lukas/hexapod-cad/stl_reference/README.md

# Reference / simulation meshes (not for printing)

Bought-part visuals, fused tibia_link stand-in, and assembly_preview.
Generated by `hexapod_prototype.py` into this directory with a
`_DO_NOT_PRINT` filename suffix.

Printables live in `../stl_prototype/`.
