lukas/hexapod-cad/vehicles/README.md

# Wheeled vehicles

Wheeled projects live here rather than under `hexapod_walker/`. Each project
owns its CAD source, generated design records, assembly instructions, and
BuildViz targets.

- [`tt_kid_truck/`](tt_kid_truck/) — printable four-wheel TT-motor pickup
  truck built around the DIANN motor/wheel and L298N kit.
