lukas/hexapod-cad/arm/stl_reference/README.md

# Reference meshes (not for printing)

Arm assembly preview generated by `arm.py` into this directory with a
`_DO_NOT_PRINT` filename suffix.

Printables live in `../stl_arm/`.
