lukas/hexapod-cad/apriltags/tag36h11_0-15_letter.pdf

tag36h11 • IDs 0-15 • print Actual size / 100% • cut on gray dashes • black square ~ 1.492 in (37.9 mm)

0 | 1 | 2 | 3
4 | 5 | 6 | 7
8 | 9 | 10 | 11
12 | 13 | 14 | 15
