lukas/hexapod-cad/apriltag_lids/out/preview_tag36h11_01-16.png

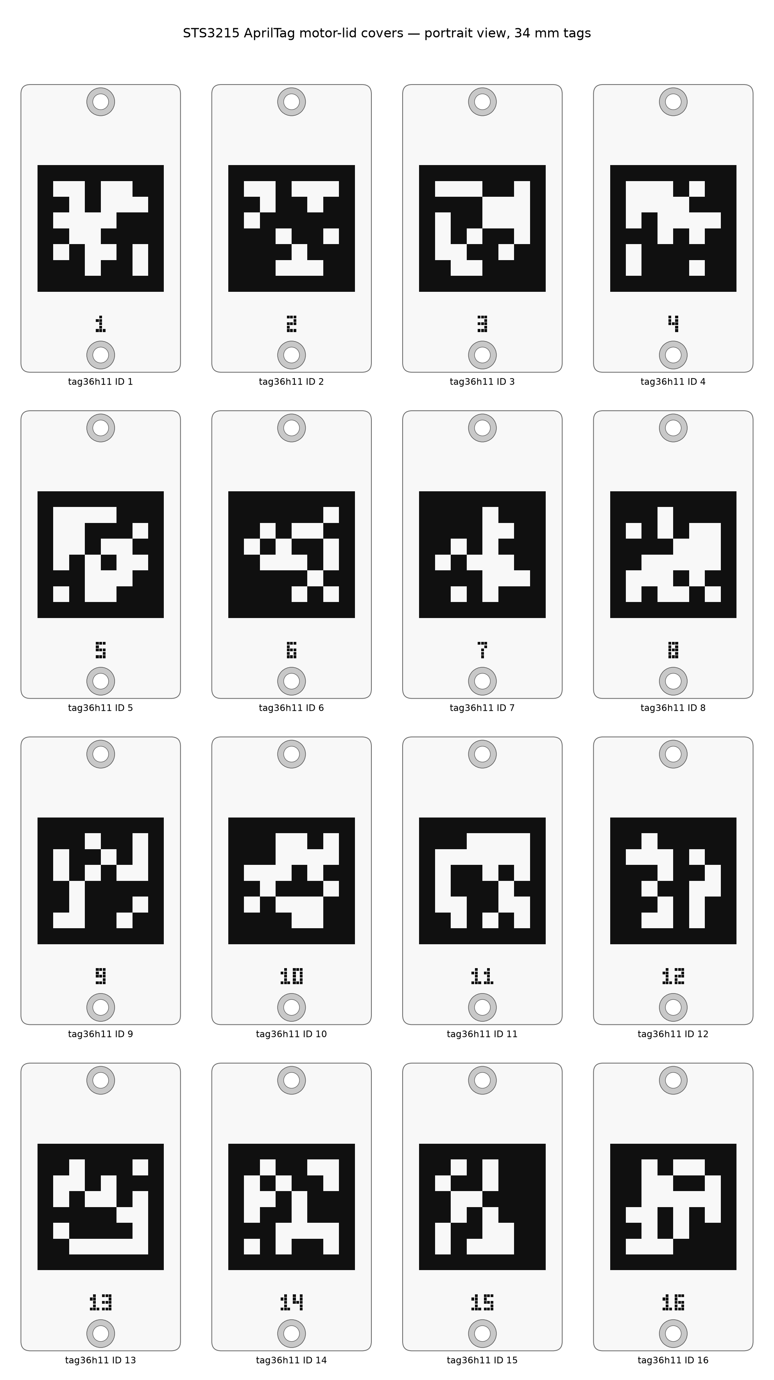
apriltag_lids/out/preview_tag36h11_01-16.png
