lukas/hexapod-cad/concepts/cnc_chorn_overhead/preview.png

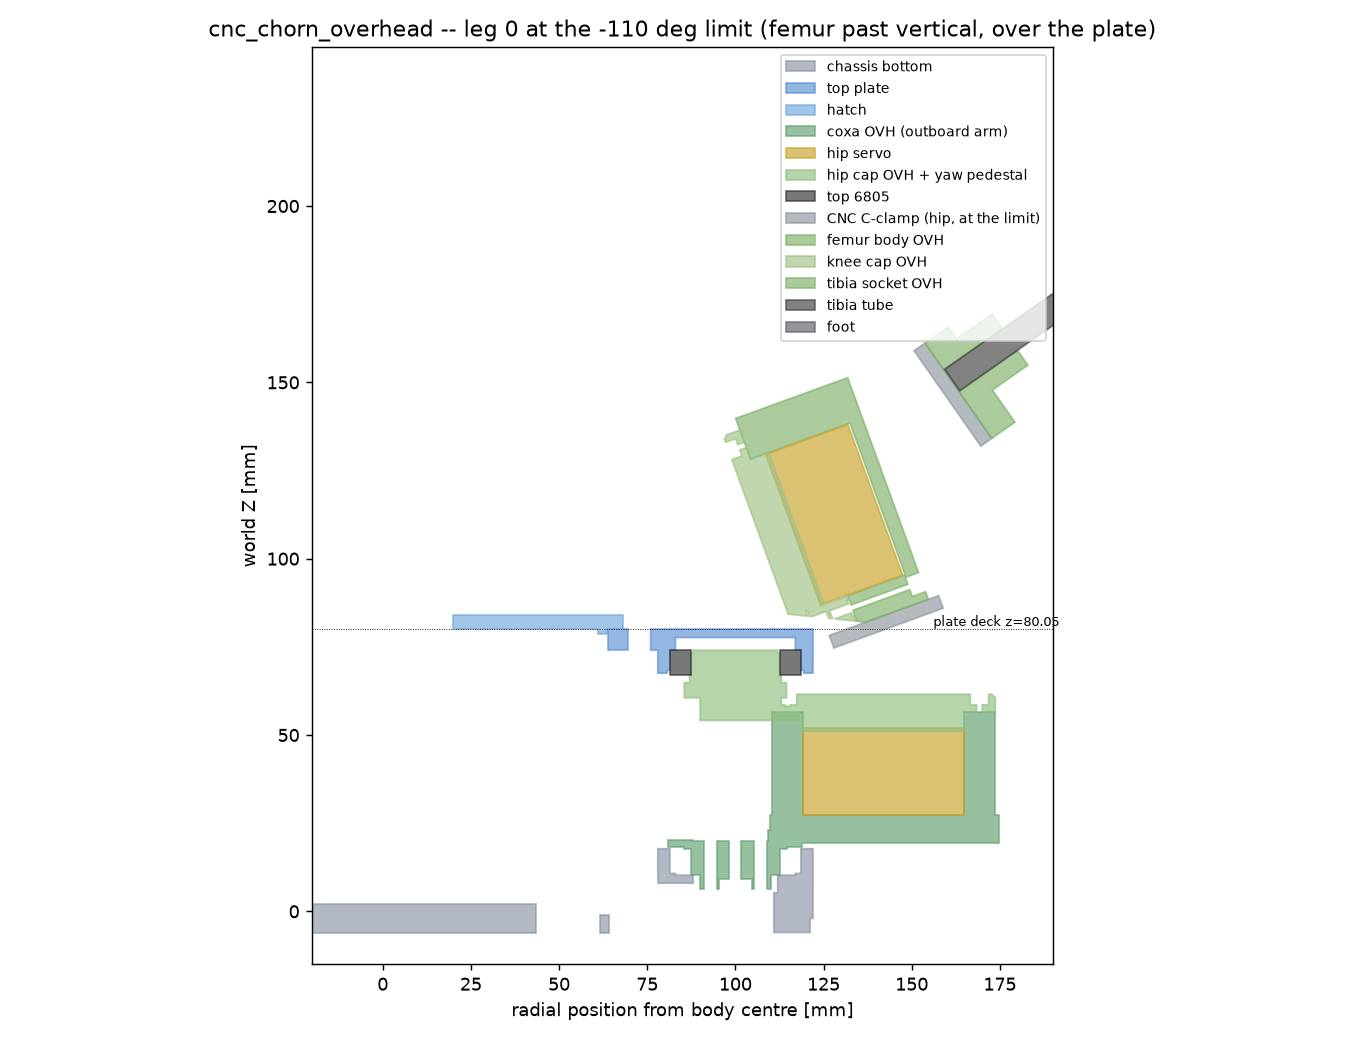
concepts/cnc_chorn_overhead/preview.png
