lukas/hexapod-cad/concepts/dovetail_coxa/preview.png

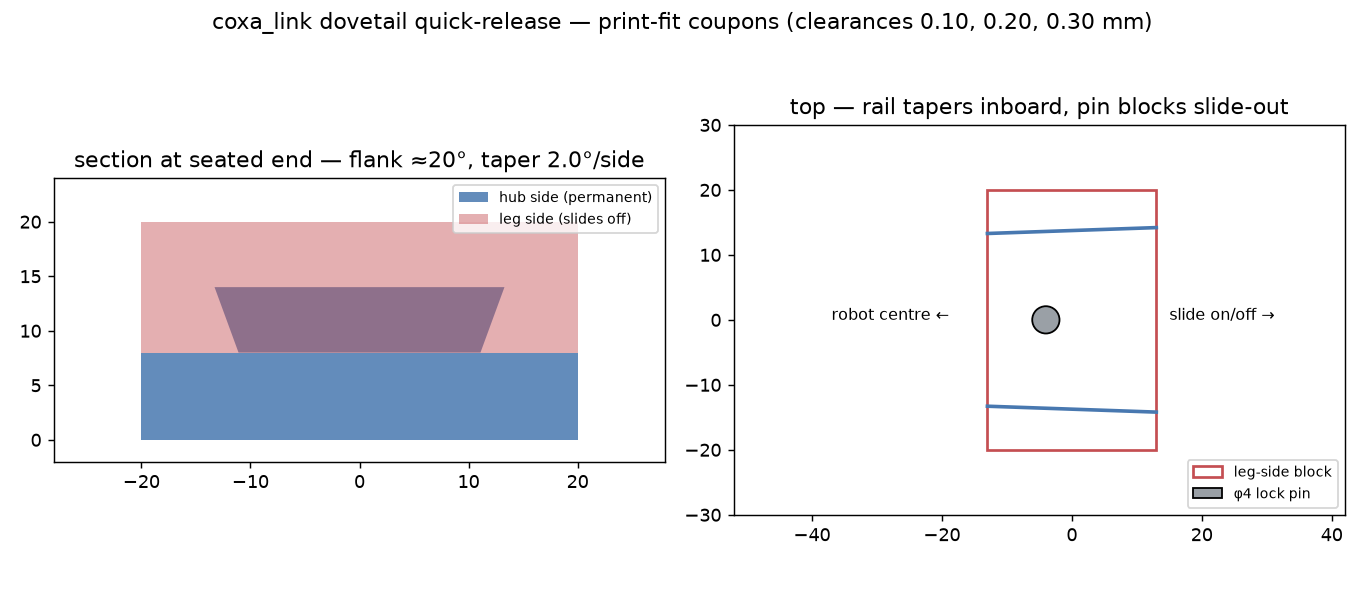
concepts/dovetail_coxa/preview.png
