lukas/hexapod-cad/concepts/dovetail_coxa/preview_split.png

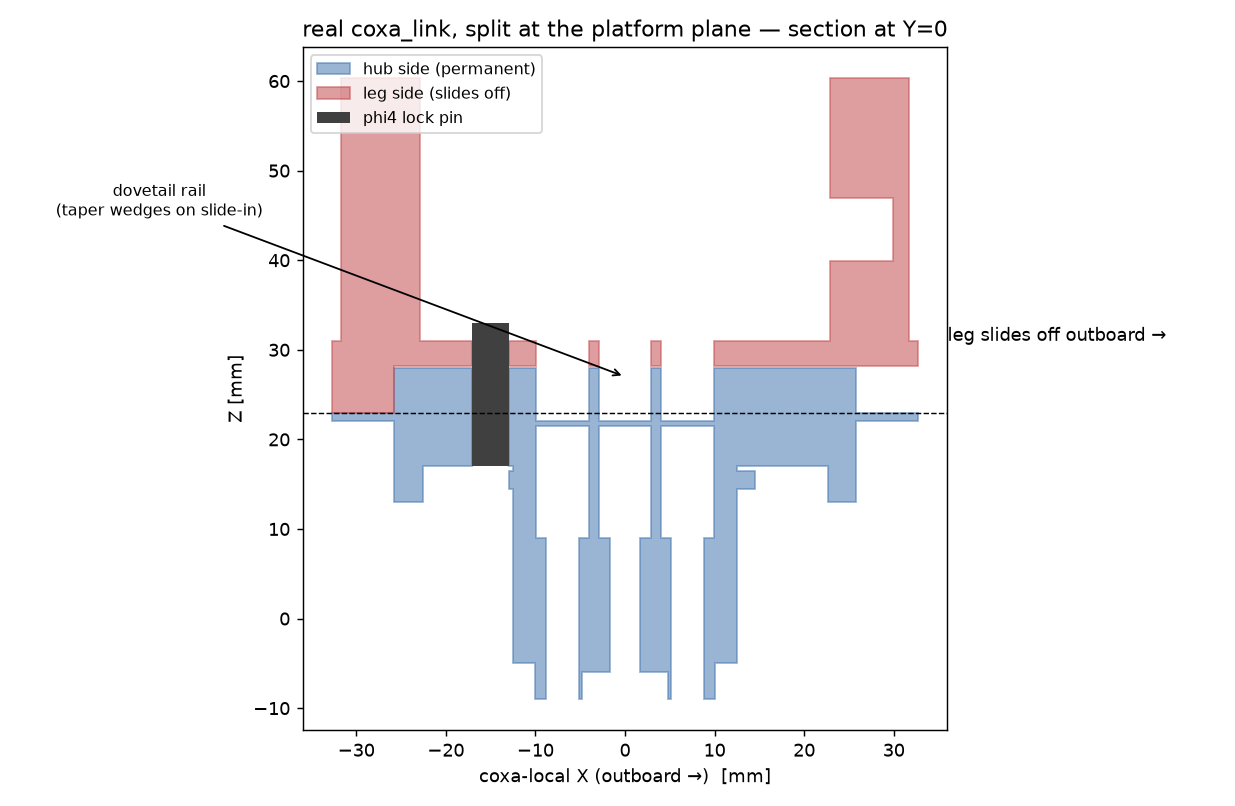
concepts/dovetail_coxa/preview_split.png
