lukas/hexapod-cad/concepts/premade_chorn_56/preview.png

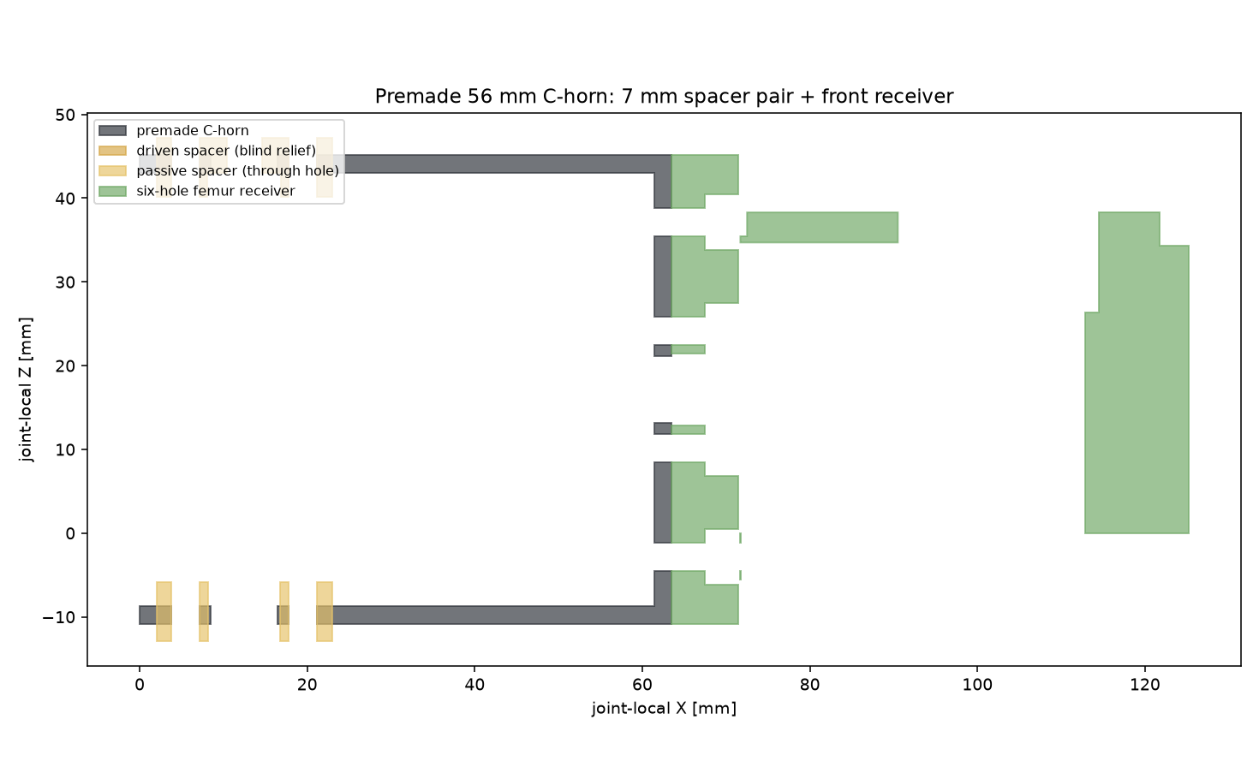
concepts/premade_chorn_56/preview.png
