lukas/hexapod-cad/concepts/qr_femur/preview.png

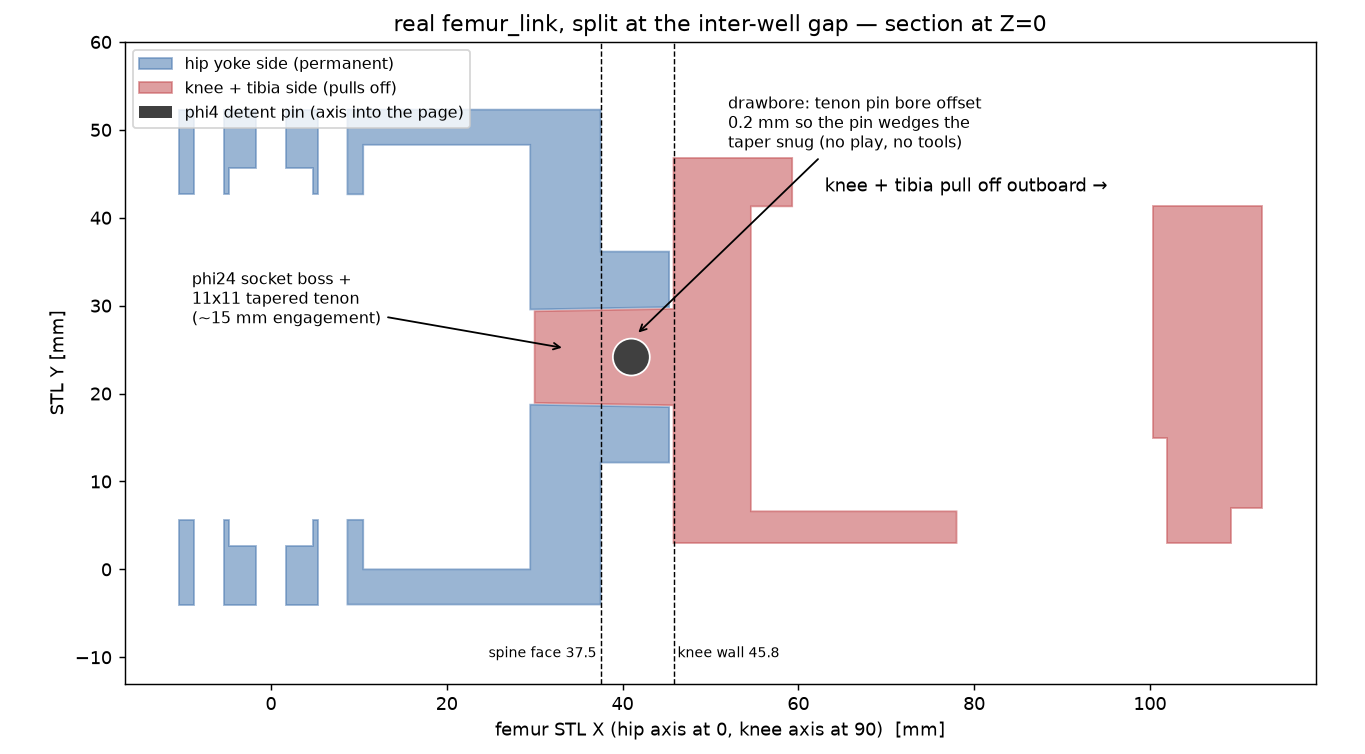
concepts/qr_femur/preview.png
