lukas/hexapod-cad/concepts/rigid_hip/bottom_joint_change.png

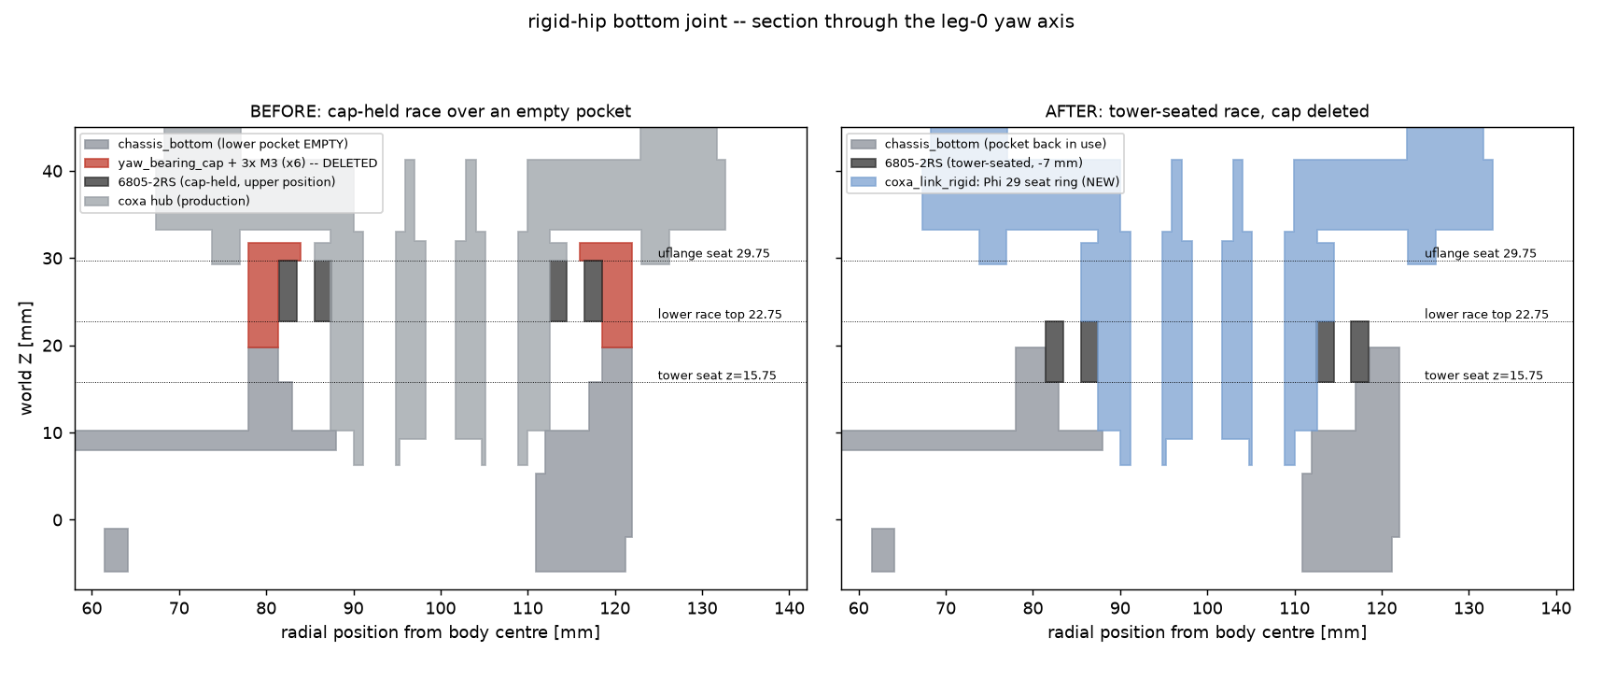
concepts/rigid_hip/bottom_joint_change.png
