lukas/hexapod-cad/concepts/rigid_hip/chassis_corner_round.png

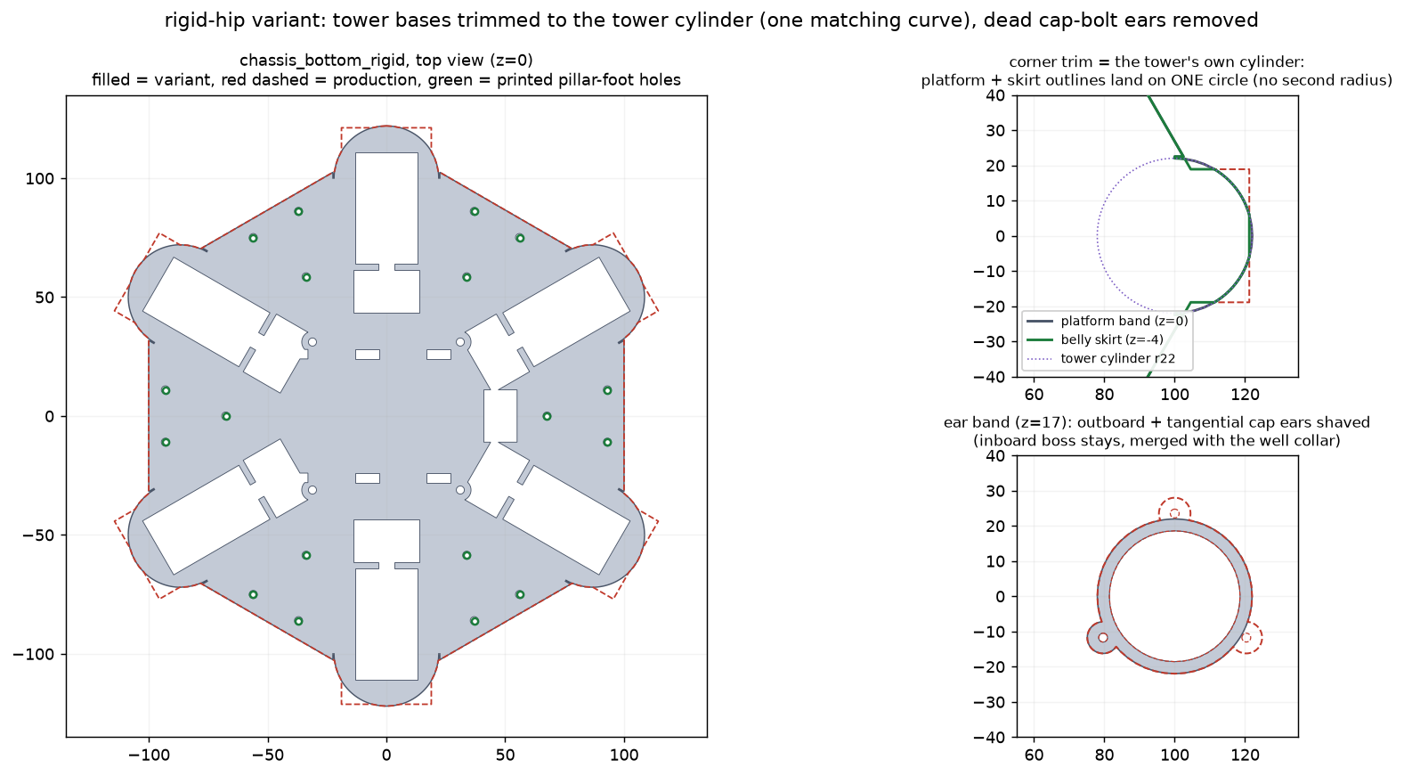
concepts/rigid_hip/chassis_corner_round.png
