lukas/hexapod-cad/concepts/rigid_hip/chassis_top_clean.png

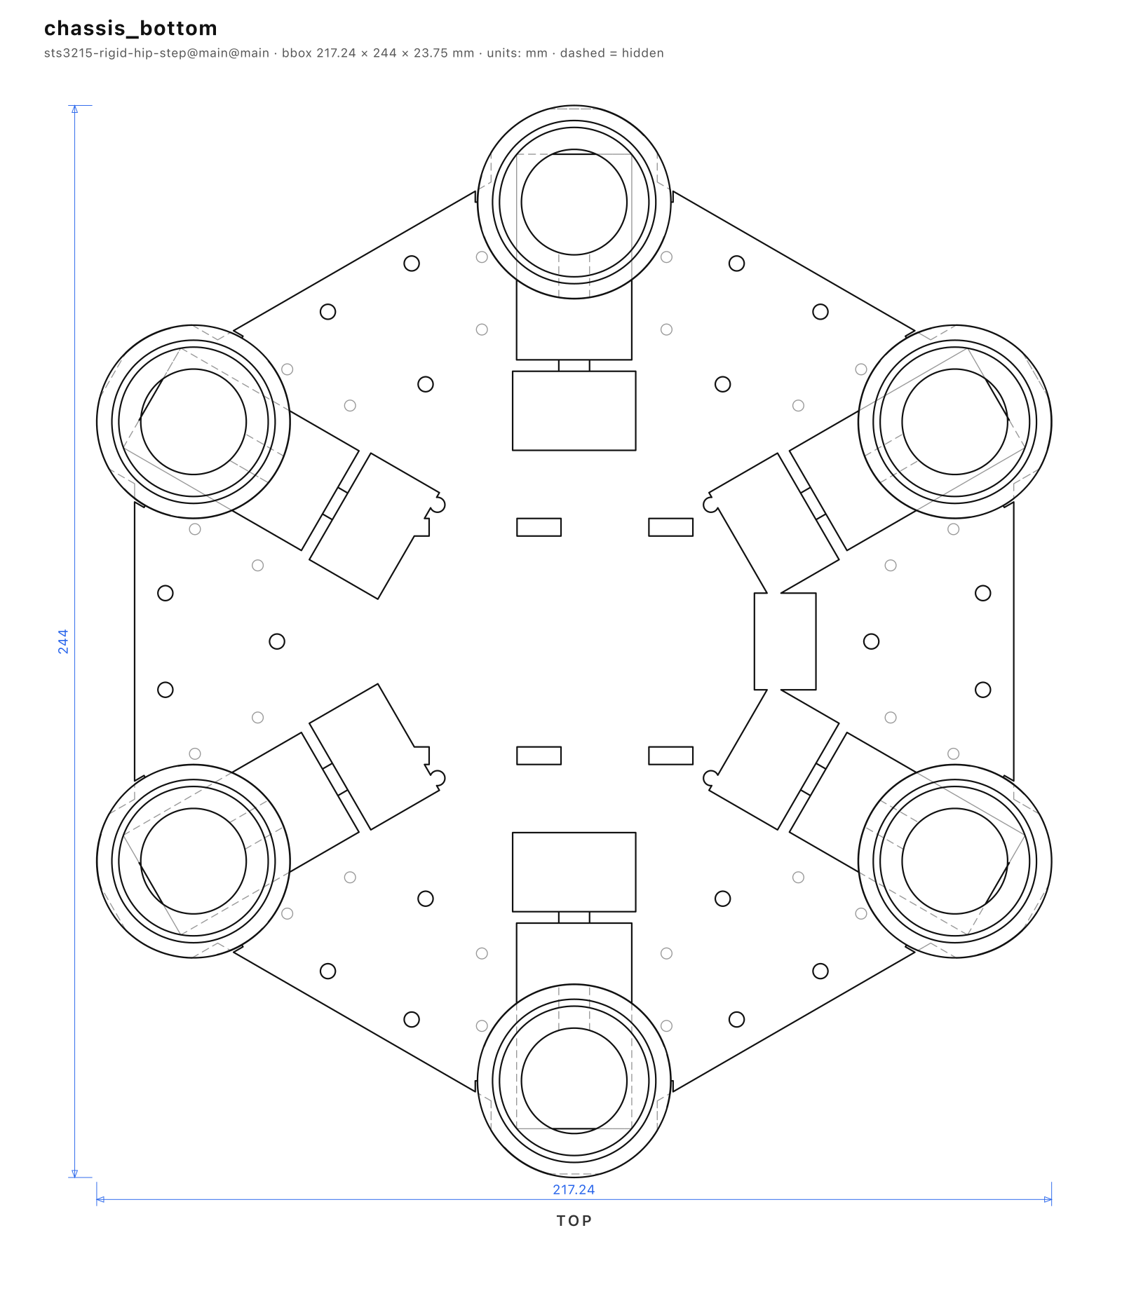
concepts/rigid_hip/chassis_top_clean.png
