lukas/hexapod-cad/concepts/rigid_hip/corner_flat_owners.png

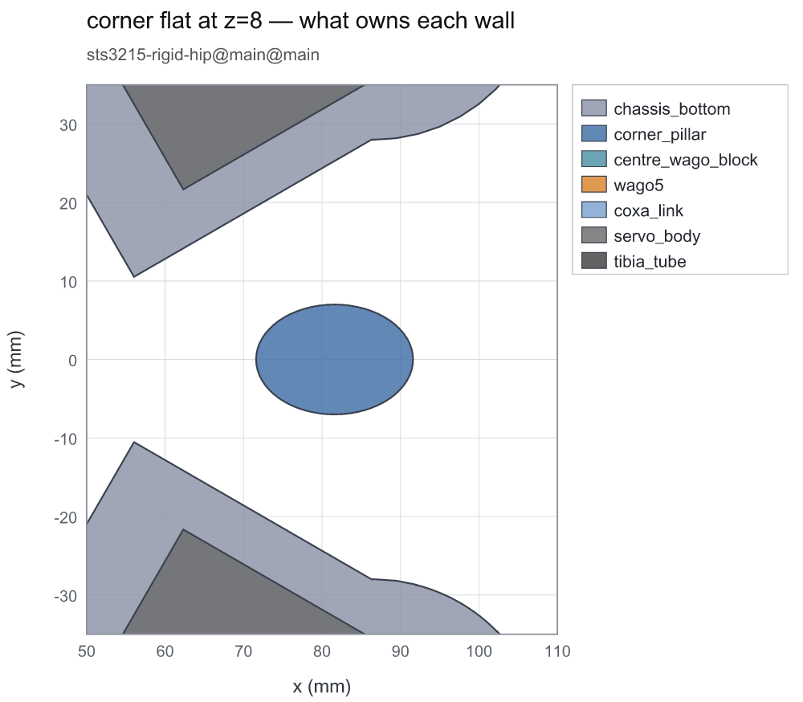
concepts/rigid_hip/corner_flat_owners.png
