lukas/hexapod-cad/concepts/rigid_hip/corner_flattened_annotated.png

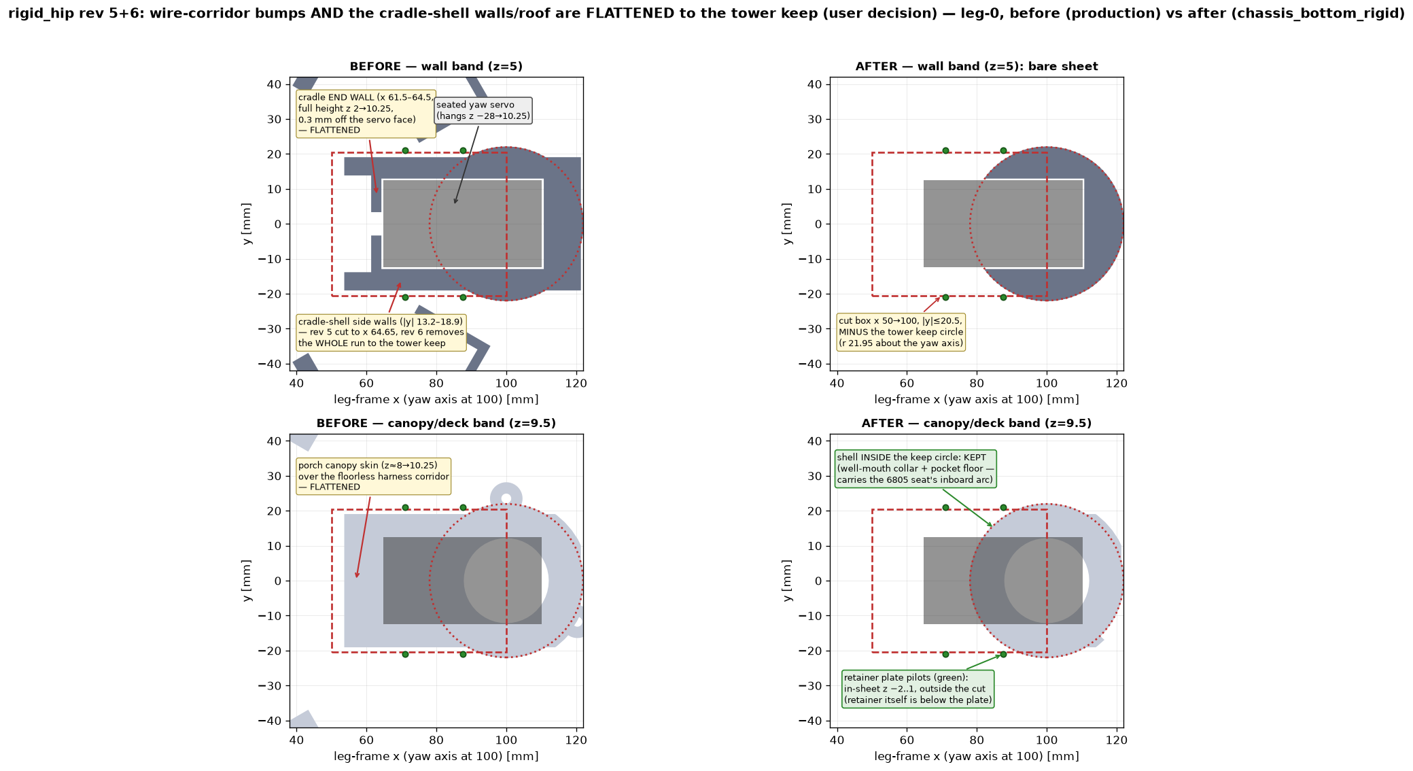
concepts/rigid_hip/corner_flattened_annotated.png
