lukas/hexapod-cad/concepts/rigid_hip/joint_column_annotated.png

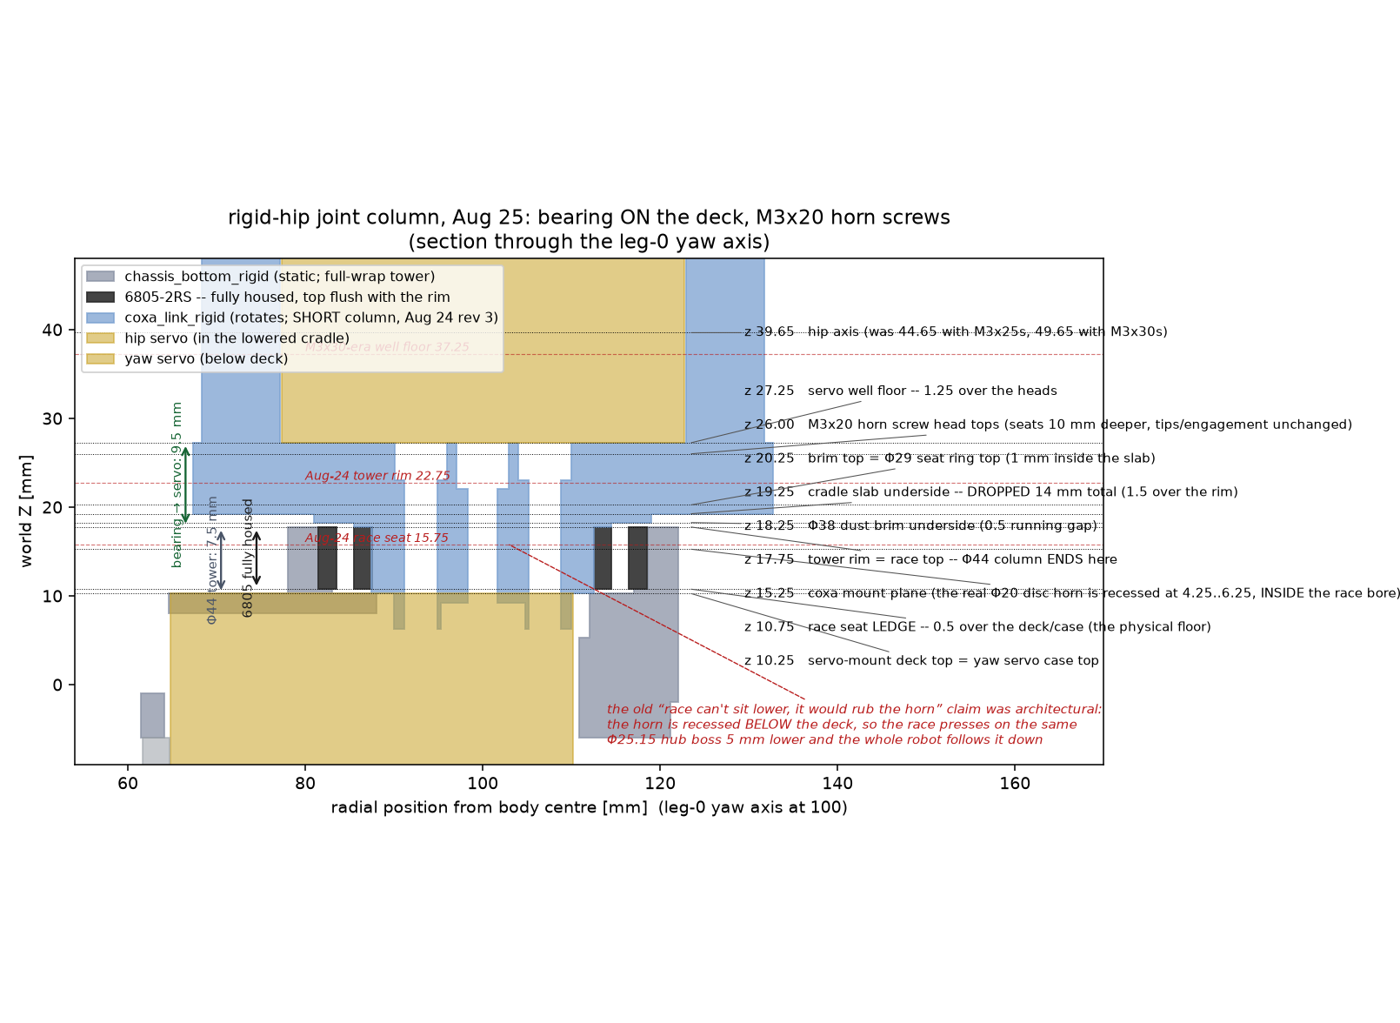
concepts/rigid_hip/joint_column_annotated.png
