lukas/hexapod-cad/concepts/rigid_hip/keepout_section.png

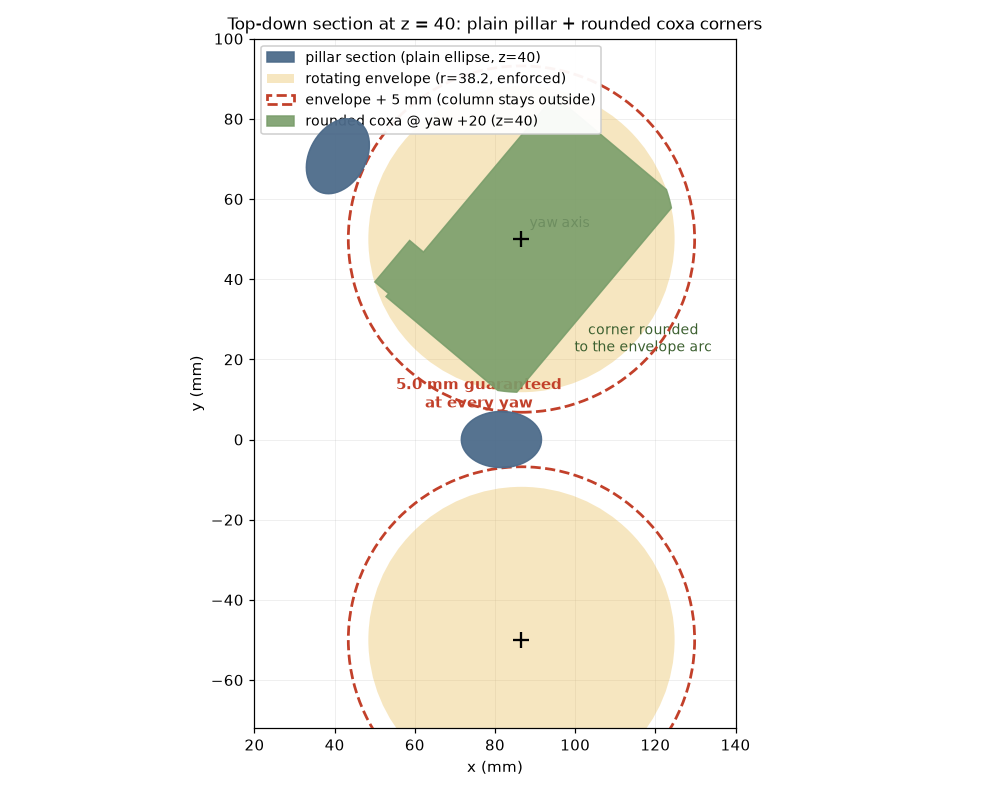
concepts/rigid_hip/keepout_section.png
