lukas/hexapod-cad/concepts/rigid_hip/pillar_context.png

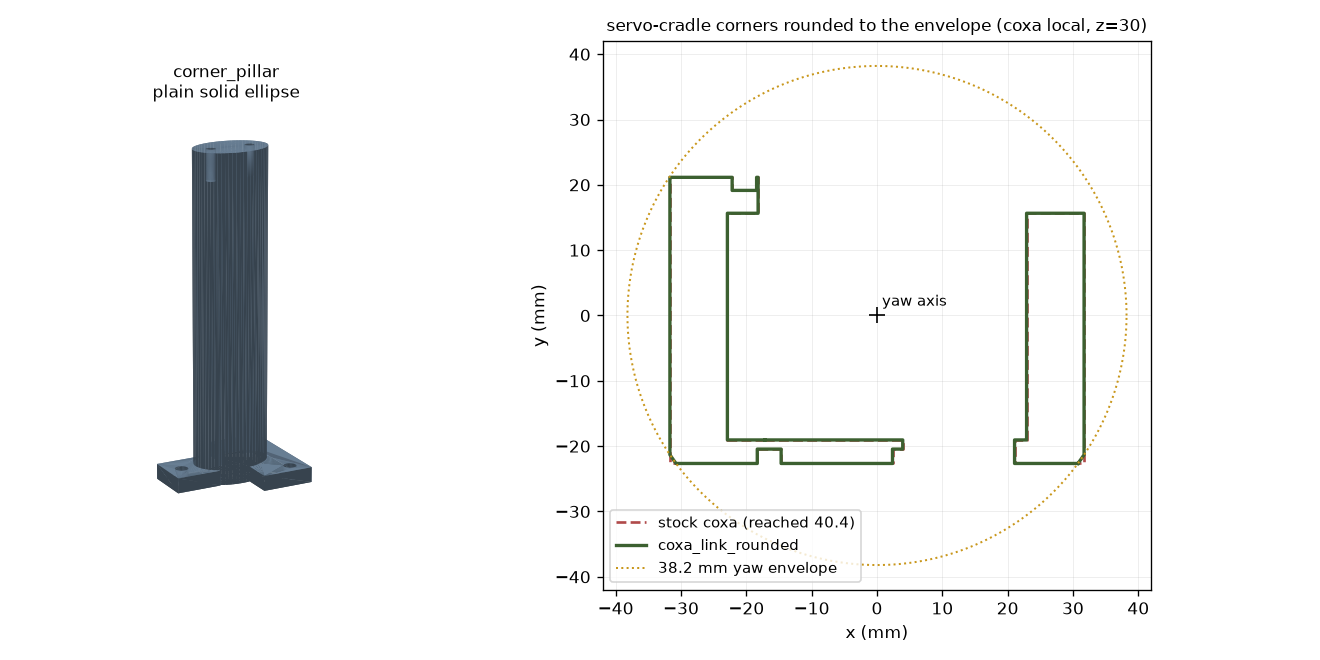
concepts/rigid_hip/pillar_context.png
