lukas/hexapod-cad/concepts/rigid_hip/pillar_stubs_annotated.png

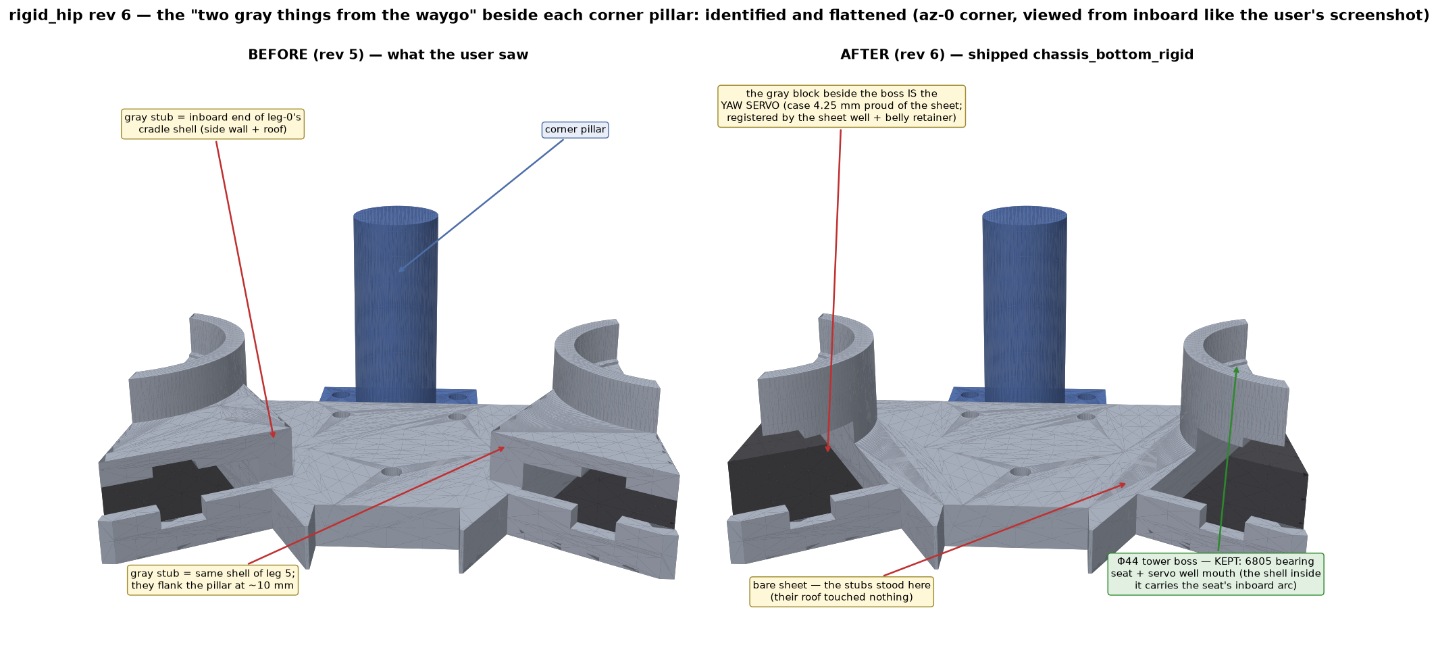
concepts/rigid_hip/pillar_stubs_annotated.png
