lukas/hexapod-cad/concepts/rigid_hip/preview.png

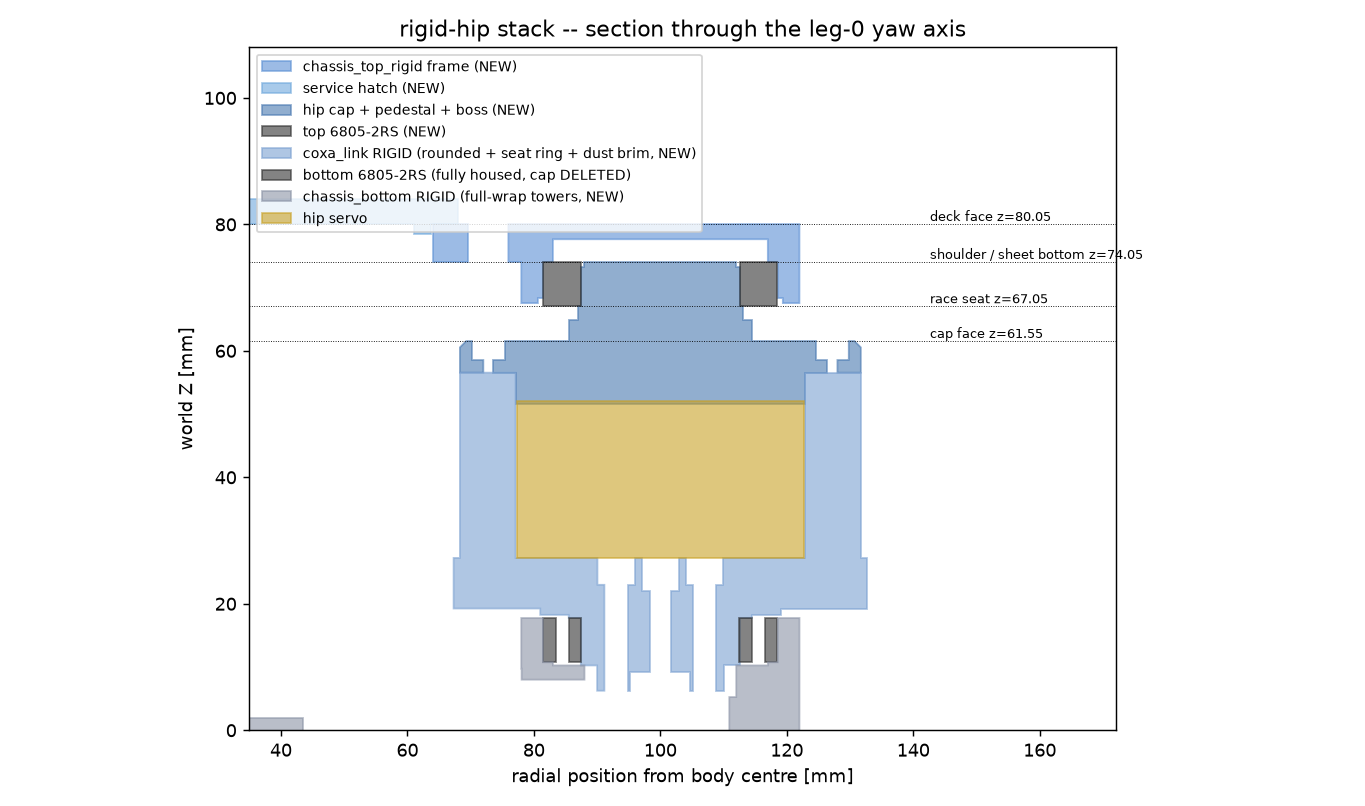
concepts/rigid_hip/preview.png
