lukas/hexapod-cad/concepts/rigid_hip/tower_flank_smoothed.png

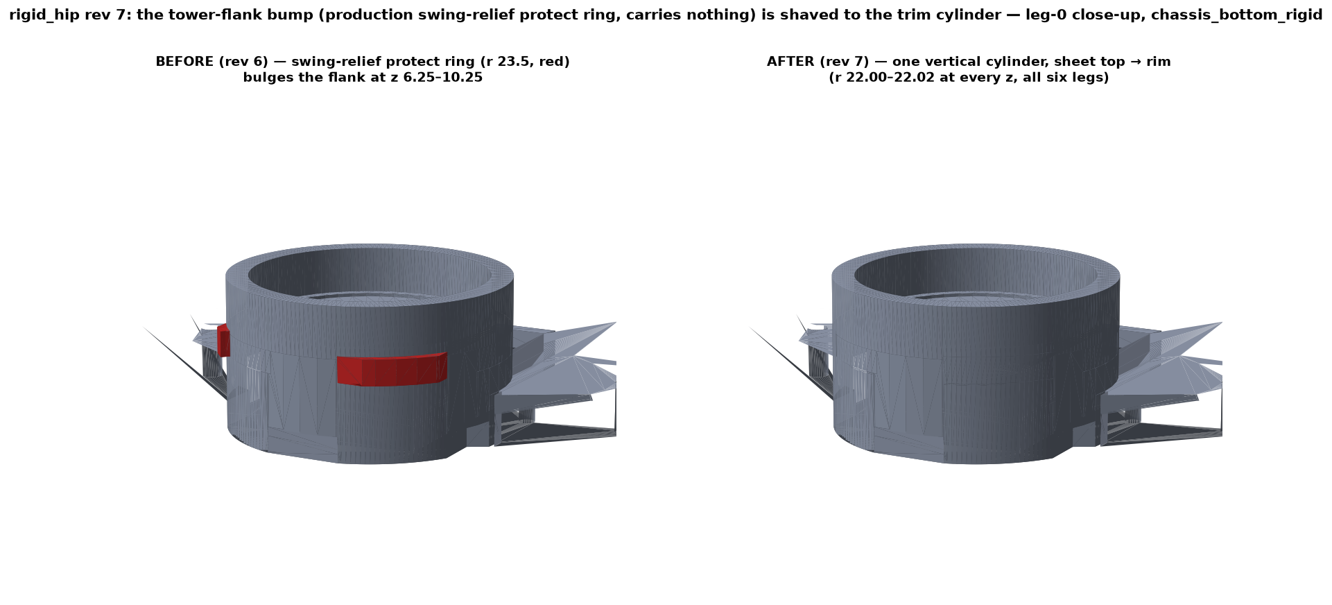
concepts/rigid_hip/tower_flank_smoothed.png
