lukas/hexapod-cad/concepts/rigid_hip/wago_block_context.png

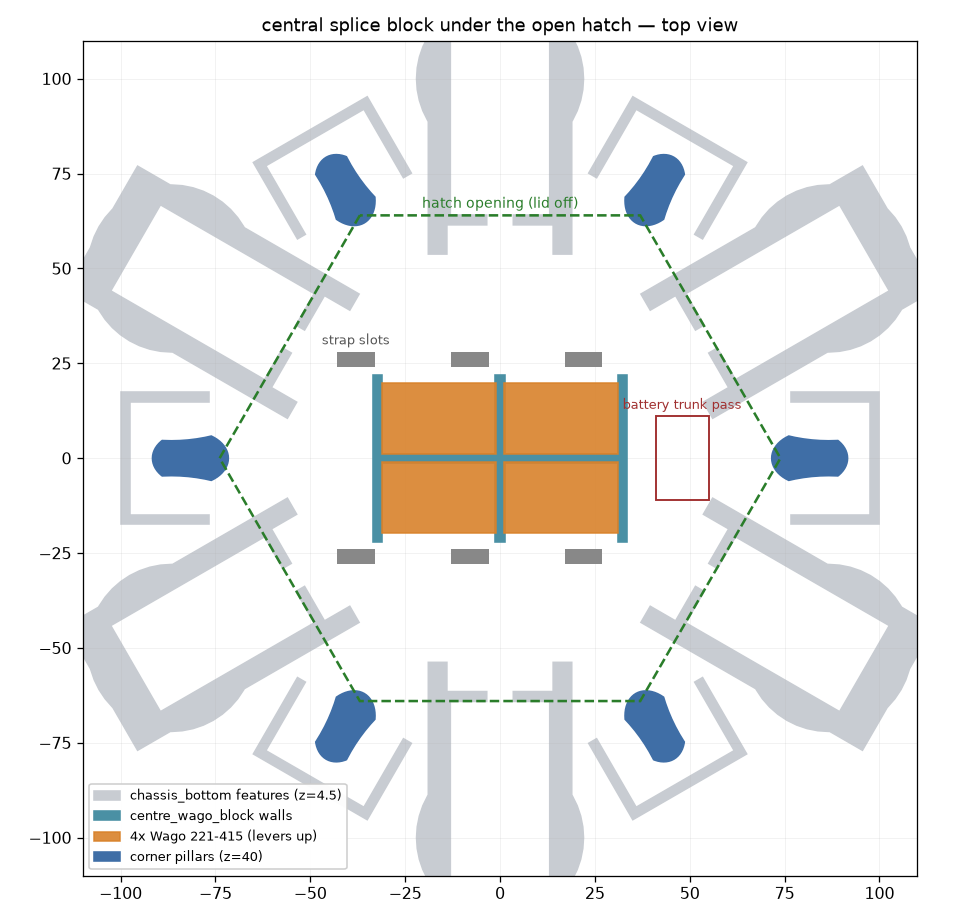
concepts/rigid_hip/wago_block_context.png
