lukas/hexapod-cad/concepts/sensor_full_foot/contact_section.png

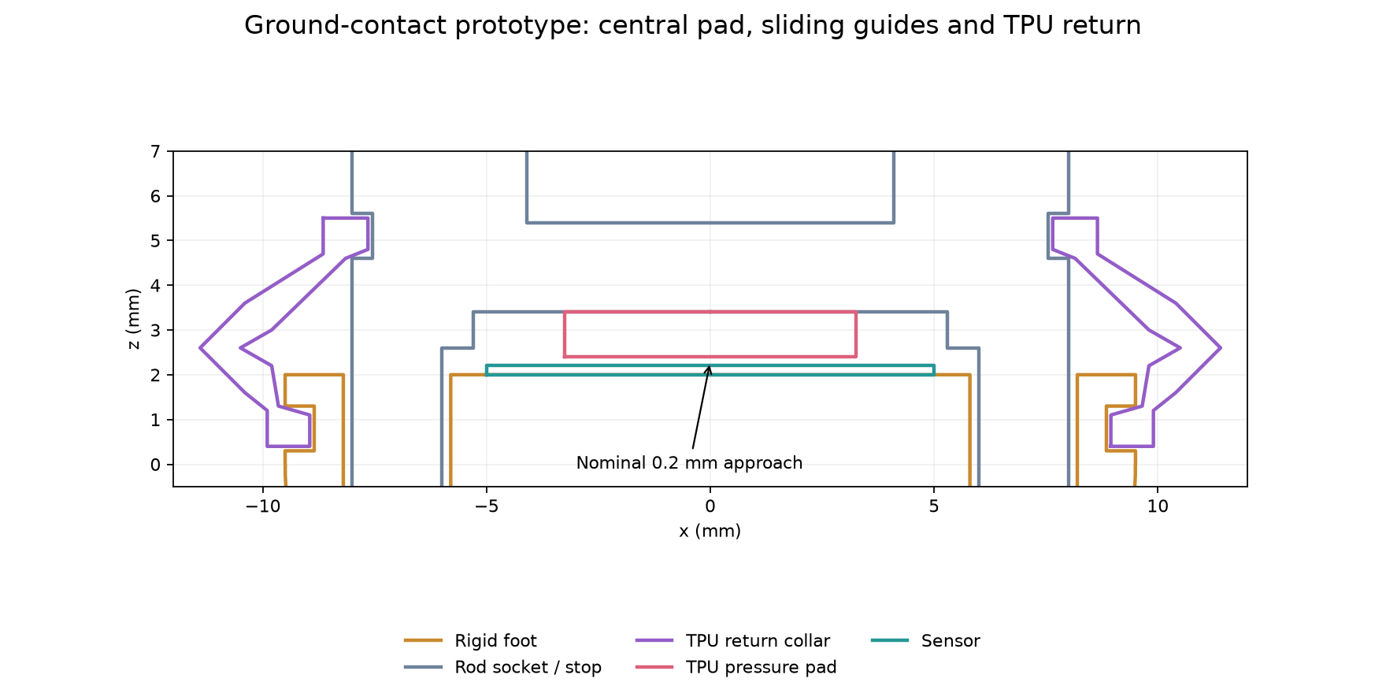
concepts/sensor_full_foot/contact_section.png
