lukas/hexapod-cad/concepts/sensor_semicircle_foot/preview.png

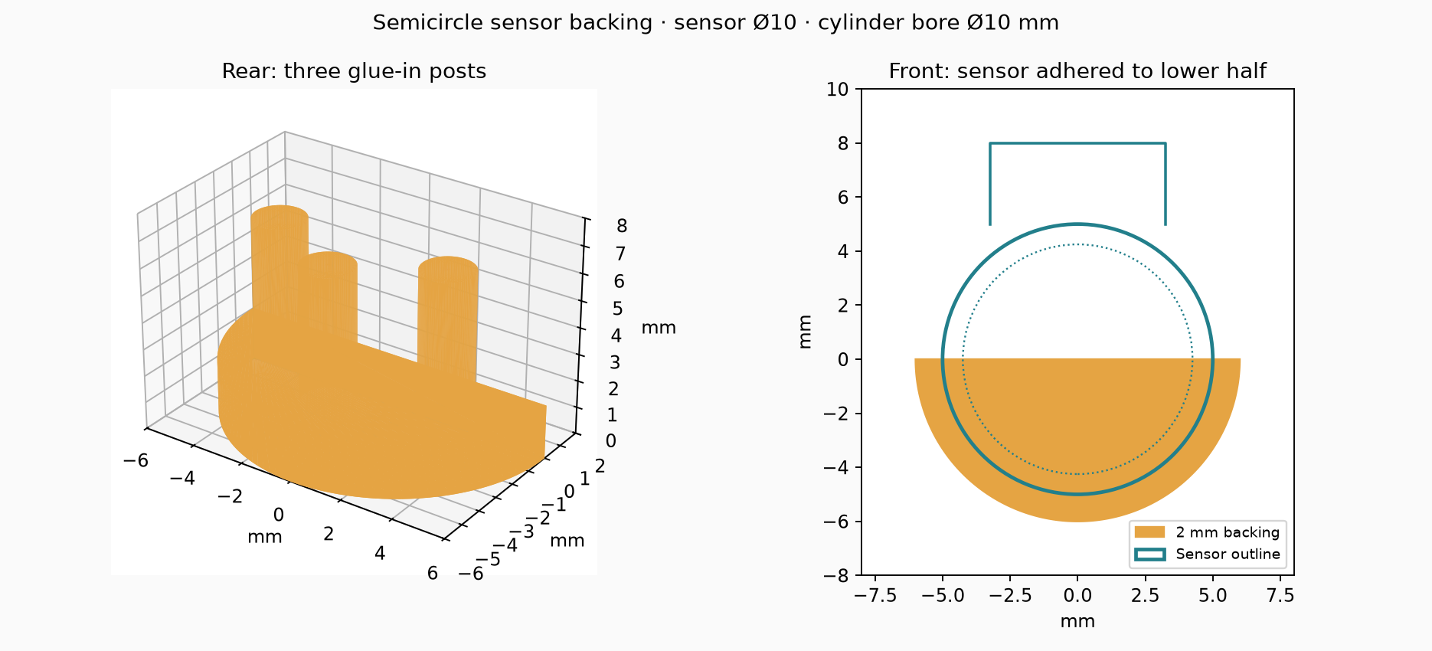
concepts/sensor_semicircle_foot/preview.png
