lukas/hexapod-cad/full_robot_viz/default_view.png

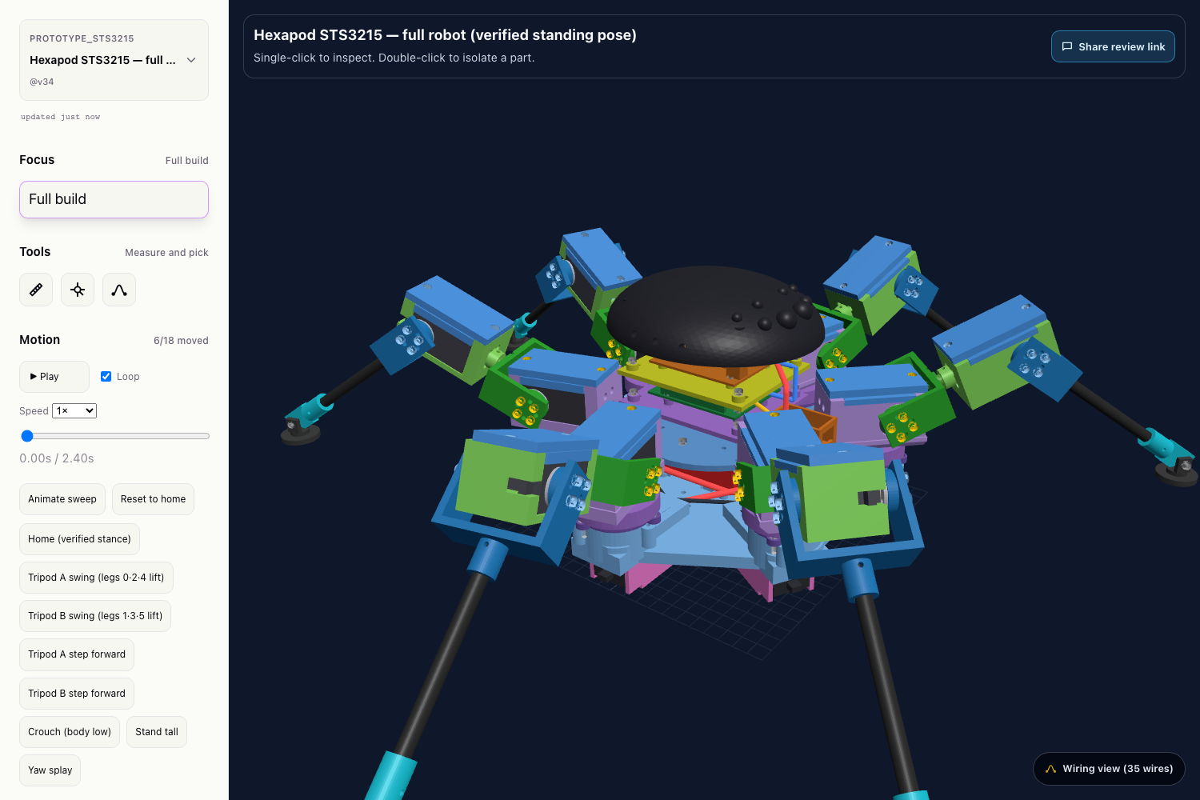
full_robot_viz/default_view.png
