lukas/hexapod-cad/full_robot_viz/hip_joint_screws.png

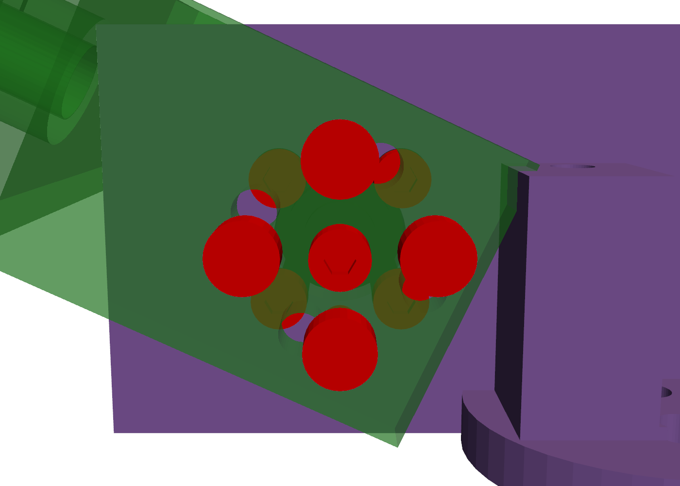
full_robot_viz/hip_joint_screws.png
