lukas/hexapod-cad/full_robot_viz/leg_pins.png

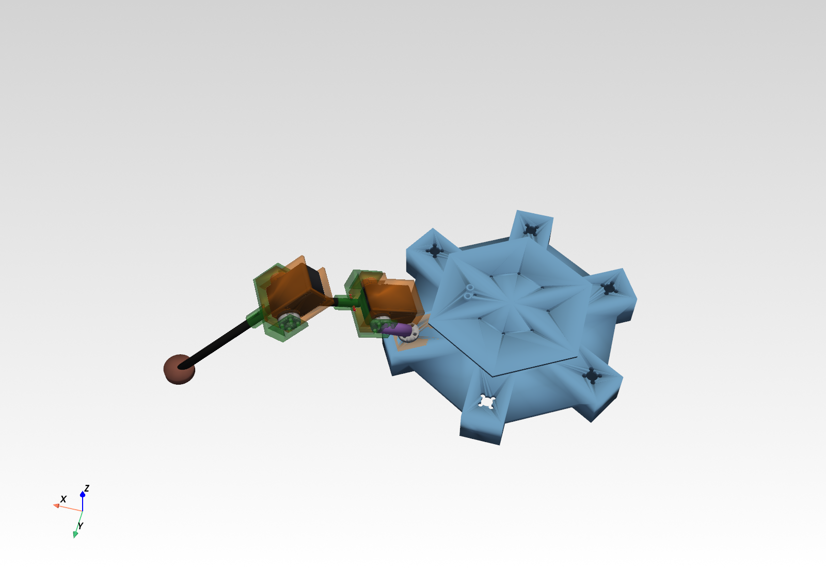
full_robot_viz/leg_pins.png
