lukas/hexapod-cad/full_robot_viz/robot_iso.png

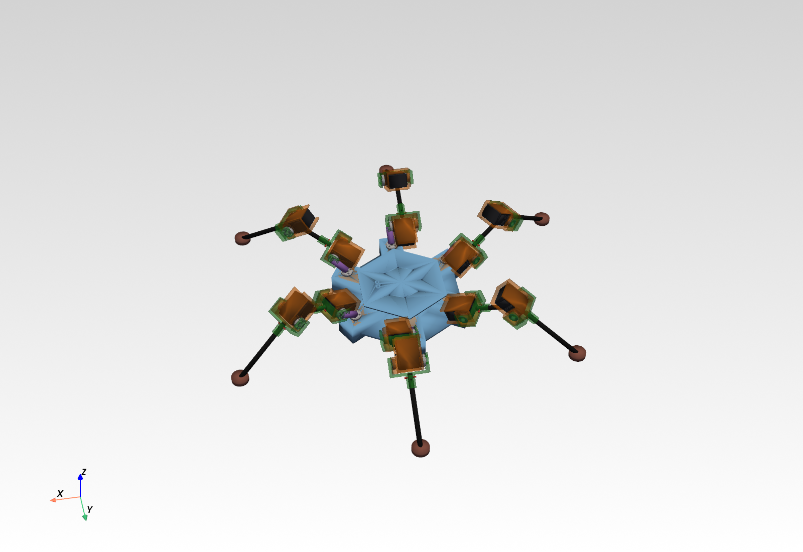
full_robot_viz/robot_iso.png
