lukas/hexapod-cad/full_robot_viz/robot_side.png

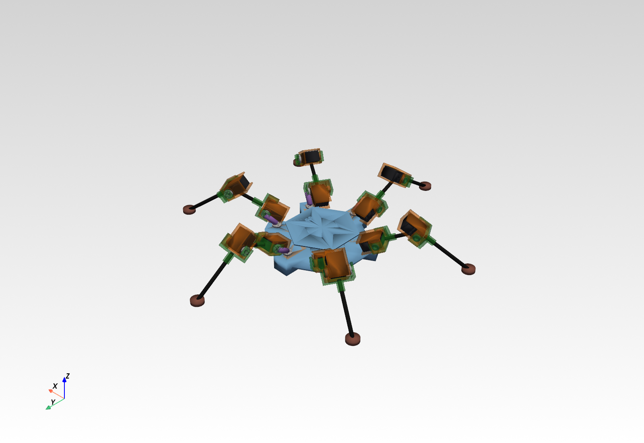
full_robot_viz/robot_side.png
