lukas/hexapod-cad/full_robot_viz/robot_spider_face.png

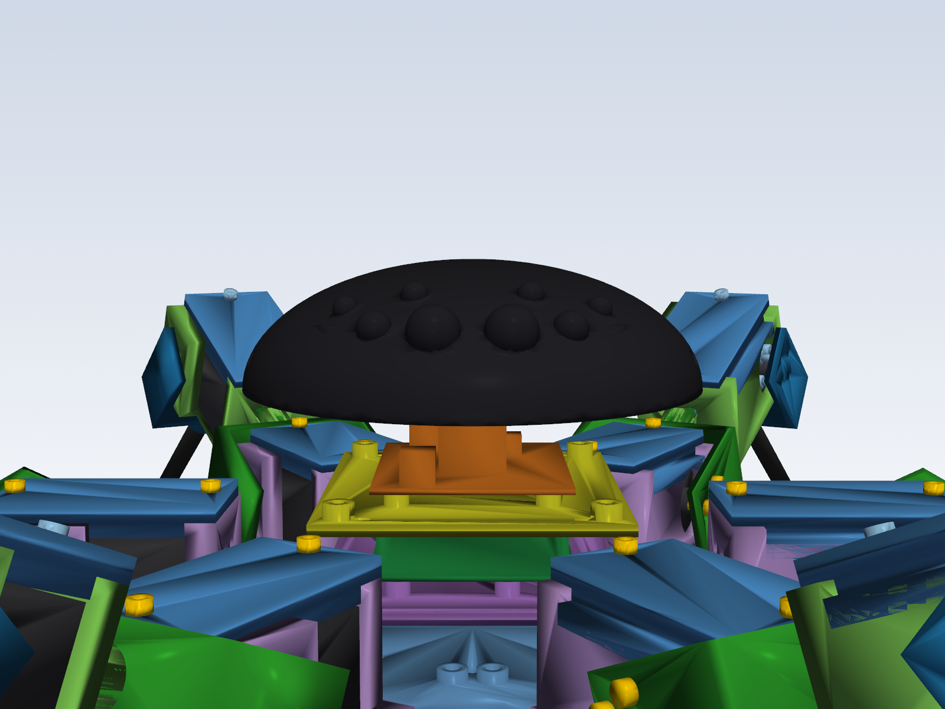
full_robot_viz/robot_spider_face.png
