lukas/hexapod-cad/full_robot_viz/robot_spider_top.png

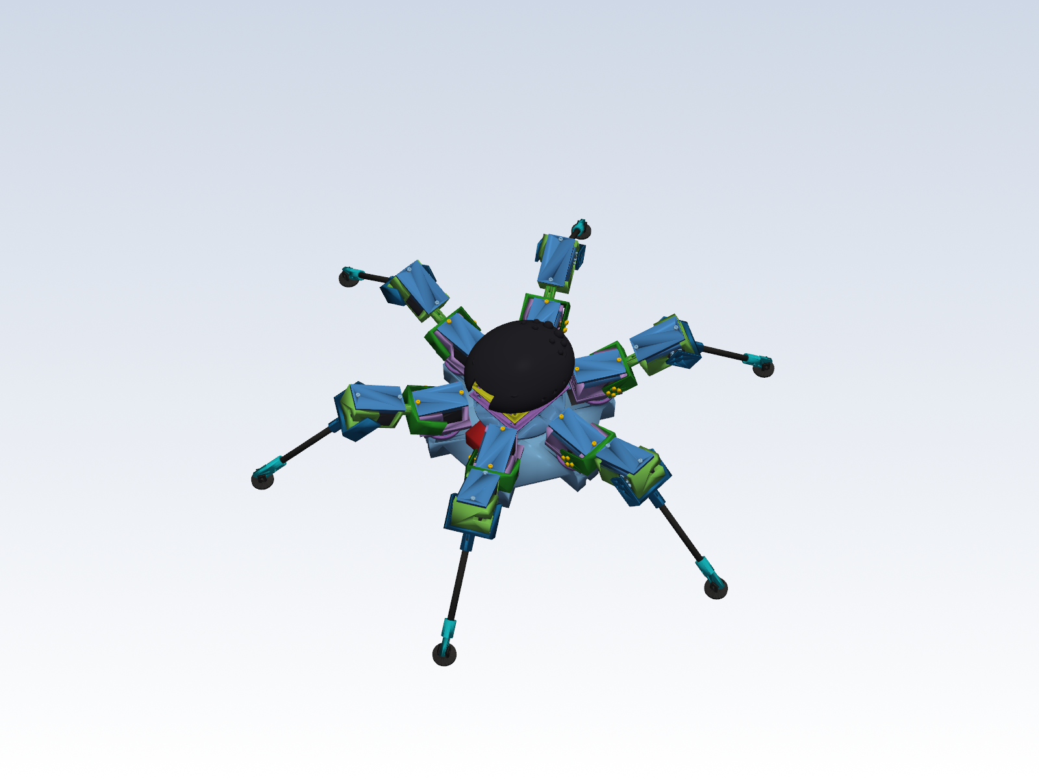
full_robot_viz/robot_spider_top.png
