lukas/hexapod-cad/full_robot_viz/screenshots/l0-femur-close.png

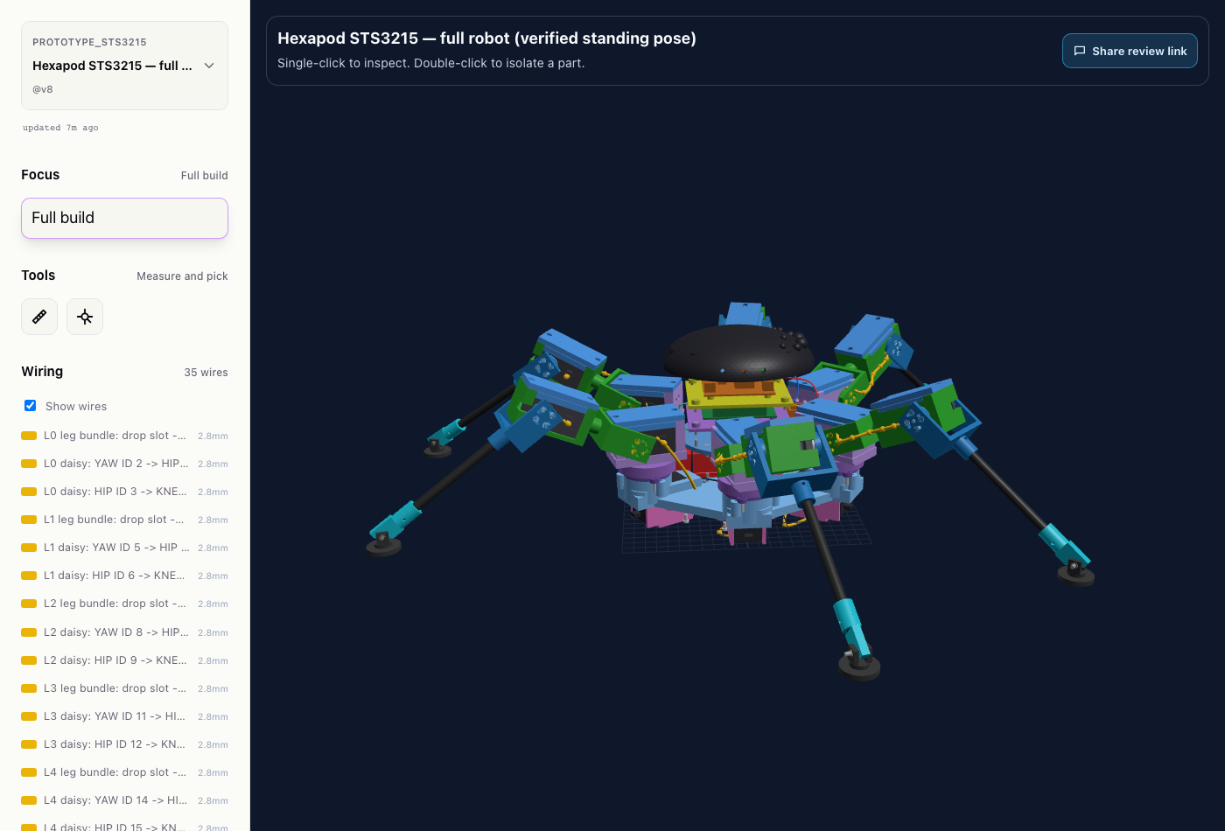
full_robot_viz/screenshots/l0-femur-close.png
