lukas/hexapod-cad/full_robot_viz/screenshots/l0-hip-close.png

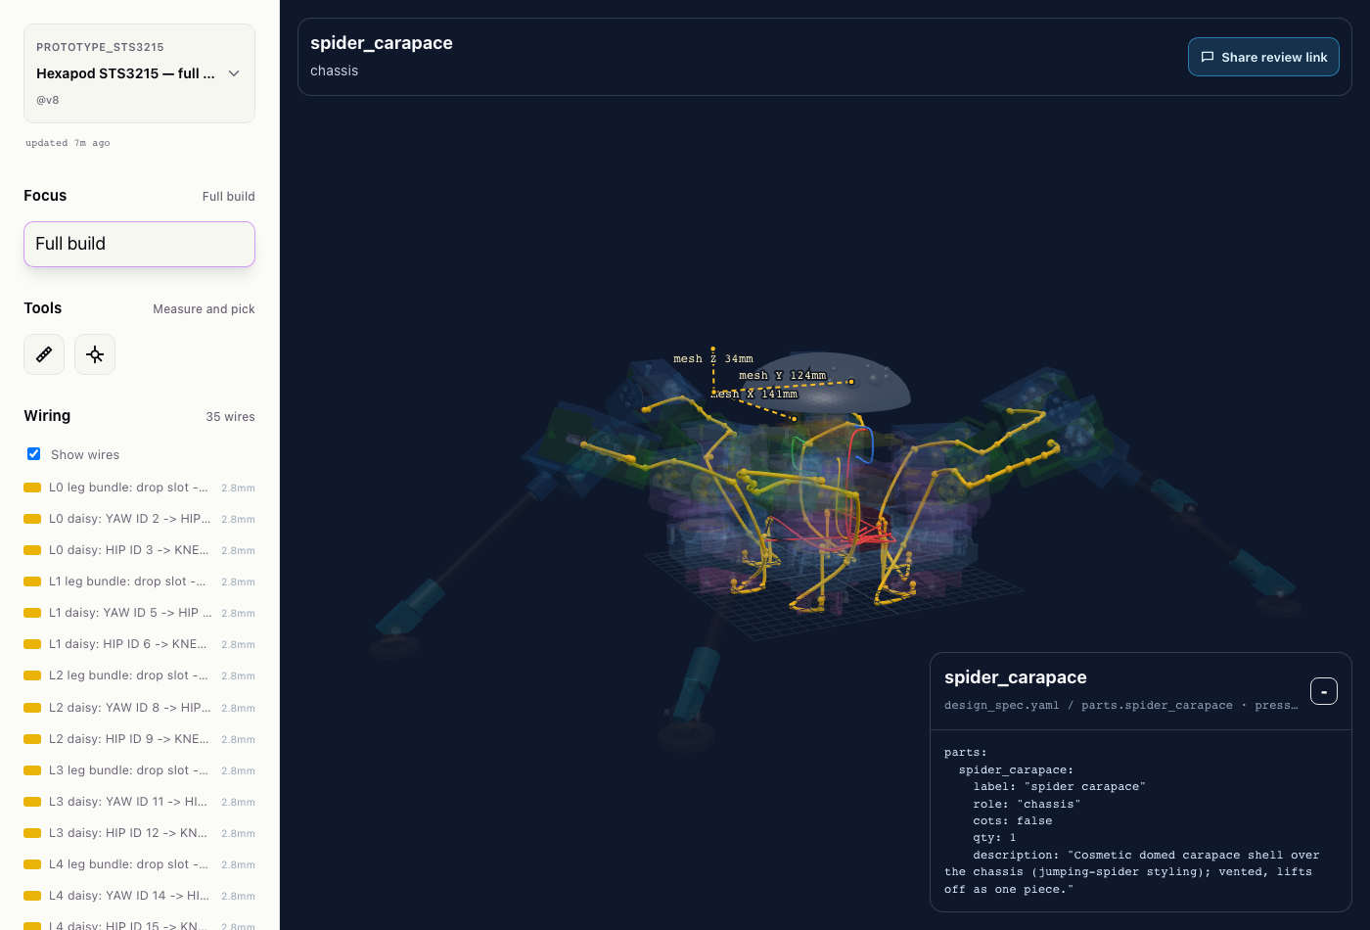
full_robot_viz/screenshots/l0-hip-close.png
