lukas/hexapod-cad/full_robot_viz/screenshots/l0-knee-close.png

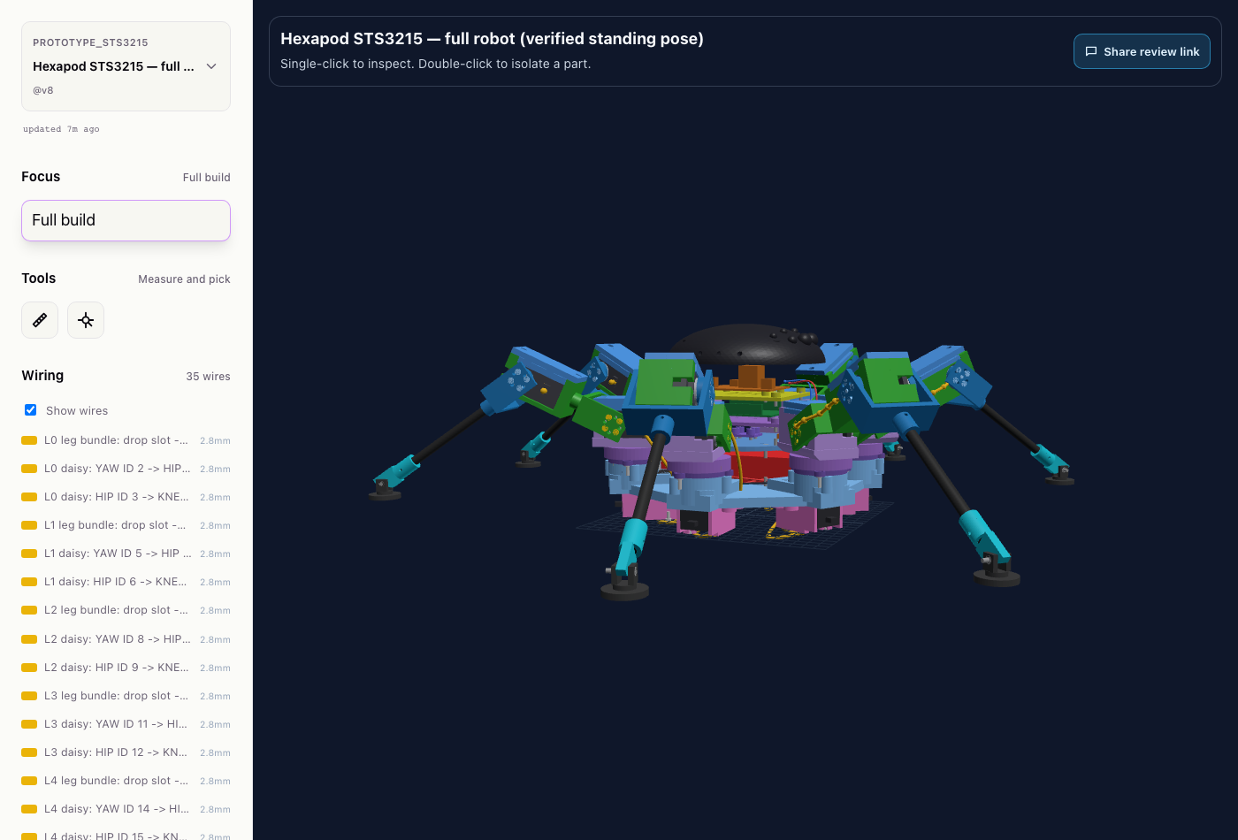
full_robot_viz/screenshots/l0-knee-close.png
