lukas/hexapod-cad/full_robot_viz/screenshots/l0-yaw-close.png

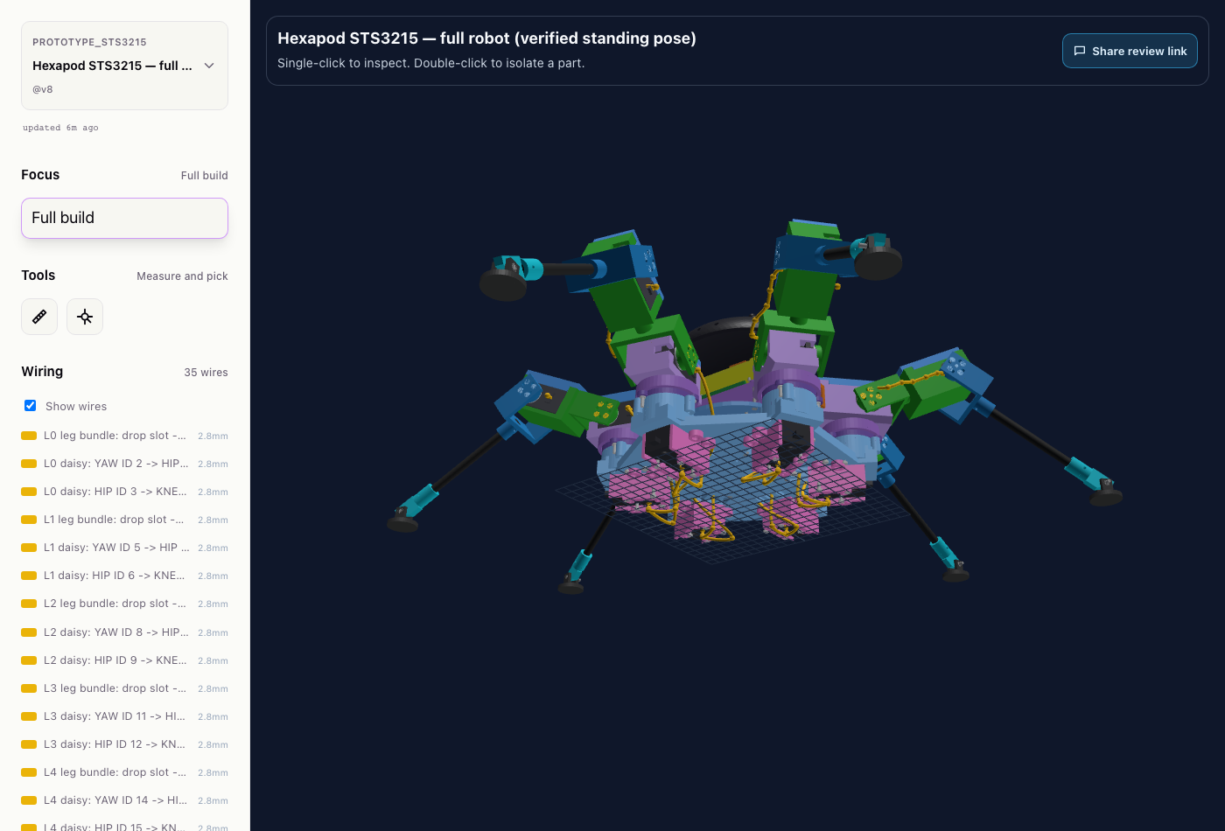
full_robot_viz/screenshots/l0-yaw-close.png
