lukas/hexapod-cad/full_robot_viz/screenshots/l0-yaw-side.png

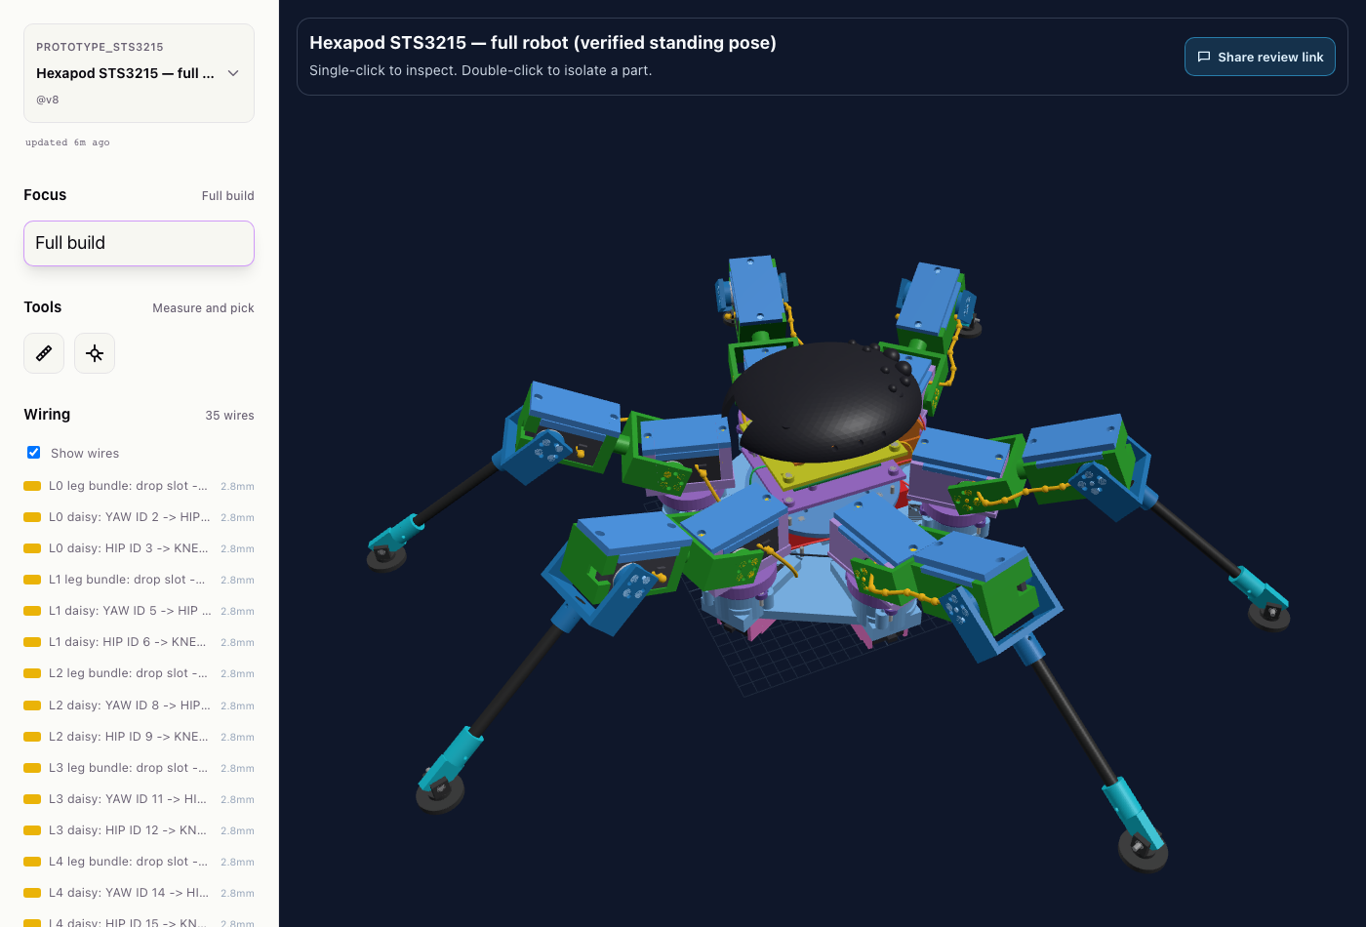
full_robot_viz/screenshots/l0-yaw-side.png
