lukas/hexapod-cad/full_robot_viz/screenshots/wires-femur-side.png

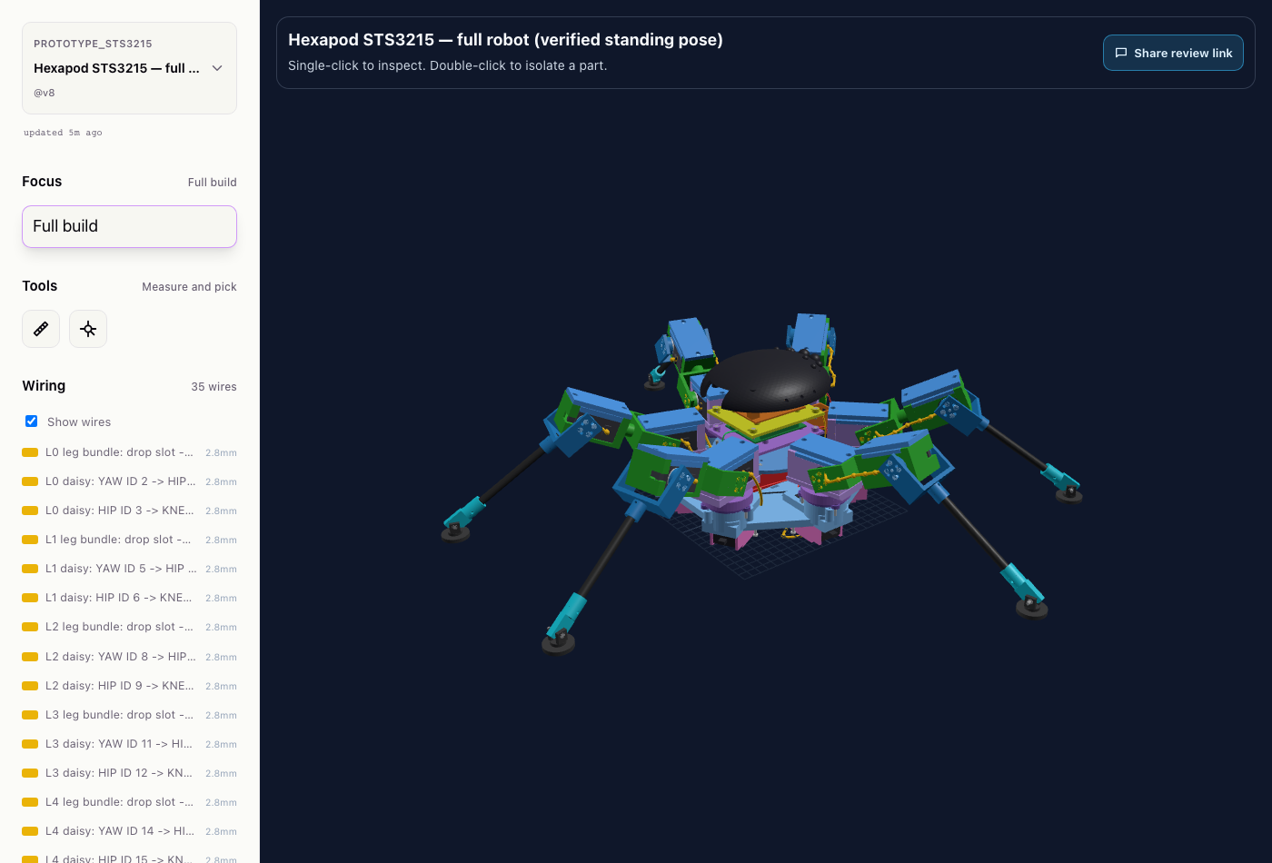
full_robot_viz/screenshots/wires-femur-side.png
