lukas/hexapod-cad/full_robot_viz/screenshots/wires-femur.png

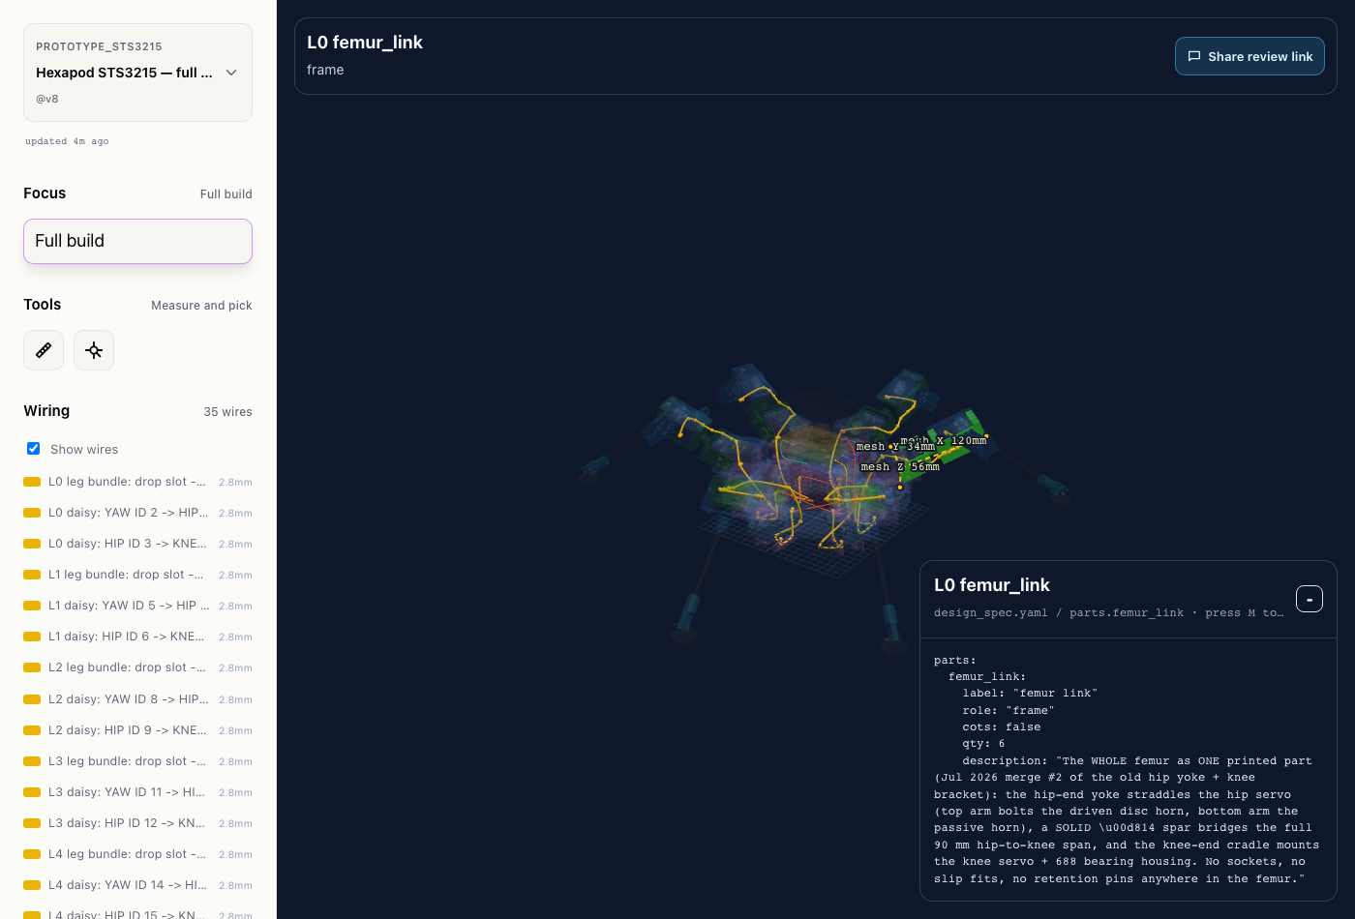
full_robot_viz/screenshots/wires-femur.png
