lukas/hexapod-cad/full_robot_viz/screenshots/wires-overview.png

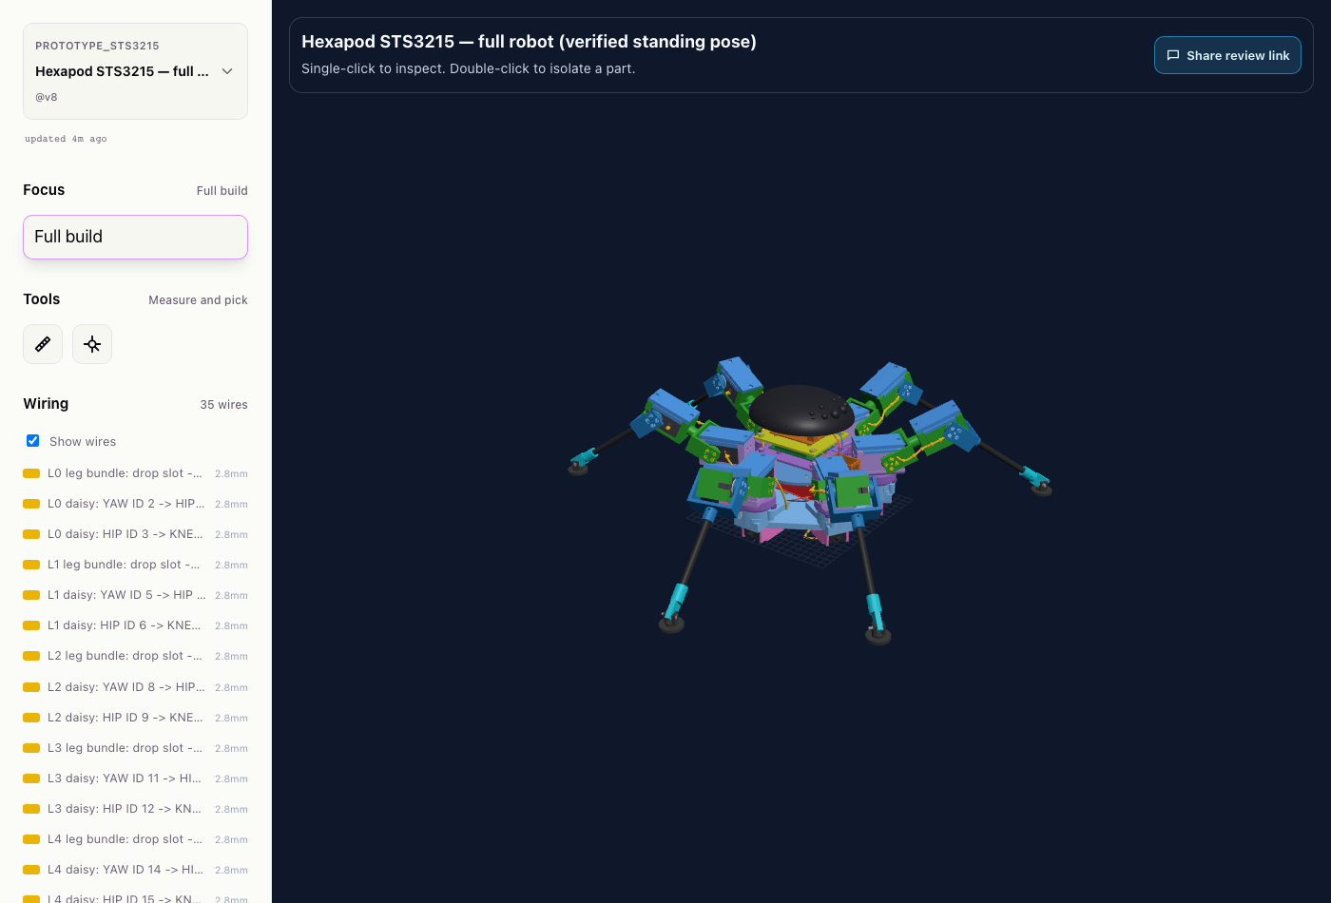
full_robot_viz/screenshots/wires-overview.png
