lukas/hexapod-cad/knee_yoke_apriltag_flag/out/preview.png

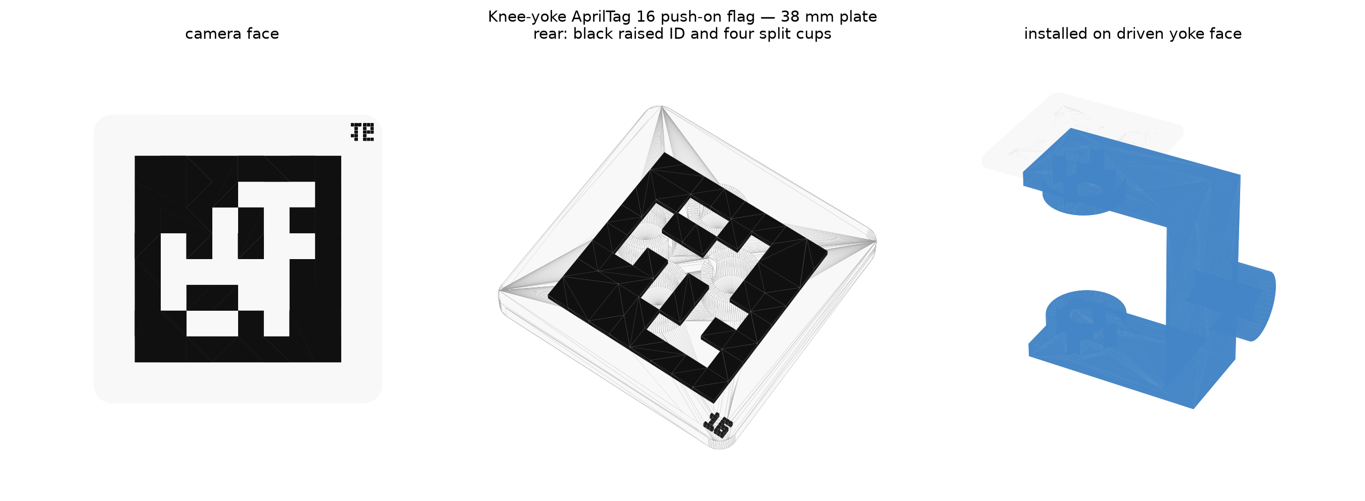
knee_yoke_apriltag_flag/out/preview.png
