lukas/hexapod-cad/knee_yoke_apriltag_flag/out/tag36h11_16-32_knee_yoke_snap_flags_rear_plate_preview.png

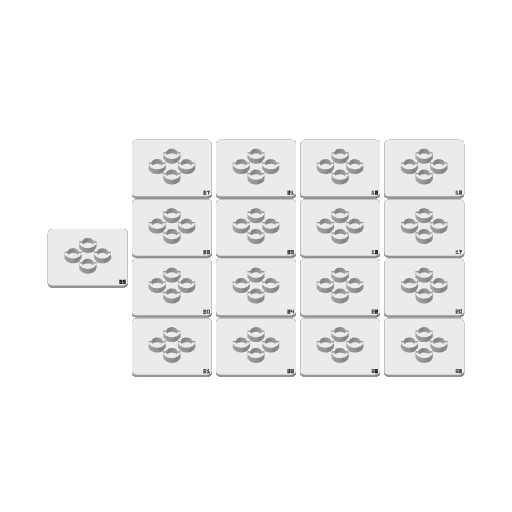
knee_yoke_apriltag_flag/out/tag36h11_16-32_knee_yoke_snap_flags_rear_plate_preview.png
