lukas/hexapod-cad/knee_yoke_apriltag_flag/out/tag36h11_33-64_knee_yoke_snap_flags_preview.png

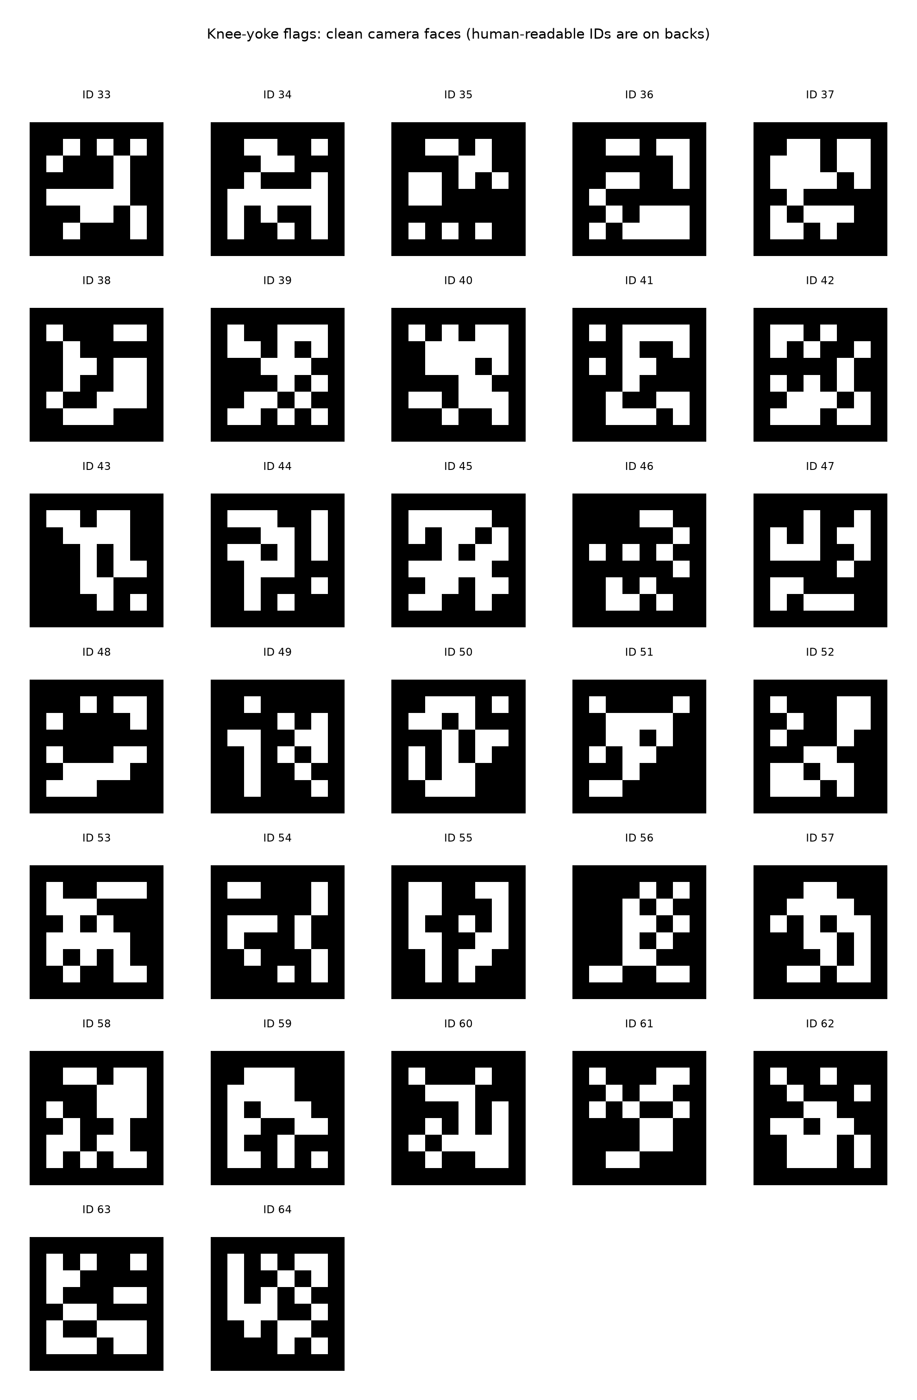
knee_yoke_apriltag_flag/out/tag36h11_33-64_knee_yoke_snap_flags_preview.png
