lukas/hexapod-cad/xtool/hex_mount_plate_110_preview.png

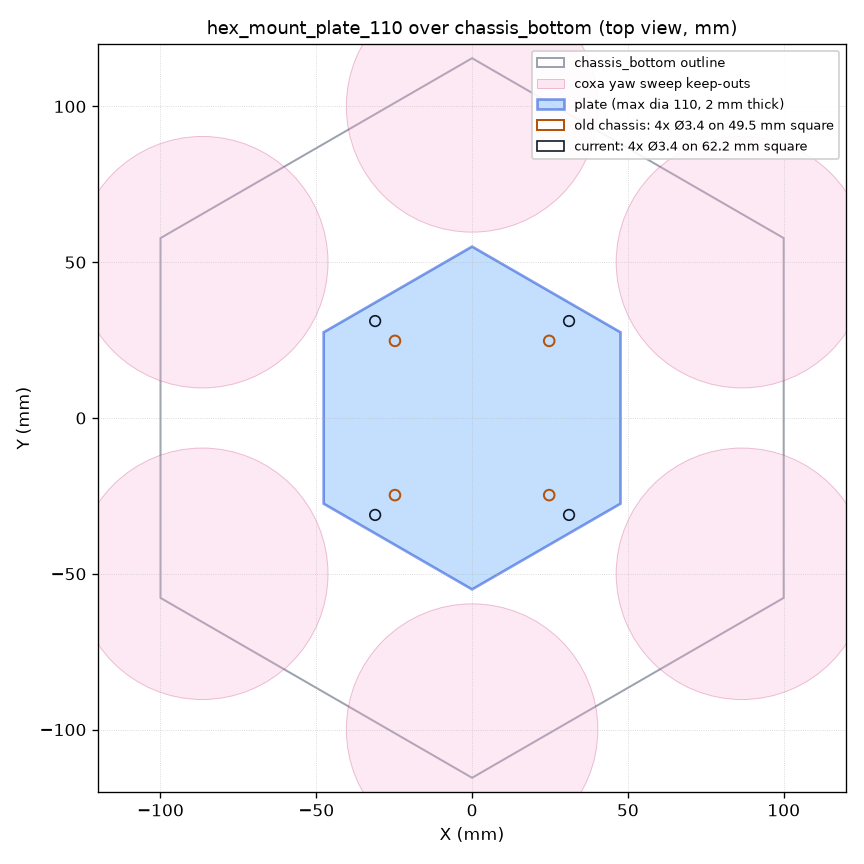
xtool/hex_mount_plate_110_preview.png
