lukas/hexapod-cad/xtool/preview.png

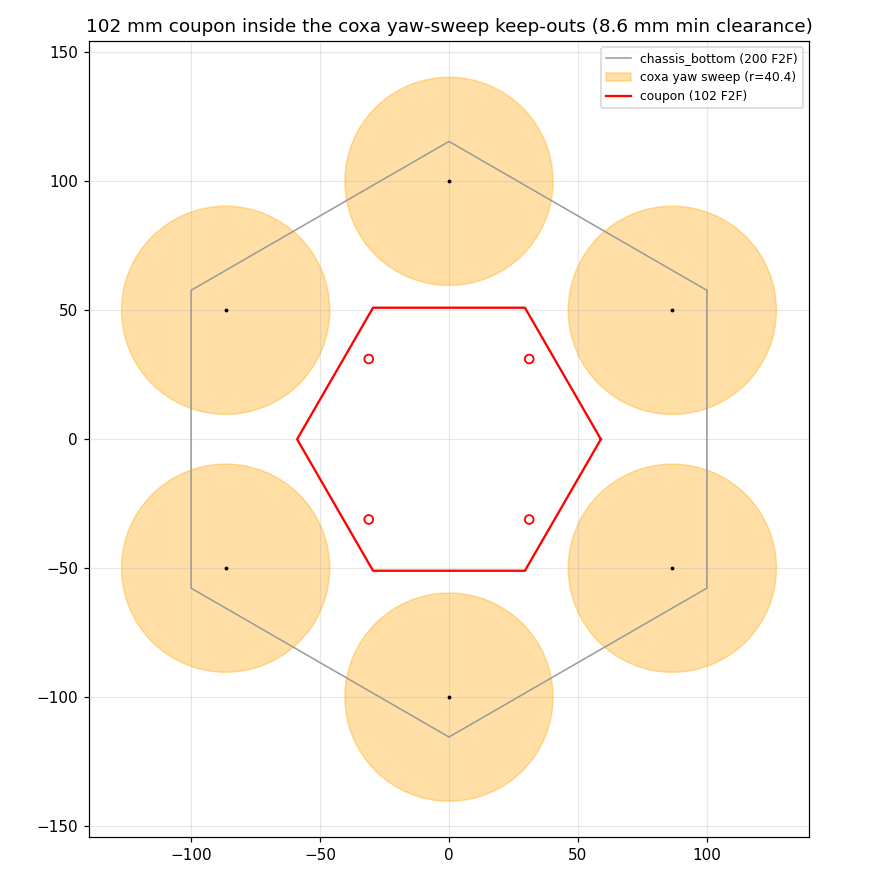
xtool/preview.png
