lukas/hexapod-cad/concepts/sensor_full_foot/sensor_full_foot.3mf

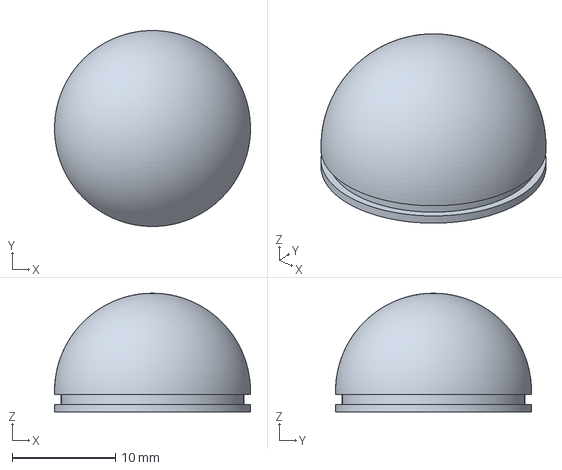
[picture p46: CAD file, 2026-09-22]
concepts/sensor_full_foot/sensor_full_foot.3mf
19.0 x 19.0 x 11.5 mm
