lukas/hexapod-cad/apriltag_lids/out/individual/tag36h11_10_motor_lid.3mf

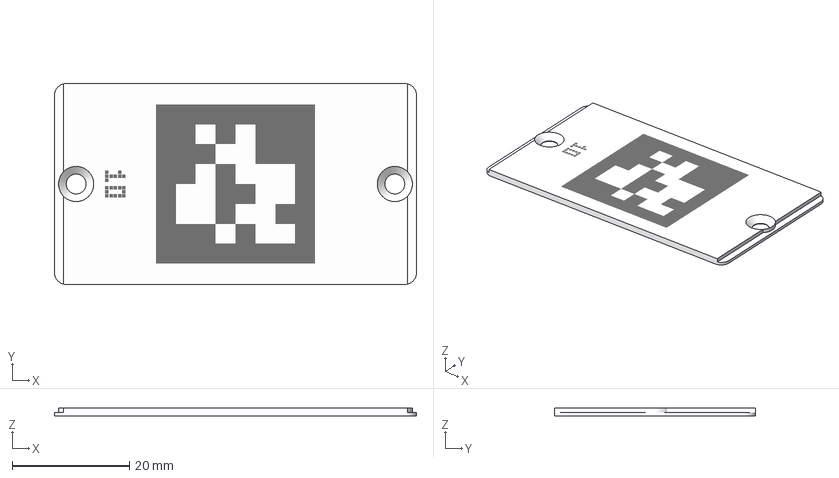
[picture p47: CAD file, 2026-09-15]
apriltag_lids/out/individual/tag36h11_10_motor_lid.3mf
61.8 x 34.3 x 1.40 mm
