lukas/hexapod-cad/apriltag_lids/out/tag36h11_motor_lids_01-16.3mf

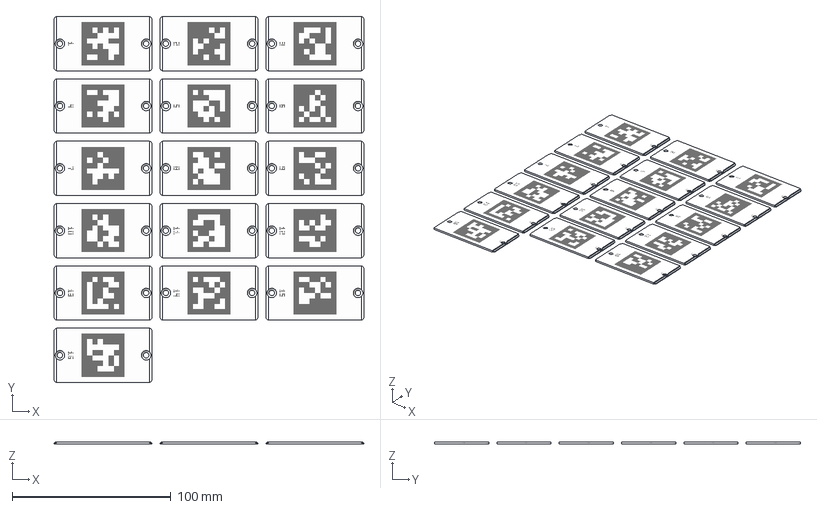
[picture p48: CAD file, 2026-09-15]
apriltag_lids/out/tag36h11_motor_lids_01-16.3mf
195.4 x 230.8 x 1.40 mm
tag36h11_01
tag36h11_02
tag36h11_03
tag36h11_04
tag36h11_05
tag36h11_06
tag36h11_07
tag36h11_08
tag36h11_09
tag36h11_10
tag36h11_11
tag36h11_12
tag36h11_13
tag36h11_14
tag36h11_15
tag36h11_16
