lukas/hexapod-cad/concepts/chassis_reinforcement/stl/aluminum_bottom_spreader_ring.stl

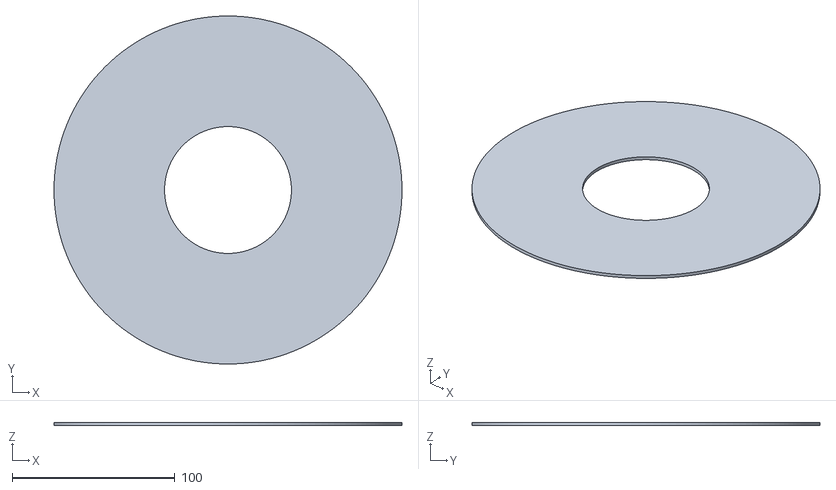
[picture p49: CAD file, 2026-09-15]
concepts/chassis_reinforcement/stl/aluminum_bottom_spreader_ring.stl
214.0 x 214.0 x 2.00
