lukas/hexapod-cad/concepts/premade_chorn_56/stl/tibia_socket_premade_chorn.3mf

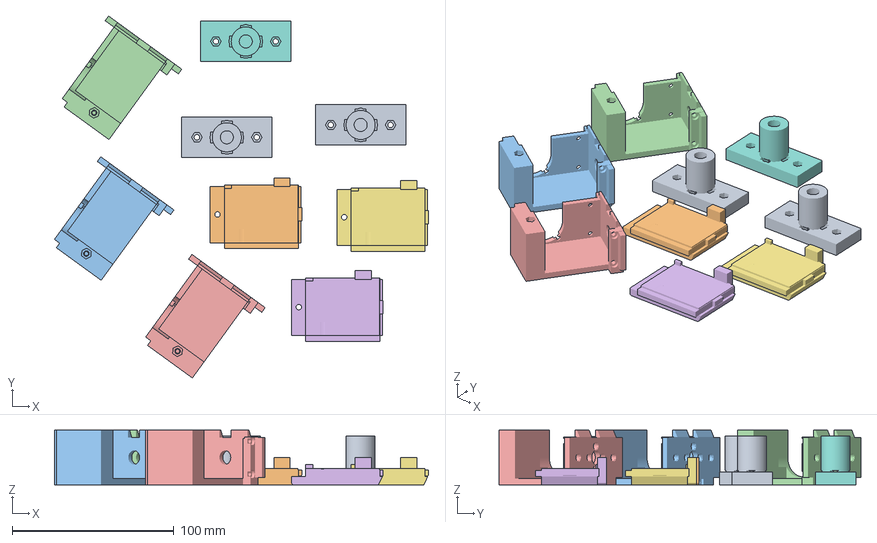
[picture p50: CAD file, 2026-09-15]
concepts/premade_chorn_56/stl/tibia_socket_premade_chorn.3mf
231.5 x 224.0 x 33.8 mm
tibia_socket_premade_chorn.stl x 3
knee_clamp_cap_ovh.stl x 3
femur_body_premade_chorn.stl x 3
