lukas/hexapod-cad/concepts/sensor_full_foot/contact_pad_tpu.3mf

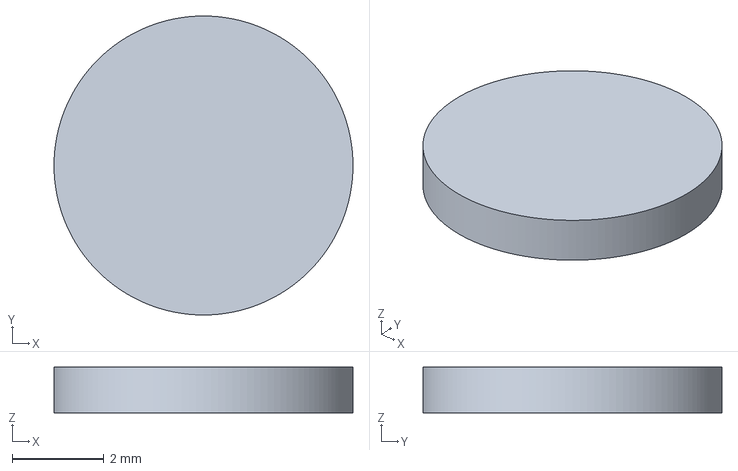
[picture p51: CAD file, 2026-09-22]
concepts/sensor_full_foot/contact_pad_tpu.3mf
6.50 x 6.50 x 1.00 mm
