lukas/hexapod-cad/concepts/sensor_semicircle_foot/sensor_semicircle_foot.3mf

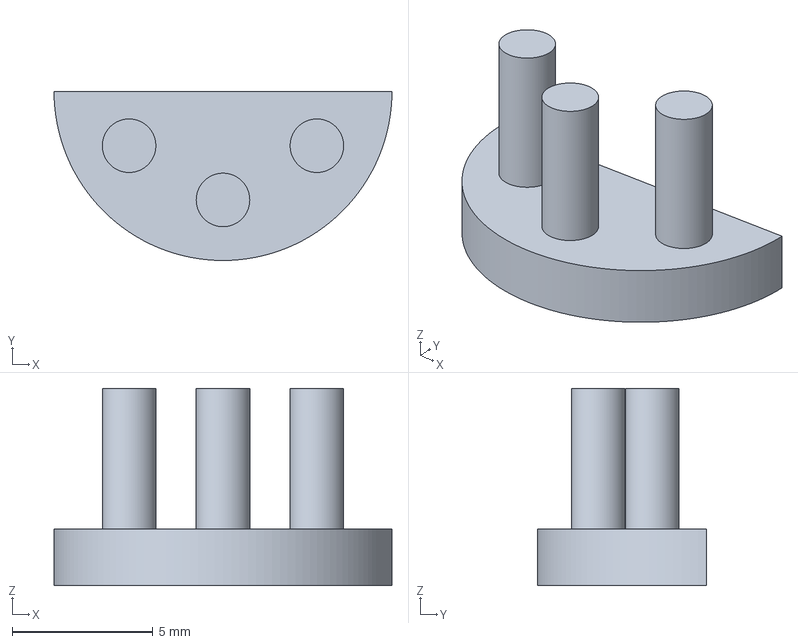
[picture p52: CAD file, 2026-09-22]
concepts/sensor_semicircle_foot/sensor_semicircle_foot.3mf
12.0 x 6.00 x 7.00 mm
