lukas/hexapod-cad/concepts/tibia_yoke_reinforcement/stl/chorn_printed_tibia_socket.stl

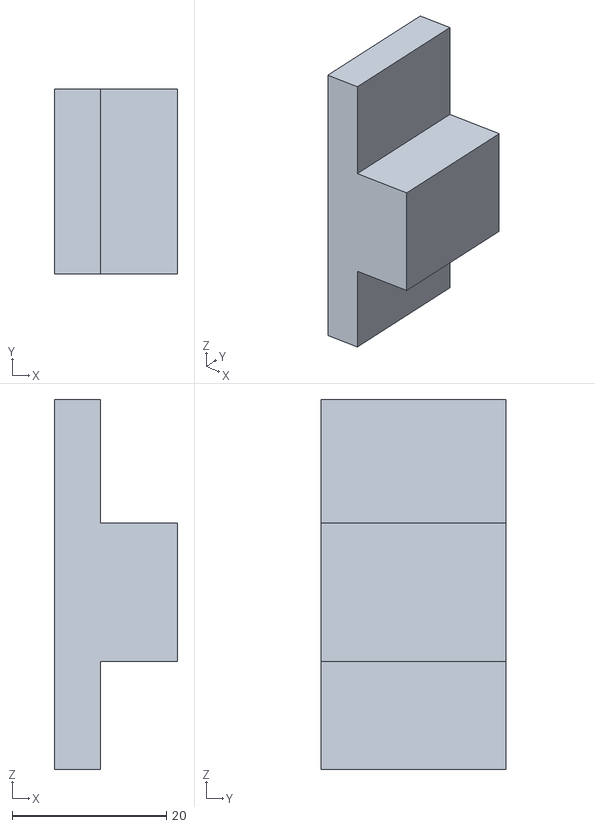
[picture p53: CAD file, 2026-09-15]
concepts/tibia_yoke_reinforcement/stl/chorn_printed_tibia_socket.stl
16.0 x 24.0 x 48.0
