lukas/hexapod-cad/apriltag_lids/out/tag36h11_motor_lids_100-119_BambuStudio.3mf

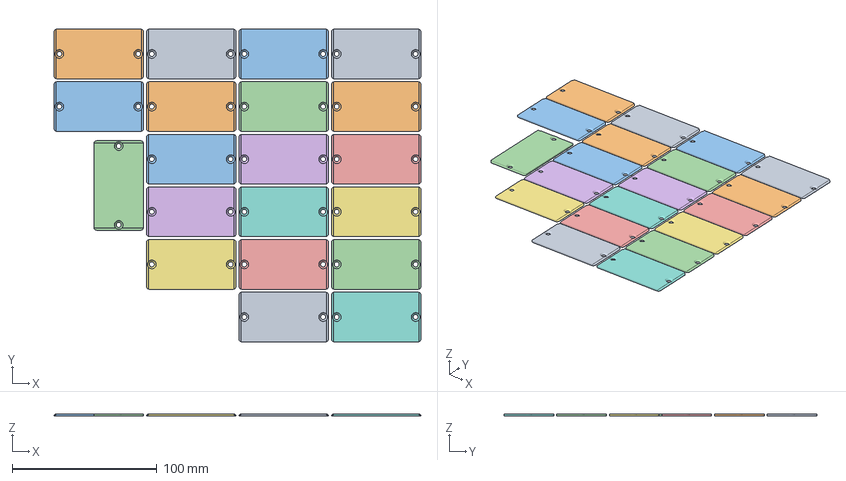
[picture p55: CAD file, 2026-09-15]
apriltag_lids/out/tag36h11_motor_lids_100-119_BambuStudio.3mf
253.2 x 215.8 x 1.40 mm
tag36h11_100
tag36h11_101
tag36h11_102
tag36h11_103
tag36h11_104
tag36h11_105
tag36h11_106
tag36h11_107
tag36h11_108
tag36h11_109
tag36h11_110
tag36h11_111
tag36h11_112
tag36h11_113
tag36h11_114
tag36h11_115
tag36h11_116
tag36h11_117
tag36h11_118
tag36h11_119
