lukas/hexapod-cad/concepts/chassis_reinforcement/stl/aluminum_standoff_sleeve.stl

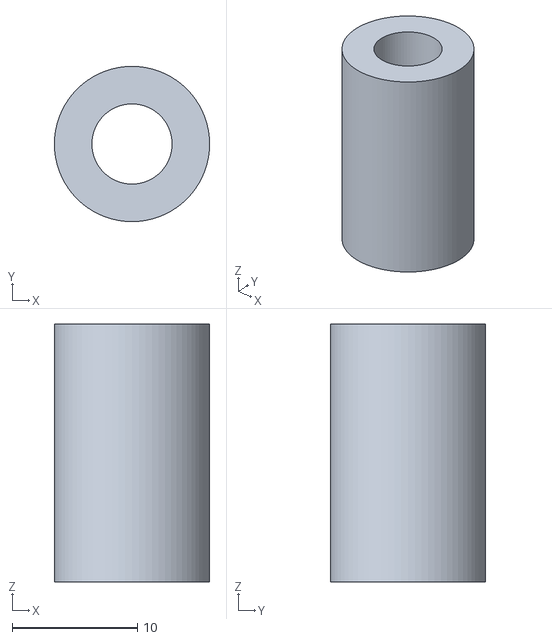
[picture p56: CAD file, 2026-09-15]
concepts/chassis_reinforcement/stl/aluminum_standoff_sleeve.stl
12.4 x 12.4 x 20.6
