lukas/hexapod-cad/concepts/sensor_full_foot/mating_cylinder.3mf

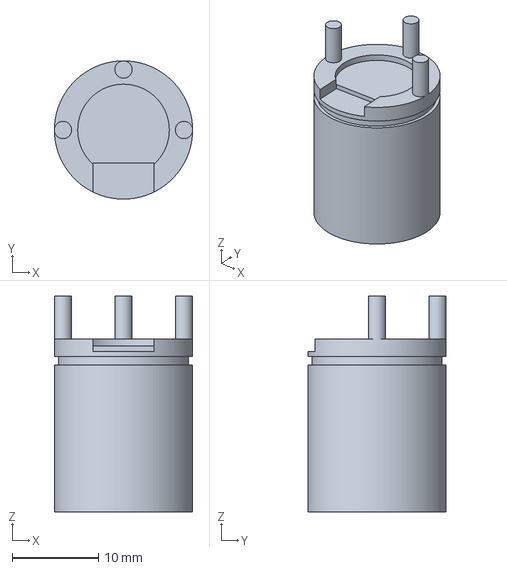
[picture p57: CAD file, 2026-09-22]
concepts/sensor_full_foot/mating_cylinder.3mf
16.0 x 16.0 x 25.0 mm
