lukas/hexapod-cad/concepts/tibia_yoke_reinforcement/stl/foot_boot_chorn.stl

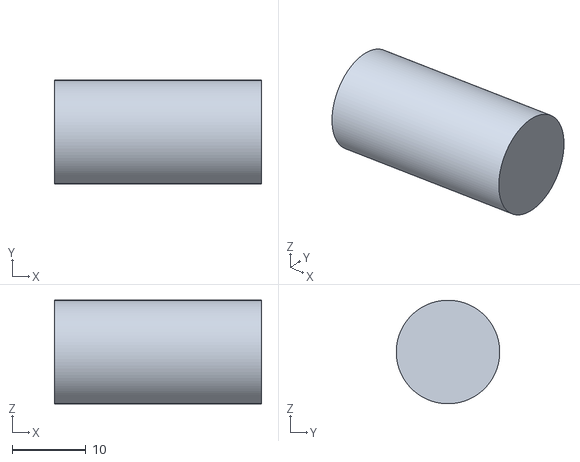
[picture p58: CAD file, 2026-09-15]
concepts/tibia_yoke_reinforcement/stl/foot_boot_chorn.stl
28.0 x 14.0 x 14.0
