lukas/hexapod-cad/apriltag_lids/out/tag36h11_motor_lids_100-119.3mf

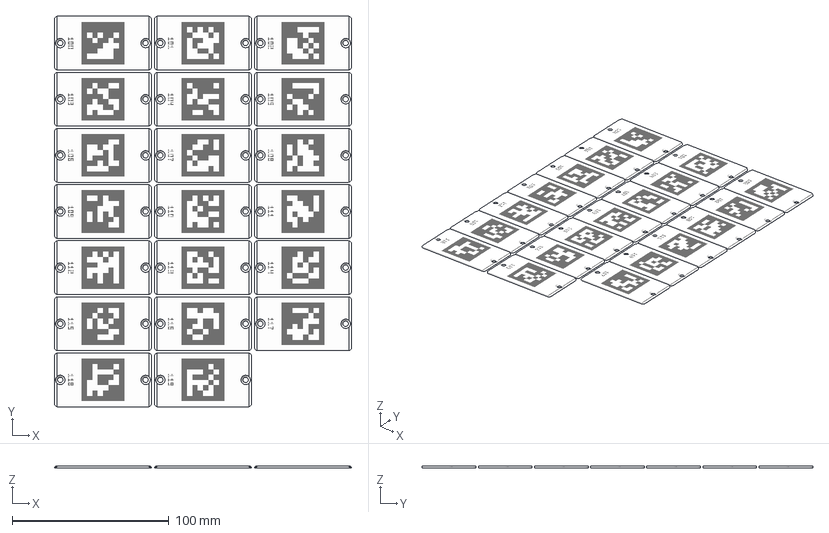
[picture p61: CAD file, 2026-09-15]
apriltag_lids/out/tag36h11_motor_lids_100-119.3mf
189.4 x 249.1 x 1.40 mm
tag36h11_100
tag36h11_101
tag36h11_102
tag36h11_103
tag36h11_104
tag36h11_105
tag36h11_106
tag36h11_107
tag36h11_108
tag36h11_109
tag36h11_110
tag36h11_111
tag36h11_112
tag36h11_113
tag36h11_114
tag36h11_115
tag36h11_116
tag36h11_117
tag36h11_118
tag36h11_119
