lukas/hexapod-cad/concepts/chassis_reinforcement/stl/aluminum_top_doubler_ring.stl

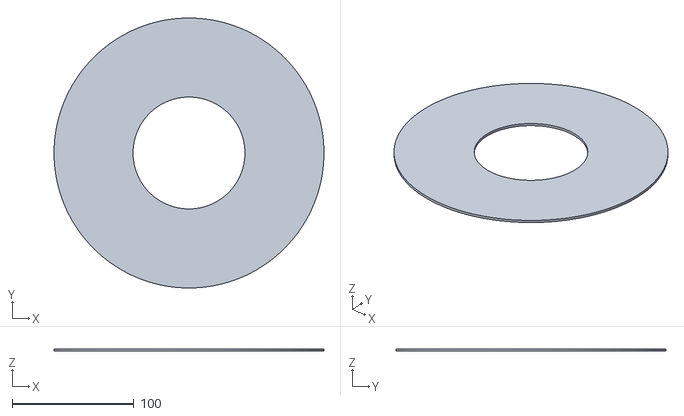
[picture p62: CAD file, 2026-09-15]
concepts/chassis_reinforcement/stl/aluminum_top_doubler_ring.stl
222.0 x 222.0 x 2.00
