lukas/hexapod-cad/concepts/tibia_yoke_reinforcement/stl/load_fixture_chorn.stl

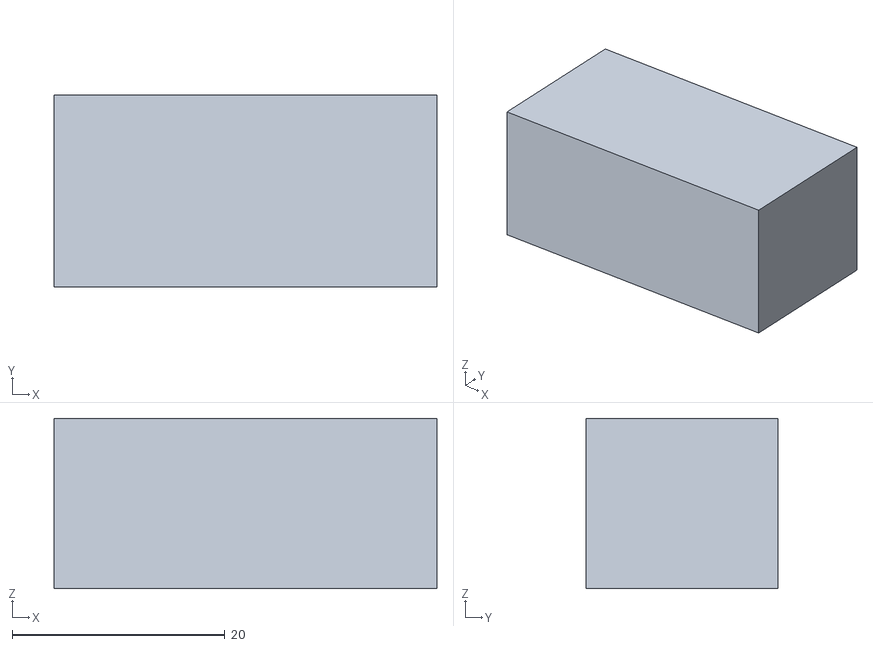
[picture p63: CAD file, 2026-09-15]
concepts/tibia_yoke_reinforcement/stl/load_fixture_chorn.stl
36.0 x 18.0 x 16.0
