lukas/hexapod-cad/knee_yoke_apriltag_flag/out/tag36h11_16_knee_yoke_snap_flag_BambuStudio.3mf

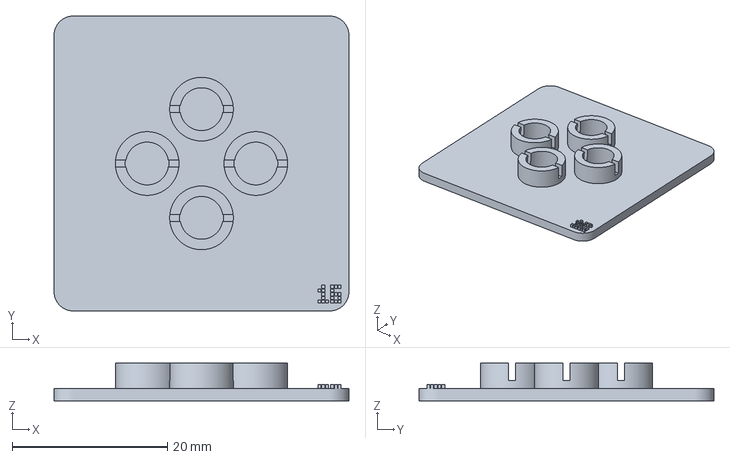
[picture p64: CAD file, 2026-09-15]
knee_yoke_apriltag_flag/out/tag36h11_16_knee_yoke_snap_flag_BambuStudio.3mf
38.0 x 38.0 x 4.85 mm
