lukas/hexapod-cad/concepts/chassis_reinforcement/stl/aluminum_yaw_saddle_pad.stl

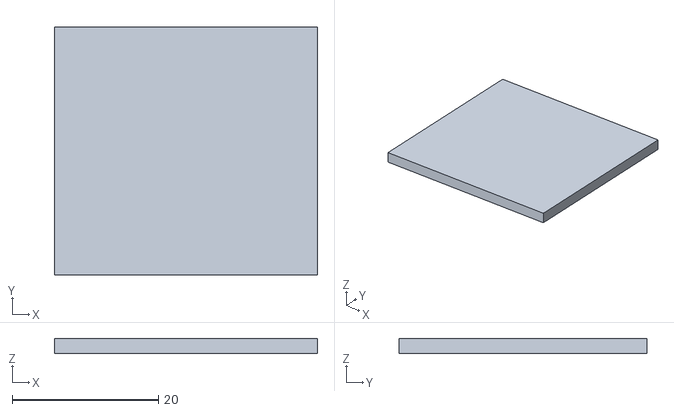
[picture p66: CAD file, 2026-09-15]
concepts/chassis_reinforcement/stl/aluminum_yaw_saddle_pad.stl
36.0 x 34.0 x 2.00
