lukas/hexapod-cad/concepts/sensor_full_foot/return_collar_tpu.3mf

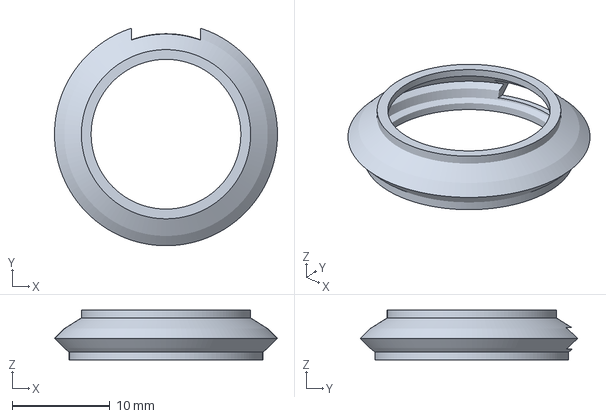
[picture p67: CAD file, 2026-09-22]
concepts/sensor_full_foot/return_collar_tpu.3mf
22.8 x 22.2 x 5.10 mm
