lukas/hexapod-cad/concepts/tibia_yoke_reinforcement/stl/carbon_tube_current.stl

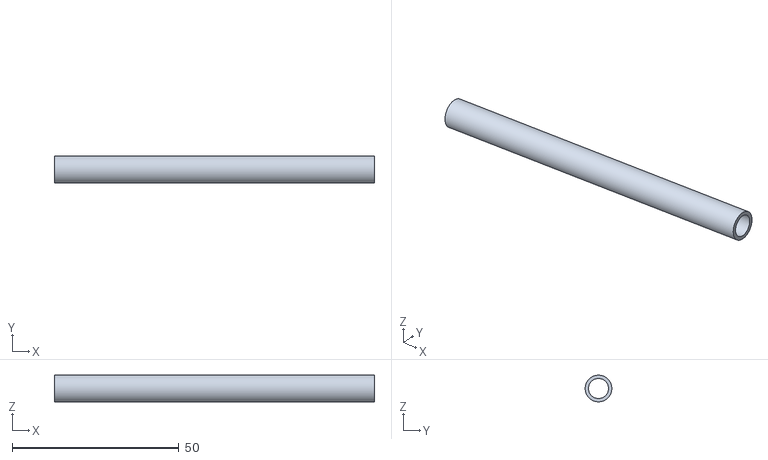
[picture p68: CAD file, 2026-09-15]
concepts/tibia_yoke_reinforcement/stl/carbon_tube_current.stl
96.0 x 8.00 x 8.00
