lukas/hexapod-cad/concepts/chassis_reinforcement/stl/aluminum_radial_rib.stl

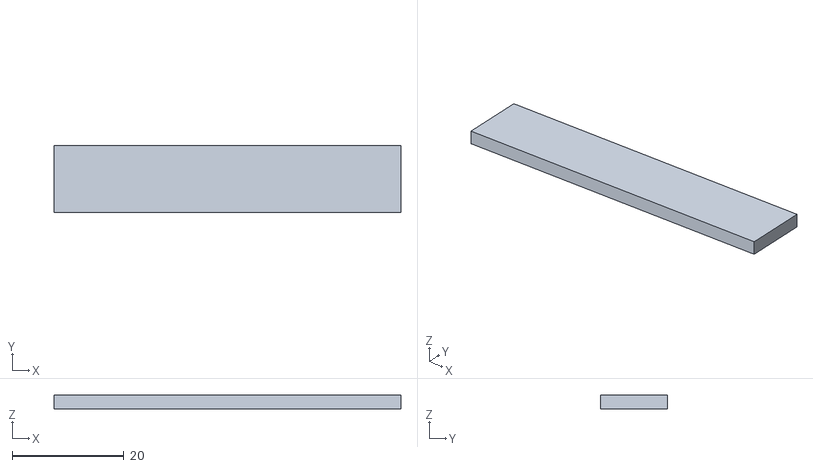
[picture p69: CAD file, 2026-09-15]
concepts/chassis_reinforcement/stl/aluminum_radial_rib.stl
62.0 x 12.0 x 2.50
