lukas/hexapod-cad/concepts/tibia_yoke_reinforcement/stl/inspection_base.stl

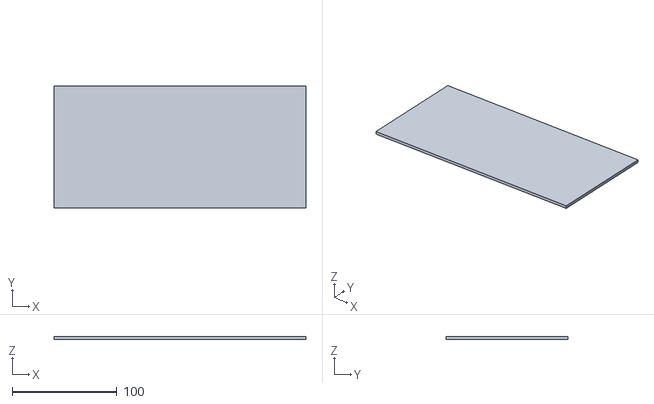
[picture p70: CAD file, 2026-09-15]
concepts/tibia_yoke_reinforcement/stl/inspection_base.stl
240.0 x 116.0 x 3.00
