lukas/hexapod-cad/knee_yoke_apriltag_flag/out/tag36h11_16-32_knee_yoke_snap_flags.3mf

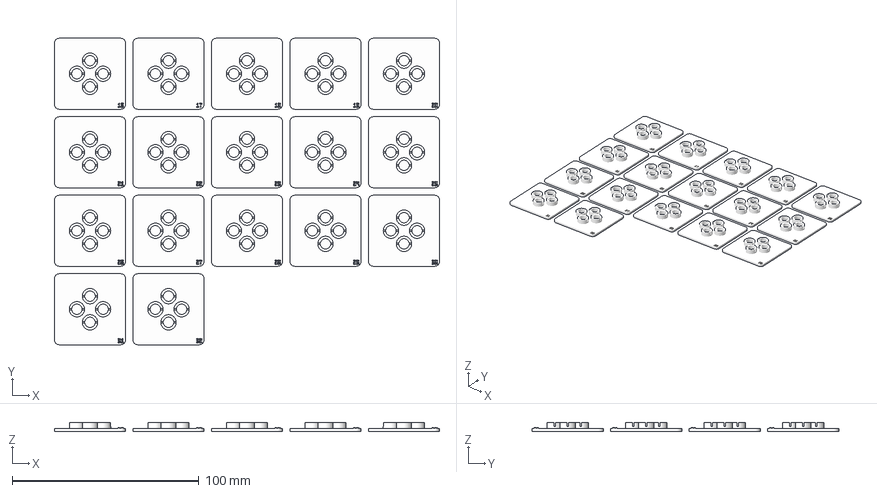
[picture p71: CAD file, 2026-09-15]
knee_yoke_apriltag_flag/out/tag36h11_16-32_knee_yoke_snap_flags.3mf
206.0 x 164.0 x 4.85 mm
tag36h11_16
tag36h11_17
tag36h11_18
tag36h11_19
tag36h11_20
tag36h11_21
tag36h11_22
tag36h11_23
tag36h11_24
tag36h11_25
tag36h11_26
tag36h11_27
tag36h11_28
tag36h11_29
tag36h11_30
tag36h11_31
tag36h11_32
