lukas/hexapod-cad/concepts/chassis_reinforcement/stl/chassis_reference_plate.stl

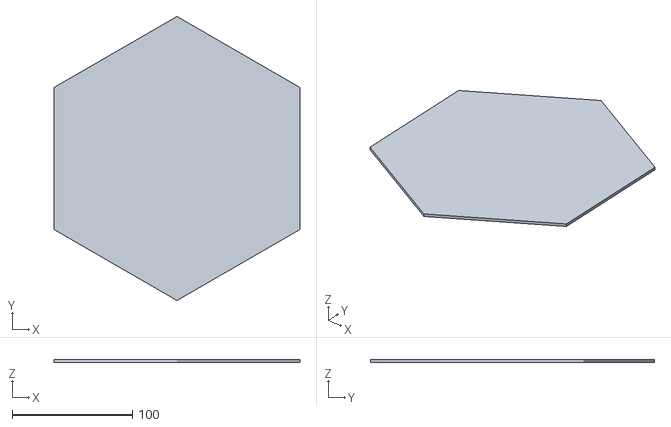
[picture p72: CAD file, 2026-09-15]
concepts/chassis_reinforcement/stl/chassis_reference_plate.stl
204.4 x 236.0 x 2.40
