lukas/hexapod-cad/knee_yoke_apriltag_flag/out/tag36h11_33-64_knee_yoke_snap_flags.3mf

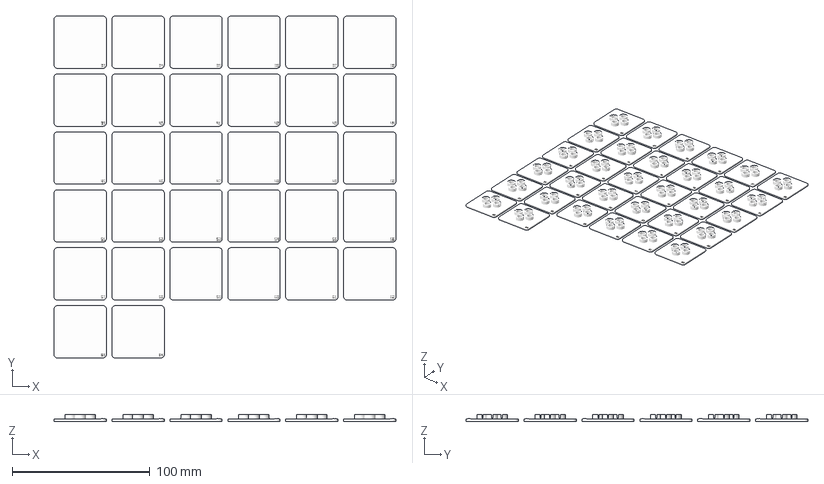
[picture p73: CAD file, 2026-09-15]
knee_yoke_apriltag_flag/out/tag36h11_33-64_knee_yoke_snap_flags.3mf
248.0 x 248.0 x 4.85 mm
tag36h11_33
tag36h11_34
tag36h11_35
tag36h11_36
tag36h11_37
tag36h11_38
tag36h11_39
tag36h11_40
tag36h11_41
tag36h11_42
tag36h11_43
tag36h11_44
tag36h11_45
tag36h11_46
tag36h11_47
tag36h11_48
tag36h11_49
tag36h11_50
tag36h11_51
tag36h11_52
tag36h11_53
tag36h11_54
tag36h11_55
tag36h11_56
tag36h11_57
tag36h11_58
tag36h11_59
tag36h11_60
tag36h11_61
tag36h11_62
tag36h11_63
tag36h11_64
