lukas/hexapod-cad/concepts/tibia_yoke_reinforcement/stl/load_fixture_current.stl

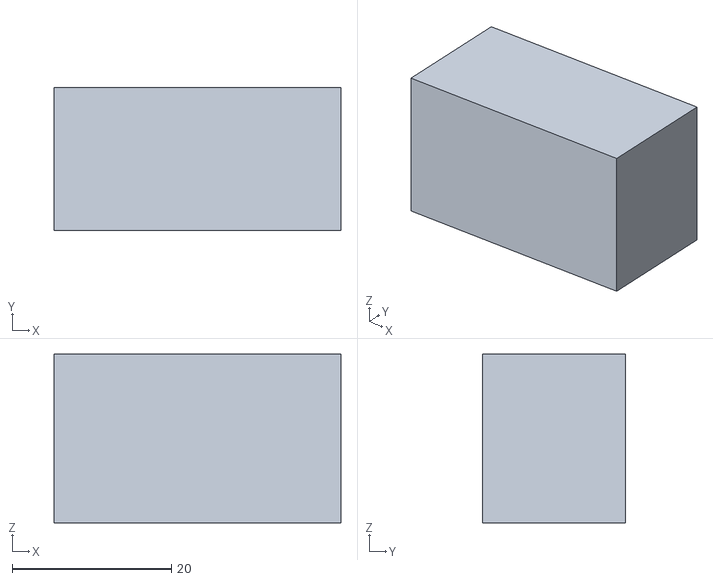
[picture p74: CAD file, 2026-09-15]
concepts/tibia_yoke_reinforcement/stl/load_fixture_current.stl
36.0 x 18.0 x 21.1
