lukas/hexapod-cad/concepts/sensor_full_foot/sensor_reference.stl

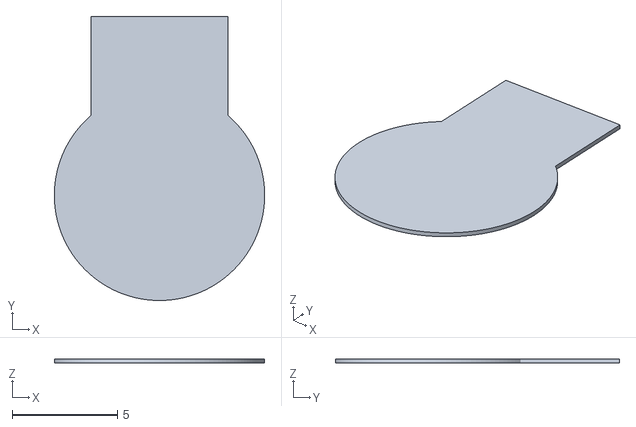
[picture p75: CAD file, 2026-09-22]
concepts/sensor_full_foot/sensor_reference.stl
10.0 x 13.5 x 0.2
