lukas/hexapod-cad/concepts/tibia_yoke_reinforcement/stl/chorn_aluminum_path_reference.stl

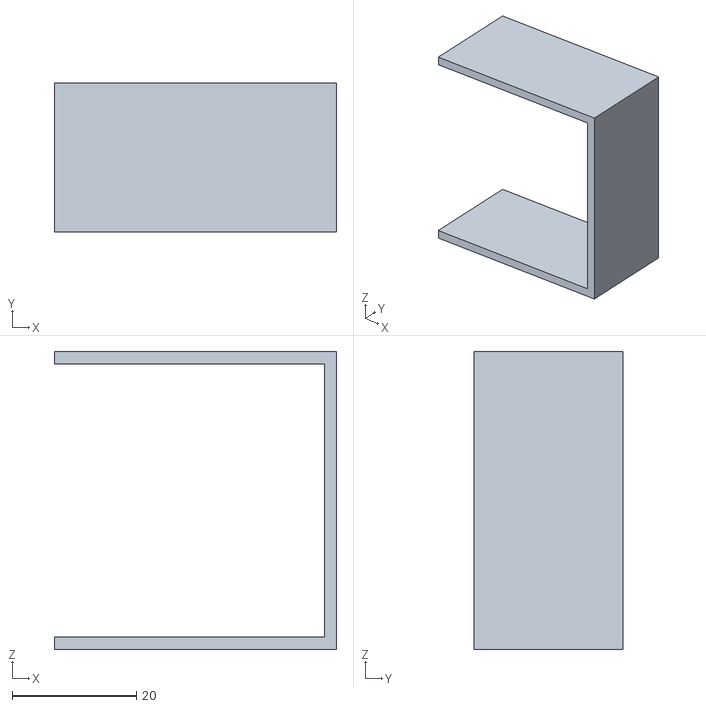
[picture p76: CAD file, 2026-09-15]
concepts/tibia_yoke_reinforcement/stl/chorn_aluminum_path_reference.stl
45.5 x 24.0 x 48.0
