lukas/hexapod-cad/concepts/tibia_yoke_reinforcement/stl/current_spine_crack_marker.stl

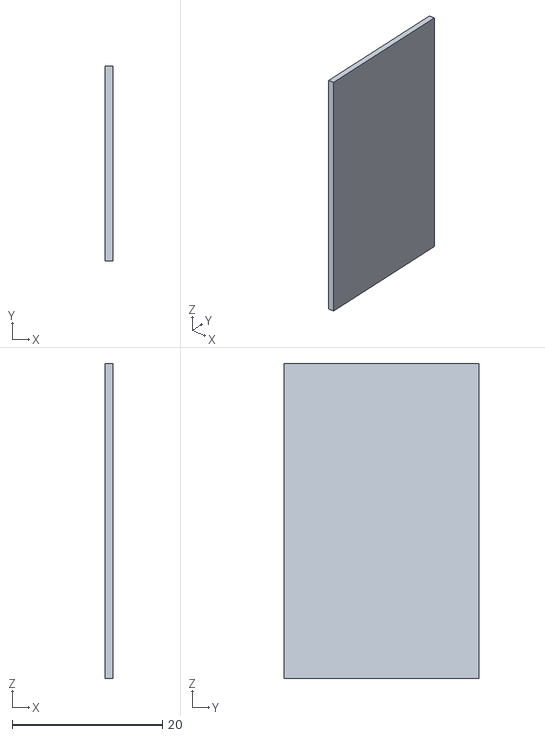
[picture p77: CAD file, 2026-09-15]
concepts/tibia_yoke_reinforcement/stl/current_spine_crack_marker.stl
1.00 x 26.0 x 42.0
