lukas/hexapod-cad/concepts/tibia_yoke_reinforcement/stl/current_printed_tibia_yoke.stl

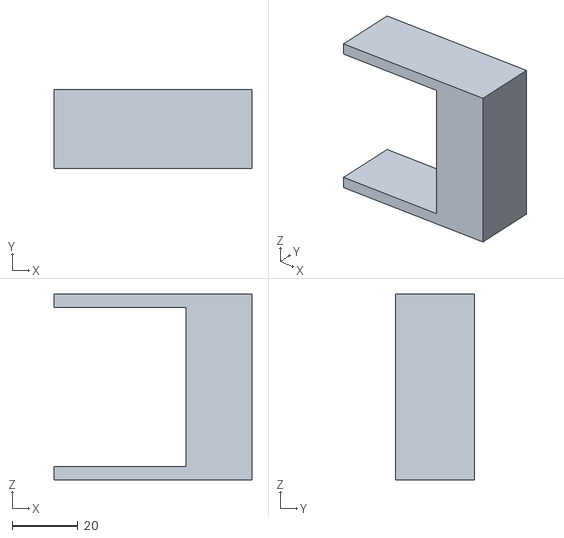
[picture p78: CAD file, 2026-09-15]
concepts/tibia_yoke_reinforcement/stl/current_printed_tibia_yoke.stl
60.0 x 24.0 x 56.3
