lukas/hexapod-cad/(list of files, cad)

Other CAD files:
concepts/sensor_full_foot/sensor_full_foot_print.stl
vehicles/tt_kid_truck/out/plates/plate-2.3mf
apriltag_lids/out/individual/tag36h11_05_motor_lid.3mf
vehicles/tt_kid_truck/out/plates/plate-1.3mf
concepts/sensor_full_foot/mating_cylinder_print.stl
apriltag_lids/out/individual/tag36h11_110_motor_lid.3mf
knee_yoke_apriltag_flag/out/tag36h11_16_knee_yoke_snap_flag.3mf
apriltag_lids/out/individual/tag36h11_113_motor_lid.3mf
apriltag_lids/out/individual/tag36h11_116_motor_lid.3mf
concepts/sensor_full_foot/return_collar_tpu_print.stl
concepts/tibia_yoke_reinforcement/stl/foot_boot_current.stl
apriltag_lids/out/individual/tag36h11_106_motor_lid.3mf
apriltag_lids/out/individual/tag36h11_01_motor_lid.3mf
concepts/sensor_full_foot/contact_pad_tpu_print.stl
concepts/tibia_yoke_reinforcement/stl/carbon_tube_chorn.stl
apriltag_lids/out/individual/tag36h11_112_motor_lid.3mf
apriltag_lids/out/individual/tag36h11_103_motor_lid.3mf
apriltag_lids/out/individual/tag36h11_11_motor_lid.3mf
apriltag_lids/out/individual/tag36h11_118_motor_lid.3mf
apriltag_lids/out/individual/tag36h11_14_motor_lid.3mf
apriltag_lids/out/individual/tag36h11_04_motor_lid.3mf
apriltag_lids/out/individual/tag36h11_07_motor_lid.3mf
apriltag_lids/out/individual/tag36h11_102_motor_lid.3mf
apriltag_lids/out/individual/tag36h11_13_motor_lid.3mf
apriltag_lids/out/individual/tag36h11_03_motor_lid.3mf
apriltag_lids/out/individual/tag36h11_108_motor_lid.3mf
apriltag_lids/out/individual/tag36h11_115_motor_lid.3mf
apriltag_lids/out/individual/tag36h11_111_motor_lid.3mf
apriltag_lids/out/individual/tag36h11_114_motor_lid.3mf
apriltag_lids/out/individual/tag36h11_12_motor_lid.3mf
apriltag_lids/out/individual/tag36h11_119_motor_lid.3mf
apriltag_lids/out/individual/tag36h11_104_motor_lid.3mf
apriltag_lids/out/individual/tag36h11_107_motor_lid.3mf
apriltag_lids/out/individual/tag36h11_15_motor_lid.3mf
apriltag_lids/out/individual/tag36h11_109_motor_lid.3mf
apriltag_lids/out/individual/tag36h11_09_motor_lid.3mf
apriltag_lids/out/individual/tag36h11_100_motor_lid.3mf
apriltag_lids/out/individual/tag36h11_08_motor_lid.3mf
apriltag_lids/out/individual/tag36h11_02_motor_lid.3mf
apriltag_lids/out/individual/tag36h11_16_motor_lid.3mf
apriltag_lids/out/individual/tag36h11_06_motor_lid.3mf
apriltag_lids/out/individual/tag36h11_101_motor_lid.3mf
apriltag_lids/out/individual/tag36h11_117_motor_lid.3mf
fasteners/scad/m3x10_shcs.scad
fasteners/scad/m3x8_shcs.scad
concepts/sensor_full_foot/contact_pad_tpu.stl
concepts/sensor_full_foot/mating_cylinder.stl
concepts/sensor_full_foot/return_collar_tpu.stl
concepts/sensor_full_foot/sensor_full_foot.stl
concepts/sensor_semicircle_foot/sensor_semicircle_foot.stl
