lukas/hexapod-cad/full_robot_viz/wiring_view.png

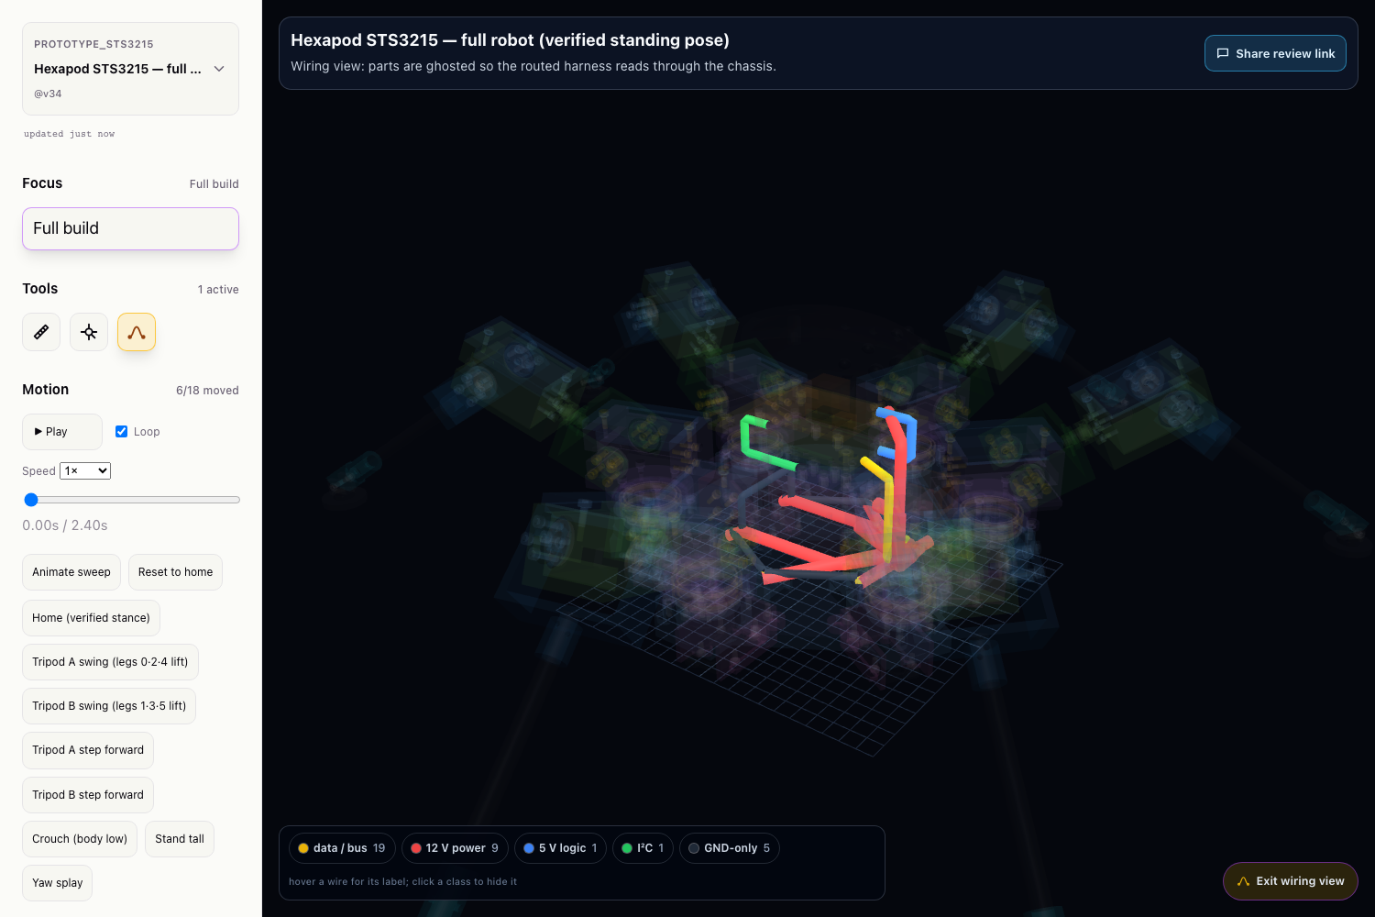
full_robot_viz/wiring_view.png
