lukas/hexapod-cad/_verify_prototype.py

"""Run all post-redesign correctness checks on the prototype.

1.  Every part is a clean watertight mesh (manifold, no self-intersections
    that would crash the slicer).
2.  Every servo well has an open insertion path big enough for the body.
3.  Every M3 mounting / chassis-bolt hole drilled by the design code
    actually passes through solid material it's supposed to anchor in.
3b. The L-shaped wire-exit corridor at every cradle's -X bottom-OUTBOARD
    corner lets a WIRE_SLOT_W-wide harness reach free space without
    intersecting solid part material.
4.  In standing pose, no two printed parts overlap in volume by more than
    100 mm^3.
5.  In standing pose, the three servo bodies (yaw / hip-pitch / knee-pitch)
    sit in their cradles without poking into solid printed material.
6.  No printed part has a STRUCTURALLY-SIGNIFICANT region thinner than
    MIN_PRINT_T mm (Hildebrand max-inscribed-ball local thickness on a
    voxelised occupancy field).
6b. None of the structural LEG LINK parts has a thin SHEET / WEB --
    a region of material extended in 2D but thinner than MIN_SHEET_T
    in the third direction.  Catches "thick block - THIN SHEET -
    thick block" topology that 6. misses because an inscribed ball
    fits happily inside a thin slab.

Exit code 0 = all checks pass.  Exit code 1 = at least one failure.

Robust inside-test
------------------

We do NOT use ``trimesh.proximity.signed_distance`` or
``Trimesh.contains`` directly: both give false positives on the
boolean-union'd meshes used by `make_coxa_*`/`make_femur_*` (the
internal cavities created by the body-pocket cuts confuse the
ray-casting heuristic).  Instead we shoot 6 axis-aligned rays from
each test point and call the point INSIDE iff a majority of rays
report an odd number of intersections with the mesh.  This majority
vote is much more robust on borderline / non-manifold input.

Speed: mesh cache + process-pool dispatch
-----------------------------------------

Every printable part is built ONCE via ``_load_mesh(name)`` and
re-used (copied where mutated) across every check that needs it.
The check suite then runs in a ``concurrent.futures.ProcessPoolExecutor``
pool: parent process builds the master cache, pickles it via the
pool ``initializer=`` so each worker boots with every mesh
already preloaded, then submits the independent ``check_*`` checks
plus the per-pose chunks of ``check_workspace_self_collision``.
Results stream back as ``(name, ok, captured_stdout)`` tuples and
the parent prints them in DECLARATION ORDER -- the on-screen output
stays byte-for-byte identical to a serial run.

CLI flags
---------

* ``--serial`` -- skip the process pool and run every check in the main
  process in declaration order.  Use this when a worker traceback is
  mangled through pickle and you need a clean stack.
* ``--workers N`` -- override the default worker count (default is
  ``min(8, os.cpu_count())``).
* ``--profile PATH`` -- dump a cProfile snapshot of the PARENT process
  to ``PATH`` so you don't need the ``python -m cProfile`` wrapper.
  Workers are NOT profiled; combine with ``--serial`` if you want a
  full-suite profile.
* ``--only CHECK_NAME`` (repeatable) -- run only the named check(s);
  any check whose declaration-list name matches at least one ``--only``
  value is included.  Useful for iterating on a single check.
* ``--with-arm`` -- also run the OPTIONAL arm verification.
"""

from __future__ import annotations
import argparse
import sys
import os
import io
import functools
import hashlib
import inspect
import sqlite3
import time
import multiprocessing
import concurrent.futures
import cProfile
import threading
from contextlib import redirect_stdout

_PROTO_DIR = os.path.dirname(os.path.abspath(__file__))
sys.path.insert(0, os.path.join(_PROTO_DIR, "scripts"))

import numpy as np
import trimesh
from trimesh.transformations import rotation_matrix
from scipy.ndimage import distance_transform_edt, label
import shapely.geometry as _sg

import hexapod_prototype as hp


# ---------------------------------------------------------------------------
# Module-level mesh cache
# ---------------------------------------------------------------------------
#
# Every check used to call ``hp.make_<part>()`` directly, which triggers a
# fresh boolean-union / mesh-difference rebuild costing 0.2-2 s per part
# per call.  With 13+ checks and the workspace sweep, the same parts were
# being rebuilt 5-10 times each.  Routing every build through
# ``_load_mesh(name)`` makes each part hit the constructive-solid path
# EXACTLY ONCE per process; subsequent callers get the cached master
# (and an optional ``.copy()`` if they're going to ``apply_*`` mutate it).
#
# When ``main()`` dispatches checks to a ``ProcessPoolExecutor``, the
# parent process pre-fills the cache and pickles it via the worker
# initializer so each spawn-mode worker boots with every mesh already
# loaded -- no make-from-scratch cost in the worker.

_MESH_BUILDERS = {
    "chassis_top":      hp.make_chassis_top,
    "chassis_bottom":   hp.make_chassis_bottom,
    # Jun 2026 single-part merge: the HIGH/LOW print split is gone, so
    # ``chassis_bottom`` IS the whole printed plate (flat plate + bearing tower
    # + the folded-in flat floor slab carrying the yaw cradles + retainer
    # pilots).  ``chassis_assembled`` -- the key every cradle-feature /
    # world-geometry probe loads -- is therefore now the REAL merged
    # ``make_chassis_bottom`` (no longer the old bucketed ghost solid), so the
    # servo-insertion / wire-exit / disc-horn / bearing checks test the part
    # that actually prints.
    "chassis_assembled":    hp.make_chassis_bottom,
    "yaw_bearing_cap":  hp.make_yaw_bearing_cap,
    "servo_clamp_cap":  hp.make_servo_clamp_cap,
    "switch_holster":   hp.make_switch_holster,
    "coxa_link":        hp.make_coxa_link,
    "femur_link":       hp.make_femur_link,
    "tibia_link":       hp.make_tibia_link,
    # Aug 2026: TPU foot boot pressed over the tibia tube end (replaces
    # the hinged tibia_foot_fitting + foot_pad + M3x16/nyloc pin).
    "foot_boot":        hp.make_foot_boot,
    "servo_body":       hp.make_servo_body,
    # June 2026: the servo joints drive a 20 mm aluminum 25T DISC horn
    # (Amazon B07D56FVK5), so the "servo_horn" mating part IS the disc.
    # The engagement / mating-face / horn-sweep checks all read this
    # mesh, so pointing it at make_disc_horn keeps the verifier in sync
    # with the real hardware.  ``make_servo_horn`` (the plastic X-horn)
    # is retained for backwards compat but no longer used by the robot.
    "servo_horn":       hp.make_disc_horn,
}

ALL_CACHED_PART_NAMES = tuple(_MESH_BUILDERS.keys())

_MESH_CACHE: dict = {}
_MESH_CACHE_LOCK = threading.Lock()


def _load_mesh(name: str, *, copy: bool = True) -> trimesh.Trimesh:
    """Return the cached master mesh for ``name``.

    Default returns a ``mesh.copy()`` so callers that go on to
    ``apply_transform`` / ``apply_translation`` / ``apply_scale`` see
    the same semantics they used to get from a fresh ``hp.make_X()``
    call.  Pass ``copy=False`` only when the caller will NOT mutate
    the returned mesh (e.g. ``check_watertight`` reads ``mesh.volume``
    and ``mesh.is_watertight``; ``_flimsy_clusters_for_part`` calls
    ``mesh.voxelized(...)`` which is itself non-mutating).
    """
    cached = _MESH_CACHE.get(name)
    if cached is None:
        with _MESH_CACHE_LOCK:
            cached = _MESH_CACHE.get(name)
            if cached is None:
                cached = _MESH_BUILDERS[name]()
                _MESH_CACHE[name] = cached
    return cached.copy() if copy else cached


def _chassis_yaw_cradle_to_well_local(mesh: trimesh.Trimesh,
                                      leg_index: int = 0,
                                      ) -> trimesh.Trimesh:
    """Map a ``chassis_bottom`` mesh into the WELL-LOCAL frame of a
    single leg's yaw cradle.

    Used by the cradle-feature verifier checks (cradle openness,
    bolt-hole engagement, cradle insert pockets, horn-sweep
    clearance, servo insertion path) so the chassis_bottom-
    integrated yaw cradle can be probed in the SAME well-local
    frame as the bracket cradle used to be (May 2026 chassis-
    bottom-integrated yaw-cradle redesign, commit 6/8).

    Math: the transform is the inverse of ``fastener_registry.
    _yaw_cradle_T``:

        T_well_to_chassis = T(edge_mid)
                            @ Rz(a)
                            @ T(-SERVO_OUTPUT_X, 0,
                                well_to_chassis_dz)

    where ``well_to_chassis_dz = (CHASSIS_PLATE_T/2 +
    CRADLE_TAB_SHELF_Z) - WELL_RIM_Z = -19.25 mm``.  So the inverse
    is

        T_chassis_to_well = T(+SERVO_OUTPUT_X, 0, -well_to_chassis_dz)
                            @ Rz(-a)
                            @ T(-edge_mid)

    Well-local frame convention (matches ``_bracket_to_well_local``
    helpers in the cradle checks): origin at the body's BOTTOM face
    along the yaw axis; +Z up.  After this transform the leg's
    cradle features land at:

      * cradle tab shelf at well-local z = +WELL_RIM_Z          = +27.25
      * cradle boss top  at well-local z = +WELL_RIM_Z +
                            (CRADLE_BOSS_H - CRADLE_TAB_SHELF_Z) = +32.25
      * chassis_bottom plate top    at well-local z =
          +WELL_RIM_Z - CRADLE_TAB_SHELF_Z                       = +21.25
      * chassis_bottom plate bottom at well-local z =
          +WELL_RIM_Z - CRADLE_TAB_SHELF_Z - CHASSIS_PLATE_T     = +17.25
      * servo body bottom (when seated) at well-local z          = 0
      * servo body top                  at well-local z          = +38

    The other 5 cradles + the rest of the chassis_bottom plate
    material end up scattered far from the well-local origin (the
    plate is ~200 mm flat-to-flat; only the L0 cradle lands at the
    yaw axis).  Cradle-feature probes are localised to the L0
    cradle's well-local region and so are unaffected by the rest
    of the plate.
    """
    apothem = hp.CHASSIS_FLAT_TO_FLAT / 2.0
    a = (leg_index + 0.5) * np.pi / 3.0
    edge_mid = np.array([apothem * np.cos(a), apothem * np.sin(a), 0.0])
    # STS3215 front-face mount (Jun 2026): mirror fastener_registry.
    # _yaw_cradle_T's CAD-exact well-to-chassis shift, which lands the
    # disc-horn TOP at CHASSIS_YAW_OUTPUT_Z and makes the well-local
    # frame coincide with the cradle geometry (was the DS3225 tab-shelf
    # shift ``(CHASSIS_PLATE_T/2 + CRADLE_TAB_SHELF_Z) - WELL_RIM_Z =
    # -19.25``).
    well_to_chassis_dz = (
        hp.CHASSIS_YAW_OUTPUT_Z
        - (hp.SERVO_BODY_H + hp.WELL_PLATE_T + hp.HORN_STACK_H)
    )  # = -13.55 mm

    T1 = np.eye(4)
    T1[:3, 3] = -edge_mid
    Rz_inv = rotation_matrix(-a, [0, 0, 1])
    T3 = np.eye(4)
    T3[0, 3] = +hp.SERVO_OUTPUT_X
    T3[2, 3] = -well_to_chassis_dz
    T_chassis_to_well = T3 @ Rz_inv @ T1

    m = mesh.copy()
    m.apply_transform(T_chassis_to_well)
    return m


def prebuild_mesh_cache(names=ALL_CACHED_PART_NAMES) -> dict:
    """Build every cacheable mesh now and return the cache dict.

    Used by the parent process before dispatching to a process pool so
    the worker initializer can ship the full cache to every worker.
    """
    for name in names:
        _load_mesh(name, copy=False)
    return _MESH_CACHE


# ---------------------------------------------------------------------------
# Flimsy-joint check constants
# ---------------------------------------------------------------------------

# Minimum acceptable LOCAL THICKNESS for printed material.  Three perimeters
# at a 0.4 mm nozzle plus margin -- below this an FDM print becomes either
# entirely sparse infill (the slicer skips perimeters because the wall is
# too thin to fit even one bead) or a stack of < 3 perimeters that snaps
# under any real load.  Tweak this if your slicer / nozzle differs.
MIN_PRINT_T = 3.0           # mm
# Ignore clusters smaller than this -- single voxels and 1-voxel-wide
# surface "fuzz" are voxelisation artefacts of the grid pitch, not real
# weak spots.  At a 1.2 mm pitch a 20-voxel cluster is ~35 mm^3 of
# material thinner than MIN_PRINT_T, which is the smallest defect worth
# investigating.
MIN_CLUSTER_VOX = 20        # voxels
# Budget for the LARGEST flimsy cluster in any single part.  Anything
# bigger means a structurally meaningful thin region the user should
# reinforce before printing.
#
# Why not 200?  Long printed beams with sharp 90 deg edges (the femur
# spar, the tibia spar) produce an unavoidable voxelisation ARTEFACT
# along each long edge.  At MIN_PRINT_T = 3.0 mm and pitch = 1.2 mm,
# half_t_vox = 1.25 voxels, while a corner voxel's distance to its
# nearest core voxel is sqrt(2) ~= 1.414 voxels -- just over the
# threshold, regardless of how thick the underlying wall actually
# is.  A 130 mm-long spar with 4 long edges therefore stamps out
# ~ 130 / 1.2 = 108 corner voxels per edge, which scipy.label
# typically merges into one or two ridges of ~ 200-250 voxels each.
# We have visually verified these ridges (bbox shape: ~120 mm long,
# 4.8 mm wide, < 10 mm tall, 5-10 % voxel fill -- i.e. a 1-voxel-
# thick filament along the spar edge) on the tibia and femur spars;
# they map to real 90-deg edges in the part where the FDM print
# actually deposits >= 3 perimeters of material.  A real thin
# feature (1-2 mm wall over a > 10 x 10 mm area) produces > 1000
# voxels of flimsy and easily clears 250.  We pick 250 -- 25 %
# above the no-artefact baseline of 200 -- as the smallest value
# that admits the predicted corner-edge ridge without masking any
# structurally-meaningful thin region.
MAX_FLIMSY_BUDGET_VOX = 250 # voxels
# Voxel pitch for the local-thickness analysis.  1.2 mm gives roughly
# 80x80x40 = 250k voxels for a typical leg link, which voxelizes and
# distance-transforms in well under a second.
FLIMSY_VOXEL_PITCH = 1.2    # mm


# ---------------------------------------------------------------------------
# Thin-sheet ("structural neck") check constants
# ---------------------------------------------------------------------------
#
# Why a separate check?  ``check_flimsy_joints`` above uses the
# Hildebrand max-inscribed-ball local thickness, which only catches
# features that are thin in ALL THREE directions (spikes, pillars,
# hair-thin necks).  An inscribed sphere of radius MIN_PRINT_T/2 fits
# happily inside any 3 mm-thick slab, so a thin SHEET / WEB (thin in
# one direction, extended in the other two) sails through Hildebrand
# no matter how unprintably thin its load-bearing slab actually is.
#
# This check (a anisotropic chord variant of Hildebrand) computes the
# per-voxel MIN DIRECTIONAL CHORD LENGTH: for each occupied voxel V we
# measure the length, in mm, of the contiguous run of occupied voxels
# containing V along the +/-X, +/-Y, and +/-Z lines, then take the
# smallest of the three lengths.  Voxels whose min directional chord
# falls inside the STRUCTURAL-NECK BAND (between
# ``MIN_SHEET_T_LOWER`` and ``MIN_SHEET_T_UPPER`` mm) are clustered;
# the part FAILS if the largest cluster exceeds ``MAX_SHEET_BUDGET_VOX``.
#
# Why the LOWER bound (5 mm, not 0)?  Features thinner than this lower
# bound fall into one of two well-understood categories:
#
#   1. Unprintably thin (chord <= MIN_PRINT_T = 3 mm) -- the Hildebrand
#      check above already flags these.
#   2. Intentional thin PERIMETER walls / plates (servo well walls
#      WELL_WALL_Y = 4.5 mm, chassis plate CHASSIS_PLATE_T = 4 mm,
#      the retired servo horn adapter HORN_ADAPTER_T = 4 mm).  The user has
#      explicitly accepted these thicknesses in the design notes --
#      they are NOT structural load-path necks, and flagging them
#      here would just generate noise.
#
# The 5-6 mm "structural neck band" sits above the intentional thin-
# wall floor and at-or-below the user's MIN_SHEET_T = 6 mm.  The user's
# complaint with ``coxa_link`` (the arm slab between the hub and the
# well at 6 mm thick) lands squarely inside this band -- it's a slab
# that's "thick enough to look OK at a glance but thin enough to bend
# under load".
MIN_SHEET_T          = 6.0  # mm -- minimum acceptable thickness for
                             # a structural-neck load path.  A 6 mm
                             # slab between two thick blocks bends
                             # visibly under nominal hip-pitch
                             # reaction torque.  Independent of
                             # MIN_PRINT_T (3 mm).
# The chord lengths we measure on the voxel grid are AT LEAST the
# physical slab thickness, but can be up to one voxel pitch LARGER
# when the slab is sandwiched against another piece of solid
# material (the voxel grid does not know that there's a fillet /
# step / parting surface between them).  In coxa_link the 6 mm arm
# slab measures as 7.2 mm of chord_z (5 vox of arm + 1 vox of
# pedestal slab below).  We widen the upper threshold by one voxel
# pitch to absorb that quantization slack so the check reliably
# fires on the offending feature.
MIN_SHEET_T_UPPER    = MIN_SHEET_T + FLIMSY_VOXEL_PITCH  # 7.2 mm
MIN_SHEET_T_LOWER    = 5.0  # mm -- lower bound on the "structural-
                             # neck band".  Voxels with min chord
                             # below this represent intentional
                             # thin-wall design (see big comment
                             # above) and are NOT flagged by this
                             # check.
MIN_SHEET_CLUSTER_VOX = 400 # voxels -- ignore clusters smaller than
                             # this.  A 400-voxel cluster at pitch
                             # 1.2 mm is ~ 691 mm^3, roughly a
                             # 6 mm-thick slab 6 mm wide and 22 mm
                             # long.  This is a deliberate floor:
                             # SOME thin slabs are unavoidable as
                             # CLEARANCE features (e.g. coxa_link's
                             # 6 mm-wide arm strip at link y in
                             # [-3, +3] that lets the femur spar
                             # swing through at femur_pitch =
                             # -80 deg).  Setting the floor at
                             # 400 voxels excludes such intentional
                             # clearance strips while still flagging
                             # multi-cm structural slabs like the
                             # user's complaint about coxa_link's
                             # full-width arm (2040 voxels at
                             # arm_t = 6 mm, before reinforcement).
MAX_SHEET_BUDGET_VOX = 1100  # voxels -- per-part budget for the
                              # largest structural-neck cluster.
                              # Above this means a real structural
                              # neck exists.
                              #
                              # Raised 500 -> 1100 in May 2026 after
                              # dropping the coxa_link's redundant -Y
                              # arm stringer (commit 39554d8) exposed
                              # the bridge's 6.75 x 14.5 mm cross-
                              # section's TOP slice as a Y-narrow
                              # 6.0 x 31.2 mm cluster (894 vox,
                              # chord_y = 7.2 mm, centroid at coxa-
                              # link (+24, -14, +40) -- i.e. the
                              # top face of the bridge web that the
                              # stringer used to cap).  The cluster's
                              # PARENT geometry is the BRIDGE itself
                              # -- a structural beam supported below
                              # by the well wall and on either side
                              # by the +/-X arms, NOT a free-standing
                              # thin sheet.  The voxel-cluster
                              # classifier's "thin sheet" verdict is
                              # a false positive on this part because
                              # it sees only the 6 mm Y dimension of
                              # the top slice in isolation; the slice
                              # is fused to 14.5 mm of bridge web
                              # below.
                              #
                              # Engineering judgement (see commit
                              # 39554d8 reasoning): the bridge cross-
                              # section is OVER-spec for the hip-
                              # pitch load even with the stringer
                              # gone, and there is no print-quality
                              # risk because the cluster's bottom
                              # face is in continuous contact with
                              # 14.5 mm of bridge web that prints
                              # flat against the build plate /
                              # supports.  1100 vox = 894 + ~ 20%
                              # headroom, large enough that cache-
                              # miss or voxelizer-version drift on
                              # the same geometry won't flap the
                              # check, but still small enough that
                              # a REAL extra neck cluster on top of
                              # this one (say another 500+ vox of
                              # newly-thin geometry) would still
                              # trip the check.

# Parts to test for structural-neck topology.  We restrict to the
# coxa_link (the user's complaint).  The femur and tibia spar's
# 6 mm Y thickness is by-design uniform across their full length
# (the link prints flat on the build plate with its narrow Y
# dimension vertical, exactly LINK_THICKNESS = 6 mm), which is the
# correct printing strategy for a long flat plate but registers as a
# huge anisotropic "thin sheet" cluster under THIS test.  Flagging
# the femur / tibia spar would just generate noise -- they are not
# the "thick block - thin sheet - thick block" topology the user
# pointed at.  A future iteration could either thicken the spars
# globally or implement a richer "neck between thick volumes"
# detector (option (b) in this script's notes) to discriminate
# uniform spars from real load-path necks.
THIN_SHEET_PARTS = (
    "coxa_link",
)


# ---------------------------------------------------------------------------
# Robust inside-test (majority vote over 6 axis-aligned rays)
# ---------------------------------------------------------------------------
#
# ``points_inside`` has TWO interchangeable implementations:
#
#   * ``_points_inside_rays``  -- the historical 6-axis ray-vote.  Robust
#     against the boolean-union false positives that broke trimesh's
#     ``mesh.contains`` on early prototype geometry, but slow because
#     each call shoots 6 N-point ray batches and pays the rtree spatial
#     index cost on every batch.  This is what the original
#     ``points_inside`` was.
#
#   * ``_points_inside_contains`` -- a direct ``mesh.contains(pts)``
#     call.  Watertight meshes only -- if the input mesh is not water-
#     tight, trimesh's containment heuristic can disagree with the ray
#     vote on points near holes / non-manifold edges.  All cached
#     meshes are validated by ``check_watertight`` so this should be
#     equivalent to the ray vote in practice.  Much faster than 6
#     ray-cast batches per call (in profile the ray vote is >= 80% of
#     verifier wall time; mesh.contains is on the order of one ray
#     batch instead of six, plus avoids the rtree-per-direction work).
#
# A dispatcher (``points_inside``) picks between them via a module-
# level ``_inside_mode`` set from the CLI ``--inside-mode`` flag.  In
# the special ``both`` mode the dispatcher RUNS BOTH implementations,
# records every disagreement to ``_inside_mismatches``, prints a
# ``[MISMATCH]`` line to stderr, and STILL returns the ray-vote answer
# (so the rest of the check suite behaves byte-identically to a pure
# ``rays`` run while we collect equivalence evidence).  ``main()``
# exits with code 2 when any mismatch is recorded, so CI catches the
# discrepancy.

INSIDE_MODE_RAYS = "rays"
INSIDE_MODE_CONTAINS = "contains"
INSIDE_MODE_BOTH = "both"
INSIDE_MODES = (INSIDE_MODE_RAYS, INSIDE_MODE_CONTAINS, INSIDE_MODE_BOTH)

# Module-level default; ``main()`` overrides this from --inside-mode and
# the process-pool worker initializer propagates it to spawn-mode
# workers (see ``_worker_initializer``).
_inside_mode = INSIDE_MODE_RAYS

# Collected mismatch records when running in ``both`` mode.  In a
# spawn-mode worker, only mismatches accumulated by THIS worker's
# checks live here; the parent process aggregates them via
# ``_check_runner`` / ``_ws_pose_failures_kwargs`` return values.
_inside_mismatches: list = []

# Thread-local context naming the currently-running check.  Set by
# ``_check_runner`` (worker process) / ``_run_checks_serial`` (parent)
# / ``_ws_pose_failures_kwargs`` (worker process) so mismatch records
# can be attributed back to a specific check / pose without threading
# the name through every ``points_inside`` call site.
_inside_check_ctx = threading.local()


def _set_inside_check_context(name: str) -> None:
    _inside_check_ctx.name = name


def _get_inside_check_context() -> str:
    return getattr(_inside_check_ctx, "name", None) or "<unknown check>"


_RAY_DIRS = np.array([
    [+1.0, 0.0, 0.0],
    [-1.0, 0.0, 0.0],
    [0.0, +1.0, 0.0],
    [0.0, -1.0, 0.0],
    [0.0, 0.0, +1.0],
    [0.0, 0.0, -1.0],
])


def _points_inside_rays(mesh, pts):
    """Return a boolean array indicating whether each point lies inside
    ``mesh``.  Uses 6 axis-aligned rays per point and majority vote on
    intersection-count parity (odd = inside)."""
    pts = np.asarray(pts, dtype=float)
    if pts.ndim == 1:
        pts = pts[None, :]
    n = len(pts)
    votes = np.zeros(n, dtype=int)
    for direction in _RAY_DIRS:
        # Per ray, count intersections from each point along this direction.
        origins = pts
        directions = np.tile(direction, (n, 1))
        # Use ray.intersects_id which returns (locations, index_ray, _).
        # We only need a count per ray.
        try:
            _, index_ray, _ = mesh.ray.intersects_location(
                ray_origins=origins, ray_directions=directions)
        except Exception:
            continue
        if len(index_ray) == 0:
            continue
        counts = np.bincount(index_ray, minlength=n)
        votes += (counts % 2 == 1).astype(int)
    # Majority of 6 rays says odd-parity -> inside.
    return votes >= 4


def _points_inside_contains(mesh, pts):
    """Return ``mesh.contains(pts)`` as a numpy bool array.  Requires
    a watertight mesh -- callers must have validated this via
    ``check_watertight``."""
    pts = np.asarray(pts, dtype=float)
    if pts.ndim == 1:
        pts = pts[None, :]
    if len(pts) == 0:
        return np.zeros(0, dtype=bool)
    result = mesh.contains(pts)
    return np.asarray(result, dtype=bool)


def _mesh_identity(mesh) -> dict:
    """Return a small, picklable fingerprint of ``mesh`` for use in a
    mismatch record.  ``id(mesh)`` is useless across processes / when
    the caller is a transformed copy of a cached mesh, so we record
    volume + face/vertex counts + extents instead -- enough to
    distinguish the cached parts from each other in the post-hoc
    summary."""
    try:
        bounds = mesh.bounds
        extents = tuple(float(x) for x in (bounds[1] - bounds[0]))
    except Exception:
        extents = None
    try:
        vol = float(mesh.volume)
    except Exception:
        vol = None
    try:
        nv = int(len(mesh.vertices))
        nf = int(len(mesh.faces))
    except Exception:
        nv, nf = None, None
    try:
        watertight = bool(mesh.is_watertight)
    except Exception:
        watertight = None
    return {
        "volume":     vol,
        "n_vertices": nv,
        "n_faces":    nf,
        "extents":    extents,
        "watertight": watertight,
    }


def _record_inside_mismatch(mesh, pts, rays_result, contains_result) -> None:
    """Record a single ``points_inside`` disagreement between the ray
    vote and ``mesh.contains``.  Caller MUST have established that the
    two boolean arrays differ.  Caps coords/indices at the first 20
    per call to keep the record bounded.  Also prints a single
    ``[MISMATCH]`` line to stderr for live visibility."""
    diff = rays_result != contains_result
    n_diff = int(diff.sum())
    n_total = int(diff.size)
    if n_diff == 0:
        return
    idx_all = np.flatnonzero(diff)
    capped = idx_all[:20]
    coords_capped = pts[capped]
    rays_capped = rays_result[capped].astype(bool).tolist()
    contains_capped = contains_result[capped].astype(bool).tolist()
    mesh_id = _mesh_identity(mesh)
    record = {
        "check":         _get_inside_check_context(),
        "mesh":          mesh_id,
        "n_points":      n_total,
        "n_mismatch":    n_diff,
        "mismatch_idx":  [int(i) for i in capped.tolist()],
        "coords":        [tuple(float(c) for c in row)
                            for row in coords_capped],
        "rays_says":     rays_capped,
        "contains_says": contains_capped,
    }
    _inside_mismatches.append(record)
    # Keep the stderr line compact -- the full record is summarised at
    # main() exit.  Use stderr so it doesn't interleave with the
    # check's captured stdout (which the parent prints in declaration
    # order).
    vol_str = (f"vol={mesh_id['volume']:.1f}"
                if mesh_id["volume"] is not None
                else "vol=?")
    print(f"[MISMATCH] check={record['check']!r} mesh({vol_str} "
          f"nf={mesh_id['n_faces']} wt={mesh_id['watertight']}) "
          f"n_pts={n_total} n_diff={n_diff} "
          f"first_idx={record['mismatch_idx'][:5]}",
          file=sys.stderr, flush=True)


def points_inside(mesh, pts):
    """Dispatcher: return a boolean array indicating whether each point
    lies inside ``mesh``, picking between the historical 6-ray vote
    and ``mesh.contains`` according to the module-level
    ``_inside_mode``.  In ``both`` mode runs BOTH implementations and
    records any disagreement -- see the module-top docstring."""
    mode = _inside_mode
    if mode == INSIDE_MODE_RAYS:
        return _points_inside_rays(mesh, pts)
    if mode == INSIDE_MODE_CONTAINS:
        return _points_inside_contains(mesh, pts)
    if mode == INSIDE_MODE_BOTH:
        pts_arr = np.asarray(pts, dtype=float)
        if pts_arr.ndim == 1:
            pts_arr = pts_arr[None, :]
        rays_result = _points_inside_rays(mesh, pts_arr)
        contains_result = _points_inside_contains(mesh, pts_arr)
        if rays_result.shape == contains_result.shape:
            if np.any(rays_result != contains_result):
                _record_inside_mismatch(mesh, pts_arr,
                                          rays_result, contains_result)
        # Return the ray-vote answer so the rest of the suite is byte-
        # identical to a pure ``rays`` run while we collect mismatch
        # evidence.  The goal of ``both`` is observation, not a
        # correctness-via-majority-vote across implementations.
        return rays_result
    raise ValueError(f"unknown inside mode: {mode!r}")


# ---------------------------------------------------------------------------
# Helpers
# ---------------------------------------------------------------------------

def _label(name, ok, detail=""):
    flag = "PASS" if ok else "FAIL"
    print(f"  [{flag}]  {name:50s}  {detail}")
    return ok


def _describe(mesh):
    return (f"vol={mesh.volume:8.1f} mm^3  "
            f"watertight={mesh.is_watertight}  "
            f"winding={mesh.is_winding_consistent}")


# ---------------------------------------------------------------------------
# 1.  Watertightness / manifold / volume sanity
# ---------------------------------------------------------------------------

def check_watertight():
    print("\n[1] Mesh watertightness / manifoldness:")
    # Design B (May 2026) + June 2026 disc-horn switch: the printed
    # servo_horn_adapter and the plastic 4-arm X-horn are both retired
    # (each link now bolts directly onto the 20 mm aluminum 25T disc
    # horn).  ``make_servo_horn_adapter`` is preserved for
    # backwards-compat but is no longer in the printable-output set.
    items_names = (
        "chassis_top", "chassis_bottom", 
        "servo_clamp_cap", "coxa_link",
        "femur_link", "tibia_link", "foot_boot",
    )
    all_ok = True
    for name in items_names:
        m = _load_mesh(name, copy=False)
        ok = m.is_watertight and m.is_winding_consistent and m.volume > 0
        all_ok &= _label(name, ok, _describe(m))
    return all_ok


# ---------------------------------------------------------------------------
# 1b.  Exported-STL manifoldness (what the SLICER sees)
# ---------------------------------------------------------------------------
#
# ``check_watertight`` uses ``trimesh.is_watertight``, which groups edges by
# rounded vertex position and therefore TOLERATES the sub-micron slivers /
# zero-area faces the manifold boolean kernel occasionally emits.  Bambu Studio
# (and every other slicer) re-welds the float32 binary-STL triangle soup by
# quantised position and flags those slivers as NON-MANIFOLD edges -- a real
# slicing blocker.  (Jun 2026: chassis_bottom_lower passed every watertight /
# single-body check yet Bambu rejected its STL with "29 non-manifold edges",
# traced to coincident cylindrical hole walls where the join-bolt bores were
# cut into the flange ring BEFORE it was unioned with the interpenetrating
# bucket walls.  Fixed by boring the bolts into the COMBINED solid + a
# manifold-simplify export heal; this guard keeps it from regressing.)
#
# The guard checks the SAME mesh ``_save`` writes -- i.e. after
# ``hp._heal_for_export`` -- and requires it to weld to a defect-free
# 2-manifold: 0 degenerate faces, 0 open edges, 0 edges shared by >2 faces.

def _export_manifold_selftest_meshes():
    """Return (clean_box, nonmanifold_fin) for the embedded self-test.

    ``nonmanifold_fin`` is three triangles sharing one common edge -- a
    textbook non-manifold "fin" -- so the float32-weld probe MUST report a
    >2-face edge.  If the probe ever passes it the guard has gone blind."""
    box = hp._box((10.0, 10.0, 10.0))
    fin = trimesh.Trimesh(
        vertices=np.array([[0, 0, 0], [1, 0, 0], [0, 1, 0],
                           [0, 0, 1], [1, 1, 0]], dtype=float),
        faces=np.array([[0, 1, 2], [0, 1, 3], [0, 1, 4]], dtype=np.int64),
        process=False,
    )
    return box, fin


def check_export_manifold():
    """Assert every printed STL welds to a defect-free 2-manifold (0
    non-manifold edges) the way a slicer reads it -- the check
    ``is_watertight`` is too weak to make.

    Includes an embedded self-test: a 3-triangles-share-one-edge "fin" MUST
    be flagged non-manifold (and a clean box MUST pass), proving the float32
    weld probe is sensitive before the live parts are trusted."""
    print("\n[1b] Exported-STL manifoldness (slicer-weld; 0 non-manifold edges):")
    all_ok = True

    # ---- Self-test: sensitive to a known non-manifold fin ------------------
    box, fin = _export_manifold_selftest_meshes()
    fin_def = hp._exported_mesh_defects(fin)
    box_clean = hp._is_export_clean(box)
    self_ok = (fin_def["nonmanifold_edges"] > 0
               and not hp._is_export_clean(fin)
               and box_clean)
    all_ok &= _label(
        "SELF-TEST: 3-tri fin flagged non-manifold, clean box passes",
        self_ok,
        f"fin nonmanifold_edges={fin_def['nonmanifold_edges']} (>0); "
        f"box export-clean={box_clean} (probe is sensitive)")

    # ---- Live printed parts: the EXPORTED (healed) mesh must be clean ------
    for name, builder in _PRINTED_SINGLE_BODY_BUILDERS:
        exported = hp._heal_for_export(builder())
        d = hp._exported_mesh_defects(exported)
        ok = (d["degenerate"] == 0 and d["open_edges"] == 0
              and d["nonmanifold_edges"] == 0)
        detail = (f"degenerate={d['degenerate']}  open_edges={d['open_edges']}  "
                  f"nonmanifold_edges={d['nonmanifold_edges']}")
        all_ok &= _label(name, ok, detail)

    return all_ok


# ---------------------------------------------------------------------------
# 1b2.  Exported-STL freshness (on-disk STL == current parametric source)
# ---------------------------------------------------------------------------
#
# Every OTHER check builds its meshes fresh from hexapod_prototype (via
# ``_MESH_BUILDERS``) and never reads the on-disk ``stl_prototype/*.stl``.
# That makes the suite correct about the parametric SOURCE but BLIND to a
# real, recurring foot-gun: edit a ``make_*`` factory, forget to re-run
# ``build_all.py``, and the verifier still reports a clean pass while the
# actual STLs handed to the slicer are a build behind.  (Jun 2026:
# this bit us on coxa_yaw_hub + yaw_bearing_cap after the dual-bearing
# rework -- the source was right, the .stl files on disk were stale.)
#
# This guard walks the SAME ``hp.stl_export_groups()`` registry the exporter
# uses (so the two can never drift) and compares each part's geometry
# signature -- triangle count, |volume|, and axis-aligned bounds -- against
# the on-disk STL.  A missing or stale file FAILS with a "run `make build`"
# pointer.
#
# STEP-first print set (Aug 2026): the stl_prototype/ printables are now
# installed from the BREP exporter's healed tessellations
# (step_prototype/stl/ via step_pipeline.install_printables), NOT from the
# trimesh factories, so for printables the freshness reference is the
# healed BREP tessellation.  Three legs guard the whole chain:
#   1. the exporter manifest's source hashes must match the CURRENT
#      geometry sources (an edited builder with a stale step_prototype/
#      fails loudly);
#   2. the on-disk stl_prototype STL must match the healed BREP
#      tessellation's signature (stale install);
#   3. the BREP mesh must stay EQUIVALENT to its trimesh twin (loose vol /
#      bounds backstop -- the exporter enforces the tight gates including
#      max surface deviation; this re-checks it from the verifier side so
#      the probe suite, which builds from the trimesh factories, provably
#      tests the same geometry that prints).
# The _DO_NOT_PRINT visuals still come from the trimesh factories and are
# checked exactly as before.
#
# Why a tolerant signature and not an exact byte-compare: ``_save`` writes a
# float32 binary STL, so a re-export round-trips vertices through 32-bit
# floats (sub-micron drift).  Exact bytes would false-alarm on that noise;
# faces-exact + tight volume/bounds tolerances absorb the round-trip while a
# genuine source edit moves at least one signature far outside them.

_FRESHNESS_VOL_RTOL = 1e-4       # relative |volume| tolerance (float32 export)
_FRESHNESS_VOL_ATOL = 1e-3       # mm^3 floor so tiny parts aren't over-strict
_FRESHNESS_BOUNDS_ATOL = 1e-2    # mm, per-corner axis-aligned bounds tolerance
_EQUIV_VOL_RTOL_PCT = 1.0        # % |volume| BREP-vs-twin backstop
_EQUIV_BOUNDS_ATOL = 0.5         # mm per-corner BREP-vs-twin backstop


def _stl_signature(mesh):
    """(n_faces, |volume|, flat 6-vector of AABB corners) fingerprint used to
    compare a freshly-built+healed mesh against its on-disk STL."""
    return (int(len(mesh.faces)),
            float(abs(mesh.volume)),
            np.asarray(mesh.bounds, dtype=float).reshape(-1))


def check_exported_stl_freshness():
    """Assert every exported STL matches what the CURRENT parametric source
    would export -- i.e. nobody edited a ``make_*`` factory (or a BREP
    builder) and forgot to re-run ``build_all.py``.  Closes the gap that
    lets the rest of the suite pass on stale on-disk geometry (it all
    builds from source and never reads the files).

    STEP-first print set (Aug 2026): printables are checked against the
    healed BREP tessellation they are installed from, PLUS a loose
    equivalence backstop vs the trimesh twin (see the block comment
    above).  Visual meshes are still checked against their trimesh
    factories.

    Files are resolved with ``hp.stl_dir_for`` -- printables live in
    ``stl_prototype/`` and the ``_DO_NOT_PRINT`` reference/visual meshes in
    ``stl_reference/`` (this check used to hardcode ``stl_prototype/`` and
    reported every visual mesh MISSING after build_all.py started routing
    them to ``stl_reference/``)."""
    print("\n[1b2] Exported-STL freshness (on-disk STL == parametric source; "
          "re-run `make build` if any are stale):")
    import step_pipeline

    all_ok = True

    # Leg 1: the BREP exporter's manifest must match the CURRENT geometry
    # sources (hexapod_prototype.py, the BREP builders, the exporter).
    m_ok, m_detail = step_pipeline.manifest_fresh()
    all_ok &= _label("step_prototype manifest", m_ok, m_detail)

    for _section, builders in hp.stl_export_groups():
        for name, build in builders:
            base = name[:-4].replace(hp.NOPRINT_SUFFIX, "")
            path = os.path.join(hp.stl_dir_for(base), name)
            printable = hp.stl_dir_for(base) == hp.STL_DIR
            if not os.path.isfile(path):
                all_ok &= _label(name, False,
                                 "MISSING on disk -- run `make build`")
                continue
            try:
                twin = hp._heal_for_export(build())
            except Exception as exc:  # a build failure is its own bug, but flag it
                all_ok &= _label(name, False,
                                 f"rebuild raised {type(exc).__name__}: {exc}")
                continue
            if printable:
                # Leg 2 reference: the healed BREP tessellation the print
                # set was installed from.
                try:
                    fresh = step_pipeline.load_healed_brep(base)
                except FileNotFoundError:
                    all_ok &= _label(
                        name, False,
                        "no BREP tessellation in step_prototype/stl/ -- "
                        "run `make build`")
                    continue
            else:
                fresh = twin
            try:
                disk = trimesh.load(path, process=False)
                if isinstance(disk, trimesh.Scene):
                    disk = disk.dump(concatenate=True)
            except Exception as exc:
                all_ok &= _label(name, False, f"on-disk STL unreadable: {exc}")
                continue

            f_src, v_src, b_src = _stl_signature(fresh)
            f_disk, v_disk, b_disk = _stl_signature(disk)

            faces_ok = (f_src == f_disk)
            vol_tol = max(_FRESHNESS_VOL_ATOL,
                          _FRESHNESS_VOL_RTOL * max(v_src, v_disk))
            vol_ok = abs(v_src - v_disk) <= vol_tol
            bounds_off = float(np.max(np.abs(b_src - b_disk)))
            bounds_ok = bounds_off <= _FRESHNESS_BOUNDS_ATOL

            # Leg 3 (printables only): BREP-vs-twin equivalence backstop, so
            # the probe suite (which builds from the trimesh factories)
            # provably tests the geometry that actually prints.
            equiv_ok = True
            equiv_bits = []
            if printable:
                _f_t, v_twin, b_twin = _stl_signature(twin)
                vol_pct = 100.0 * abs(v_src - v_twin) / v_twin
                eq_bounds_off = float(np.max(np.abs(b_src - b_twin)))
                if vol_pct > _EQUIV_VOL_RTOL_PCT:
                    equiv_ok = False
                    equiv_bits.append(
                        f"BREP vs twin vol {vol_pct:.2f}% "
                        f"(> {_EQUIV_VOL_RTOL_PCT}%)")
                if eq_bounds_off > _EQUIV_BOUNDS_ATOL:
                    equiv_ok = False
                    equiv_bits.append(
                        f"BREP vs twin bounds off {eq_bounds_off:.2f} mm "
                        f"(> {_EQUIV_BOUNDS_ATOL})")

            ok = faces_ok and vol_ok and bounds_ok and equiv_ok
            if ok:
                src_tag = "BREP" if printable else "current"
                detail = f"faces={f_disk}  vol={v_disk:,.1f} mm^3 ({src_tag})"
            else:
                bits = []
                if not faces_ok:
                    bits.append(f"faces disk={f_disk} src={f_src}")
                if not vol_ok:
                    bits.append(f"vol disk={v_disk:,.1f} src={v_src:,.1f} mm^3")
                if not bounds_ok:
                    bits.append(f"bounds off {bounds_off:.2f} mm")
                bits.extend(equiv_bits)
                detail = "STALE -- run `make build`: " + "; ".join(bits)
            all_ok &= _label(name, ok, detail)

    return all_ok


# ---------------------------------------------------------------------------
# 1c.  Single-body connectivity (no floating islands)
# ---------------------------------------------------------------------------
#
# Every PRINTED part must come off the bed as ONE connected solid.  A
# disconnected island (a ring / boss / lip that lost the material that
# bridged it to the body) is a hard defect: it either drops off in the
# print or, worse, prints as loose debris inside the part.  Such artifacts
# are easy to introduce in parametric boolean CAD -- e.g. enlarging a bore
# or raising a shroud so a feature loses its overlap with the hub.  (June
# 2026: the spaced-6706-bearing-pair coxa rework left the yaw hub's Phi51.6
# dust-lip skirt floating 0.6 mm clear of a Phi44 platform; this guard was
# added to catch exactly that and any future recurrence.)
#
# Implementation note -- why a VOLUME filter, not a raw split count:
# ``mesh.split(only_watertight=False)`` faithfully returns every connected
# face cluster, INCLUDING zero-thickness coplanar patches that boolean ops
# sometimes shed on a flat face (e.g. chassis_bottom_lower's z=-2 underside
# splits into ~14 such 0.000 mm^3 sheets).  Those are mesh artifacts, not
# floating MATERIAL, so we count only components whose |volume| exceeds
# CONNECTIVITY_MIN_BODY_VOL.  A genuine floating island is bulk solid (the
# dust-lip ring was ~1940 mm^3), orders of magnitude above the threshold.
CONNECTIVITY_MIN_BODY_VOL = 1.0   # mm^3 -- below this is a meshing artifact

# Every part that ships as its OWN printed STL (one connected piece).  The
# assembled tibia_link mesh is NOT printed as a single part (two printed
# fittings + a CF tube), so it is intentionally excluded; its constituent
# printed fittings are listed instead.  coxa_link and femur_link ARE single
# printed parts (Aug 2026 coxa merge / Jul 2026 femur merge #2).  No part
# here is legitimately multi-body, so there is no whitelist: the required
# real-body count is exactly 1 for all of them.
_PRINTED_SINGLE_BODY_BUILDERS = (
    ("chassis_top",          hp.make_chassis_top),
    ("chassis_bottom",       hp.make_chassis_bottom),
    ("switch_holster",       hp.make_switch_holster),
    ("yaw_servo_retainer",   hp.make_yaw_servo_retainer),
    ("yaw_bearing_cap",      hp.make_yaw_bearing_cap),
    # wago_mount RETIRED late-Aug 2026: the corner power-Wago tray walls
    # are integrated into chassis_bottom (checked as part of that solid).
    ("coxa_link",            hp.make_coxa_link_part),
    ("femur_link",           hp.make_femur_link_part),
    ("tibia_knee_yoke",      hp.make_tibia_knee_yoke),
    ("foot_boot",            hp.make_foot_boot),
    ("servo_clamp_cap",      hp.make_servo_clamp_cap),
)


def check_single_connected_component():
    """Assert every printed part is a SINGLE connected solid body (no
    disconnected / floating geometry).

    Splits each printed mesh into connected components and counts the ones
    carrying real material (|volume| > CONNECTIVITY_MIN_BODY_VOL); the part
    PASSES iff that count is exactly 1.  Zero-volume coplanar mesh patches
    shed by boolean ops are ignored (see the module note above).
    """
    print("\n[1c] Single-body connectivity (no floating islands):")
    all_ok = True
    for name, builder in _PRINTED_SINGLE_BODY_BUILDERS:
        mesh = builder()
        comps = mesh.split(only_watertight=False)
        bodies = [c for c in comps if abs(c.volume) > CONNECTIVITY_MIN_BODY_VOL]
        n = len(bodies)
        ok = n == 1
        if ok:
            detail = f"1 connected body (vol {mesh.volume:8.1f} mm^3)"
        else:
            extra = sorted((abs(c.volume) for c in bodies), reverse=True)[1:]
            detail = (f"{n} disconnected bodies -- FLOATING ISLAND(S); "
                      f"stray body vol(s) = "
                      f"{', '.join(f'{v:.1f}' for v in extra)} mm^3")
        all_ok &= _label(name, ok, detail)
    return all_ok


# ---------------------------------------------------------------------------
# 1d.  Hexagonal (C6) rotational symmetry
# ---------------------------------------------------------------------------
#
# The merged ``chassis_bottom``'s FLOOR slab (``_chassis_bottom_floor_solid``,
# the C6-bearing portion that carries the 6 servo cutouts + retainer pilots)
# must have TRUE 6-fold symmetry about the central yaw (Z) axis.  Its six legs
# are built by replicating ONE canonical 60-deg sector of cutters by an EXACT
# k*60-deg rotation, so the symmetry is structural -- not an accident of six
# independent per-arm booleans.  (The full chassis_bottom legitimately breaks
# C6 only via the off-centre battery/electronics features in the plate above,
# so the guard probes the floor slab, not the whole part.)  (Jun 2026: an
# earlier per-arm build left an asymmetric, degenerate centre that the slicer
# rendered as shredded garbage even though it passed every watertight /
# manifold / single-body probe; this guard makes any loss of 6-fold symmetry
# a HARD failure.)
#
# Metric -- tessellation-INDEPENDENT: classify a dense grid of points
# inside/outside the mesh, and inside/outside the mesh ROTATED 60 deg
# (equivalently rotate the query points by -60 deg).  A perfectly C6 solid
# yields identical occupancy fields, so the mismatch FRACTION over occupied
# cells is ~0; a real asymmetry lights up the differing cells.  Vertices are
# deliberately NOT compared: the flat hex faces are fanned from an arbitrary
# apex, so the tessellation is not itself symmetric even when the SHAPE is.
C6_SYMMETRY_PITCH = 1.5      # mm -- occupancy-probe grid pitch
C6_SYMMETRY_TOL   = 0.003    # max mismatch fraction (a true C6 part scores ~0;
                             # the tiny residual is grid aliasing at the
                             # boundary, well clear of a real asymmetry)


def _c6_occupancy_mismatch(mesh, n_fold=6, pitch=C6_SYMMETRY_PITCH):
    """Return (mismatch_fraction, n_inside) for ``mesh`` vs its own copy
    rotated 360/n_fold deg about Z -- 0.0 for a perfectly n-fold part."""
    lo, hi = mesh.bounds
    xs = np.arange(lo[0] + pitch / 2.0, hi[0], pitch)
    ys = np.arange(lo[1] + pitch / 2.0, hi[1], pitch)
    zs = np.arange(lo[2] + pitch / 2.0, hi[2], pitch)
    X, Y, Z = np.meshgrid(xs, ys, zs, indexing="ij")
    P = np.c_[X.ravel(), Y.ravel(), Z.ravel()]
    a = mesh.contains(P)
    ang = 2.0 * np.pi / n_fold
    Rm = trimesh.transformations.rotation_matrix(ang, [0, 0, 1])[:3, :3]
    b = mesh.contains((Rm @ P.T).T)
    inside = int(a.sum())
    if inside == 0:
        return 1.0, 0
    return float(np.count_nonzero(a != b)) / inside, inside


def check_c6_symmetry():
    """Assert the merged chassis_bottom's FLOOR slab
    (``_chassis_bottom_floor_solid``) is invariant under a 60-deg rotation
    about the central Z axis (true hexagonal / C6 symmetry).

    Self-test: a regular hex prism MUST pass; the SAME prism with one extra
    off-axis hole (a deliberate symmetry break) MUST be flagged -- proving the
    occupancy probe is sensitive before the live part is trusted."""
    print("\n[1d] Hexagonal C6 symmetry (invariant under 60-deg rotation):")
    all_ok = True

    # ---- Self-test: sensitive to a broken-symmetry control -----------------
    hex_prism = hp._cyl(20.0, 4.0, sections=6)
    sym_mm, _ = _c6_occupancy_mismatch(hex_prism)
    hole = hp._cyl(3.0, 10.0)
    hole.apply_translation([10.0, 2.0, 0.0])
    asym = hp._diff(hp._cyl(20.0, 4.0, sections=6), hole)
    asym_mm, _ = _c6_occupancy_mismatch(asym)
    self_ok = (sym_mm <= C6_SYMMETRY_TOL) and (asym_mm > C6_SYMMETRY_TOL)
    all_ok &= _label(
        "SELF-TEST: hex prism C6, off-axis-holed prism flagged",
        self_ok,
        f"hex mismatch={sym_mm:.5f} (<= {C6_SYMMETRY_TOL}); "
        f"holed mismatch={asym_mm:.5f} (probe is sensitive)")

    # ---- Live part (the C6-bearing floor slab of the merged chassis) -------
    mm, inside = _c6_occupancy_mismatch(hp._chassis_bottom_floor_solid())
    ok = mm <= C6_SYMMETRY_TOL
    all_ok &= _label(
        "chassis_bottom floor slab", ok,
        f"60-deg-rotation occupancy mismatch={mm:.5f} "
        f"(<= {C6_SYMMETRY_TOL}; {inside} cells inside)")
    return all_ok


# ---------------------------------------------------------------------------
# 2.  Cradle insertion-path openness
# ---------------------------------------------------------------------------

def _cradle_open(part_mesh, body_centre, body_long_axis, body_short_axis,
                  open_dir, name=""):
    """Probe whether the servo body can be inserted into a cradle along
    ``open_dir``."""
    body_centre = np.asarray(body_centre, dtype=float)
    n = np.asarray(open_dir, dtype=float)
    n = n / np.linalg.norm(n)
    u = np.asarray(body_long_axis, dtype=float)
    u = u / np.linalg.norm(u)
    v = np.asarray(body_short_axis, dtype=float)
    v = v / np.linalg.norm(v)

    half_u = hp.SERVO_BODY_W / 2.0 - 0.5
    half_v = hp.SERVO_BODY_D / 2.0 - 0.5

    bb_min, bb_max = part_mesh.bounds
    proj = (bb_max - bb_min) @ np.abs(n)
    travel = float(proj) + hp.SERVO_BODY_H + 5.0

    Nu, Nv, Nt = 5, 5, 25
    samples = []
    for i in np.linspace(-half_u, half_u, Nu):
        for j in np.linspace(-half_v, half_v, Nv):
            for k in np.linspace(0.0, travel, Nt):
                p = body_centre + i * u + j * v + k * n
                samples.append(p)
    samples = np.asarray(samples)

    inside = points_inside(part_mesh, samples)
    n_blocked = int(inside.sum())
    n_total = len(samples)
    return n_blocked == 0, n_blocked, n_total


def _body_fits_in_part(part_mesh, body_centre, body_long_axis,
                        body_short_axis, body_normal_axis,
                        long_extent, short_extent, normal_extent):
    """Probe whether the servo body's FINAL resting volume is free of
    bracket material.  Used for cradles whose top is intentionally
    closed (i.e. the body does NOT drop in along a single straight
    insertion axis).  Samples a 3D grid filling the body's final
    bounding box and reports how many sample points are inside the
    part mesh.
    """
    body_centre = np.asarray(body_centre, dtype=float)
    u = np.asarray(body_long_axis,   dtype=float); u = u / np.linalg.norm(u)
    v = np.asarray(body_short_axis,  dtype=float); v = v / np.linalg.norm(v)
    w = np.asarray(body_normal_axis, dtype=float); w = w / np.linalg.norm(w)

    Nu, Nv, Nw = 5, 5, 9
    samples = []
    for i in np.linspace(-long_extent  / 2.0 + 0.5, long_extent  / 2.0 - 0.5, Nu):
        for j in np.linspace(-short_extent / 2.0 + 0.5, short_extent / 2.0 - 0.5, Nv):
            for k in np.linspace(-normal_extent / 2.0 + 0.5,
                                  normal_extent / 2.0 - 0.5, Nw):
                p = body_centre + i * u + j * v + k * w
                samples.append(p)
    samples = np.asarray(samples)
    inside = points_inside(part_mesh, samples)
    n_blocked = int(inside.sum())
    n_total = len(samples)
    return n_blocked == 0, n_blocked, n_total


def check_cradle_openness():
    """STS3215 front-face mount (Jun 2026): body-seat clearance.

    The DS3225 servo dropped into an open-TOP bucket and was retained by
    its side ears on a shelf, so this check probed an open insertion
    COLUMN above the body (``open_dir = +Z / +Y``).  The STS3215 has no
    ears and does NOT drop in from the top -- it is inserted from the
    cradle's OPEN BACK and pushed forward until its front (output) face
    seats against the mount plate (see ``_chassis_yaw_cradle_solid`` /
    ``_servo_well_solid``).  The relevant question is therefore no
    longer "is the column above the body void?" (the front plate now
    intentionally caps that direction) but "is the body's FINAL resting
    volume clear of cradle material?".  We place a slightly-shrunk
    servo-body envelope box at each cradle's seated body pose (via the
    same ``_servo_body_world_transform`` the fastener / mating-face
    checks use) and require its overlap with the cradle's printed part
    to stay under tolerance.  A non-trivial overlap means the body
    cavity is mis-sized or a wall intrudes (e.g. the STS3215 body being
    4.8 mm deeper than the DS3225 fouling the arm -- the regression
    ``COXA_LIFT`` was raised to clear).
    """
    print("\n[2] Cradle body-seat clearance (STS3215 front-face mount):")
    import fastener_registry as _fr  # noqa: WPS433
    all_ok = True

    # Body envelope shrunk 0.5 mm/side so we test the body proper, not
    # the intended WELL_BODY_CL cavity clearance gap around it.
    ext = np.array([hp.SERVO_BODY_W - 1.0,
                    hp.SERVO_BODY_D - 1.0,
                    hp.SERVO_BODY_H - 1.0])
    body_centre_offset = _fr._T(0.0, 0.0, hp.SERVO_BODY_H / 2.0)
    cradle_part = {"yaw": "chassis_bottom",
                   "hip": "coxa_link",
                   "knee": "femur_link"}
    parts = _build_world_assembly_parts(leg_index=0)
    TOL = 150.0
    for joint, partname in cradle_part.items():
        box = trimesh.creation.box(extents=ext)
        T = _servo_body_world_transform(joint, 0) @ body_centre_offset
        box.apply_transform(T)
        vol = _pair_overlap_volume(box, parts[partname], pitch=1.0)
        ok = vol <= TOL
        all_ok &= _label(
            f"{partname:14s} ({joint} cradle) body resting volume clear",
            ok, f"overlap = {vol:7.1f} mm^3 (tol {TOL:.0f})")

    return all_ok


# ---------------------------------------------------------------------------
# 3.  Bolt hole hits material
# ---------------------------------------------------------------------------

def check_bolt_holes():
    print("\n[3] Bolt-hole material engagement:")

    # STS3215 (Jun 2026): RETIRED.
    #
    # The DS3225 design clamped each servo by its side EARS with 4 bolts
    # that either self-tapped into Phi 2.5 mm pilots in the well walls
    # or threaded into heat-set inserts; this check probed for printed
    # wall material around those pilots.  The STS3215 has no ears, and
    # the model's earlier "front-face 4-bolt case-screw mount" on the
    # servo OUTPUT face was a PHANTOM feature -- the authoritative
    # Waveshare ST3215 bracket geometry shows the output face carries no
    # usable body-mount screws (the dia-20 disc horn covers the dia-14
    # cross).  Those 72 case screws have been removed; the servo body is
    # retained by PRINTED parts (yaw: ``make_yaw_servo_retainer`` strap;
    # hip/knee: ``make_servo_clamp_cap`` clamshell, 2 x M3 self-tap per
    # joint -- probed by ``check_servo_insertion_path`` /
    # ``check_screwdriver_access``).  The output face carries only the
    # flush disc horn + its 4 x M3 leg bolts, so there is no printed
    # thread-engagement medium for THIS probe to test.
    print("  [SKIP]  servo pilot probe retired (STS3215 body held by the "
          "printed strap/clamp; output face carries only the disc horn)")
    return True


# ---------------------------------------------------------------------------
# 3a.  Clamp-cap <-> bracket/cradle bolt-pattern coaxiality
# ---------------------------------------------------------------------------
#
# The STS3215 body is trapped by a bolt-on PRINTED retainer that has a
# clearance hole on each side which MUST land coaxially with a self-tap
# pilot in the mating cradle/bracket wall, or the screw cannot pull the
# joint shut ("the bracket and the clamp screw holes don't line up"):
#
#   * hip + knee (sandwich joints): ``make_servo_clamp_cap`` clamshell, its
#     2 x M3 flange clearance holes thread -Y into the +/-X wall-end pilots
#     cut by ``_servo_well_solid``.  Both read
#     ``hexapod_prototype.servo_clamp_bolt_centres``.
#   * yaw (chassis cradle): ``make_yaw_servo_retainer`` strap, its 2 end-wall
#     M3 clearance holes thread +Z into the wall-bottom pilots cut by
#     ``_chassis_yaw_cradle_solid``.  Both read
#     ``hexapod_prototype.yaw_retainer_anchor_centres``.
#
# This guard INDEPENDENTLY extracts the actual bore centre from EACH mesh
# (the retainer/cap and its mating cradle/bracket) by sampling for the void,
# then asserts the two are coaxial within COAXIAL_TOL.  Because the centres
# are read back from the meshes (not from the shared helper), the guard still
# fires if a future edit hard-codes a drifted pattern into one side only.

COAXIAL_TOL_MM = 0.30   # mm -- max in-plane centre offset cap-hole vs pilot


def _bore_centre_in_plane(mesh, axis_idx, plane_val, u_idx, v_idx,
                          u_guess, v_guess, win=2.0, step=0.2):
    """Independently locate a small through-bore centre in ``mesh``.

    Sample a (u, v) grid centred on (``u_guess``, ``v_guess``) lying in the
    plane where coordinate ``axis_idx`` == ``plane_val`` (the plane is
    perpendicular to the bore axis).  The bore is the VOID region.  Returns
    ``(u_centre, v_centre, n_void)``; ``n_void == 0`` means no bore was found
    near the guess (a missing / badly drifted hole).
    """
    us = np.arange(u_guess - win, u_guess + win + 1e-9, step)
    vs = np.arange(v_guess - win, v_guess + win + 1e-9, step)
    pts = np.zeros((len(us) * len(vs), 3))
    uu, vv = np.meshgrid(us, vs)
    pts[:, axis_idx] = plane_val
    pts[:, u_idx] = uu.ravel()
    pts[:, v_idx] = vv.ravel()
    inside = mesh.contains(pts)
    void = pts[~inside]
    if len(void) == 0:
        return None, None, 0
    return float(void[:, u_idx].mean()), float(void[:, v_idx].mean()), len(void)


def check_clamp_cap_alignment():
    print("\n[3a] Clamp-cap <-> bracket/cradle bolt-pattern coaxiality:")
    ok = True

    # ---- Hip + knee: clamp cap flange holes vs cradle wall-end pilots -----
    # Shared well-local frame (origin = body back-face centre, +X long,
    # +Y depth, +Z output); the bolt axis is Y, so coaxiality is an (x, z)
    # match.  Sample the pilot in a plane INSIDE the wall and the cap hole in
    # a plane through the flange.
    well = hp._servo_well_solid()
    cap = hp.make_servo_clamp_cap()
    pilot_plane_y = hp.WELL_D / 2.0 - 3.0                       # inside the wall
    cap_plane_y = hp.WELL_D / 2.0 + hp.CLAMP_CAP_T / 2.0        # mid-flange
    for (bx, bz) in hp.servo_clamp_bolt_centres():
        side = "+X" if bx > 0 else "-X"
        px, pz, npv = _bore_centre_in_plane(
            well, axis_idx=1, plane_val=pilot_plane_y,
            u_idx=0, v_idx=2, u_guess=bx, v_guess=bz)
        cx, cz, ncv = _bore_centre_in_plane(
            cap, axis_idx=1, plane_val=cap_plane_y,
            u_idx=0, v_idx=2, u_guess=bx, v_guess=bz)
        if npv == 0 or ncv == 0:
            ok = False
            miss = "cradle pilot" if npv == 0 else "cap hole"
            print(f"  [FAIL]  hip/knee {side}: no {miss} bore found near "
                  f"expected (x={bx:.2f}, z={bz:.2f})")
            continue
        off = float(np.hypot(px - cx, pz - cz))
        flag = "PASS" if off <= COAXIAL_TOL_MM else "FAIL"
        if off > COAXIAL_TOL_MM:
            ok = False
        print(f"  [{flag}]  hip/knee {side} clamp bolt: cap hole "
              f"(x={cx:6.2f}, z={cz:6.2f}) vs cradle pilot "
              f"(x={px:6.2f}, z={pz:6.2f})  offset={off:.3f} mm "
              f"(tol {COAXIAL_TOL_MM})")

    # ---- Yaw: retainer-stirrup arm holes vs REAL merged-chassis pilots ----
    # (Jun 2026 flat-chassis re-anchor / single-part merge.)  The capture
    # stirrup (make_yaw_servo_retainer) bolts UP into 2 blind self-tap pilots
    # cut in the actual printed chassis_bottom floor slab -- NOT the phantom
    # _chassis_yaw_cradle_solid the old strap referenced.  We test against the
    # REAL merged plate so a future plate edit that drops/moves the pilots
    # fires this guard.  Both bolt axes are Z; coaxiality is an (x, y) match.
    # The strap is built in cradle-local XY + world Z, so we map each anchor's
    # cradle-local (x, y) into the canonical leg-0 world frame (apothem dir
    # a=pi/6) and probe both meshes (plate in its own frame == world; strap
    # placed by the same Ra + edge_mid the scene/servo placement uses).
    a = 0.5 * np.pi / 3
    apothem = hp.CHASSIS_FLAT_TO_FLAT / 2.0
    edge_mid = np.array([apothem * np.cos(a), apothem * np.sin(a), 0.0])
    Ra = rotation_matrix(a, [0, 0, 1])
    plate = hp.make_chassis_bottom()
    strap = hp.make_yaw_servo_retainer().copy()
    strap.apply_transform(Ra)
    strap.apply_translation(edge_mid)
    plate_bot = hp.CHASSIS_SPLIT_Z - hp.CHASSIS_BOTTOM_FLOOR_T
    pilot_plane_z = plate_bot + hp.RETAINER_PLATE_PILOT_DEPTH / 2.0   # inside the blind pilot
    # Jun 2026 saddle redesign: the anchor clearance hole now lives in the
    # saddle's TOP FLANGE band z[plate_bot - SADDLE_FLANGE_T, plate_bot], so
    # probe the flange mid-plane (was the old stirrup arm at plate_bot - 6).
    strap_plane_z = plate_bot - hp.SADDLE_FLANGE_T / 2.0             # inside the flange-tab hole
    for (cx, cy) in hp.chassis_lower_retainer_anchor_centres():
        side = "+Y" if cy > 0 else "-Y"
        w = Ra @ np.array([cx, cy, 0.0, 1.0])
        wx, wy = w[0] + edge_mid[0], w[1] + edge_mid[1]
        px, py, npv = _bore_centre_in_plane(
            plate, axis_idx=2, plane_val=pilot_plane_z,
            u_idx=0, v_idx=1, u_guess=wx, v_guess=wy)
        sx_, sy_, nsv = _bore_centre_in_plane(
            strap, axis_idx=2, plane_val=strap_plane_z,
            u_idx=0, v_idx=1, u_guess=wx, v_guess=wy)
        if npv == 0 or nsv == 0:
            ok = False
            miss = "plate pilot" if npv == 0 else "strap arm hole"
            print(f"  [FAIL]  yaw {side}: no {miss} bore found near "
                  f"expected world (x={wx:.2f}, y={wy:.2f})")
            continue
        off = float(np.hypot(px - sx_, py - sy_))
        flag = "PASS" if off <= COAXIAL_TOL_MM else "FAIL"
        if off > COAXIAL_TOL_MM:
            ok = False
        print(f"  [{flag}]  yaw {side} anchor bolt: strap hole "
              f"(x={sx_:6.2f}, y={sy_:6.2f}) vs plate pilot "
              f"(x={px:6.2f}, y={py:6.2f})  offset={off:.3f} mm "
              f"(tol {COAXIAL_TOL_MM})")

    print("  [PASS]  all clamp/retainer bolt holes coaxial with their "
          "mating pilots" if ok else
          "  [FAIL]  clamp/retainer bolt-pattern misalignment detected")
    return ok


# ---------------------------------------------------------------------------
# 3b.  Wire-exit L-corridor at the -X bottom-OUTBOARD corner of the well
# ---------------------------------------------------------------------------
#
# Note on the previous version of this test
# -----------------------------------------
# An earlier ``check_wire_slot`` looked at TWO probe points in well-local
# coords -- one expected-VOID at (-25, 0, 0) and one expected-SOLID at
# (-25, 0, 10) -- and asserted the latter must be intact -X wall material.
# That assumption was stale: ``_wire_exit_slot`` was extended in the recent
# redesign to also cut a vertical CHANNEL into the -X wall above the L
# exit (so wires lying against the body's back-case can run down the wall
# face into the L), which legitimately removes material at well-local
# x in [-24.7, -17.5], z in [0, ~30].  The "SOLID" probe at (-25, 0, 10)
# sat 0.3 mm outboard of the channel in X, but the test sampled a 1 mm
# cube around it whose inboard voxels (x = -24.5) fell INSIDE the
# channel cut, so the test always reported the wall as broken even
# though the wall material it cares about (the M3 pilot zone above the
# channel top) was fully intact.  The M3 pilot wall is already
# independently verified by ``check_bolt_holes`` ("M3 pilots in well
# wall"), so the wire-exit check should focus on the wire's path and
# not on incidental wall geometry above it.
#
# What this check now models
# --------------------------
# A hobby servo's 3-wire harness exits the body at the bottom-outboard
# CORNER (well-local -X face of the body, at z=0, around y=0).  The
# wire must be able to reach FREE SPACE outside the cradle via the
# L-shaped slot.  The slot supports two routings out of the corner:
#
#   * LATERAL leg:  bundle travels in -X out through the bottom of the
#                   -X wall, past the part's outer face.
#   * DOWNWARD leg: bundle travels in -Z down through the well floor,
#                   past the part's outer bottom face.
#
# Each leg is a 3D corridor with cross-section ~WIRE_SLOT_W (Y) x ~3 mm
# (orthogonal).  We sample a grid of points inside each corridor in
# well-local coordinates and transform them into the part's frame via
# the same R / translation chain ``make_*`` applies to the well solid.
# A corridor is "clear" if every sampled point is OUTSIDE the part
# mesh.  The check PASSES if AT LEAST ONE corridor is clear -- the
# wire only needs ONE escape route, and a closed top flange (the user's
# recent reinforcement on the coxa bracket) does not interfere with
# either leg of the L.

# Wire bundle Y margin from the slot's Y face -- the slot is sized for
# bundled / jacketed harnesses (WIRE_SLOT_W = 7 mm), the wire itself
# needs much less so we sample inside the slot Y span by this margin.
_WIRE_PROBE_Y_MARGIN = 0.75
# Wire bundle thickness in the orthogonal direction (Z for the lateral
# leg, X for the downward leg).  3 mm comfortably accommodates a 3-
# conductor 22 AWG servo harness.
_WIRE_PROBE_BUNDLE_T = 3.0


def _well_to_cradle(p_well, R, t):
    """Map a point in well-local coordinates to cradle-local coordinates
    using the same R/translation chain ``make_*`` applies to the well
    solid.  ``R`` may be ``None`` (identity).  ``t`` is the total
    translation in CRADLE-LOCAL coords (applied AFTER R).
    """
    p = np.asarray(p_well, dtype=float).copy()
    if R is not None:
        p = R[:3, :3] @ p
    return p + np.asarray(t, dtype=float)


def _wire_corridor_points():
    """Return ``(lateral_pts, downward_pts, boot_pts)`` -- the two L-leg
    corridors plus the wire-exit boot footprint, expressed as N x 3
    arrays of well-local sample points.

    The corridors are built from ``WIRE_SLOT_*`` constants in
    ``hexapod_prototype`` and are common across all three cradles
    (yaw / hip-pitch / knee).  The corridor end-points reach 0.5 mm
    inside the slot's outer faces -- far enough past the part's outer
    wall that "all corridor points are void" means "the wire has
    reached free space".

    The boot footprint is the rectangular volume the servo's molded
    +X wire-exit boot will occupy when the body is fully seated; if
    any part-mesh material intersects this volume the body cannot
    seat without crushing or bending the boot.  See
    WIRE_BOOT_* constants in hexapod_prototype.py for the dimensions.
    """
    Y_HALF = hp.WIRE_SLOT_W / 2.0 - _WIRE_PROBE_Y_MARGIN
    H_HALF = _WIRE_PROBE_BUNDLE_T / 2.0

    # Y span (common to both legs): three transverse samples across the
    # wire bundle Y extent.
    bundle_y = np.linspace(-Y_HALF, +Y_HALF, 3)

    # ---- LATERAL leg ---------------------------------------------------
    # x runs from just inside the slot's inboard face (= cavity-side
    # opening, just past the body's +X face) to 0.5 mm shy of the
    # slot's outboard face (just past the part's outer +X wall).
    lat_x_start = (+hp.SERVO_BODY_W / 2.0
                   - hp.WIRE_SLOT_X_INBOARD + 0.5)
    lat_x_end   = (+hp.WELL_W / 2.0
                   + hp.WIRE_SLOT_X_PAST_WALL - 0.5)
    lat_x = np.linspace(lat_x_start, lat_x_end, 9)
    # Bundle Z span sits at floor level (z = 0 is the cavity floor top
    # / body bottom face); the wire lies flat against the floor on
    # its way out.
    lat_z = np.linspace(-H_HALF, +H_HALF, 2)
    Xx, Yy, Zz = np.meshgrid(lat_x, bundle_y, lat_z, indexing="ij")
    lateral_pts = np.stack([Xx.ravel(), Yy.ravel(), Zz.ravel()], axis=1)

    # ---- DOWNWARD leg --------------------------------------------------
    # z runs from just above the cavity floor to 0.5 mm shy of the
    # slot's outermost Z (which sits past the part's outer bottom).
    down_z_start = +0.5
    down_z_end   = (-hp.WELL_FLOOR_T
                    - hp.WIRE_SLOT_Z_BELOW_FLOOR + 0.5)
    down_z = np.linspace(down_z_start, down_z_end, 9)
    # Bundle X span sits at the body-corner / slot-inboard edge; the
    # wire drops straight down out of the +X corner.
    down_x_centre = +hp.SERVO_BODY_W / 2.0 - hp.WIRE_SLOT_X_INBOARD + 0.5
    down_x = np.linspace(down_x_centre - H_HALF,
                         down_x_centre + H_HALF, 2)
    Xx, Yy, Zz = np.meshgrid(down_x, bundle_y, down_z, indexing="ij")
    downward_pts = np.stack([Xx.ravel(), Yy.ravel(), Zz.ravel()], axis=1)

    # ---- BOOT footprint ------------------------------------------------
    # The servo's molded +X wire-exit boot occupies the rectangular
    # volume just outside the body's +X face, between the body and
    # the well's +X cavity wall (and slightly into the wall thanks to
    # the WIRE_CHANNEL).  Sample a tight grid inside that volume and
    # require every sample to be CLEAR of part material so the boot
    # can sit there when the body is fully seated.
    boot_x_min = +hp.SERVO_BODY_W / 2.0 + 0.3
    boot_x_max = (+hp.SERVO_BODY_W / 2.0
                  + hp.WIRE_BOOT_PROTRUSION - 0.3)
    boot_y_half = hp.WIRE_BOOT_W / 2.0 - 0.3
    boot_z_min = hp.WIRE_BOOT_Z_BASE + 0.3
    boot_z_max = (hp.WIRE_BOOT_Z_BASE
                  + hp.WIRE_BOOT_H - 0.3)
    bx = np.linspace(boot_x_min, boot_x_max, 4)
    by = np.linspace(-boot_y_half, +boot_y_half, 3)
    bz = np.linspace(boot_z_min, boot_z_max, 3)
    Xx, Yy, Zz = np.meshgrid(bx, by, bz, indexing="ij")
    boot_pts = np.stack([Xx.ravel(), Yy.ravel(), Zz.ravel()], axis=1)

    return lateral_pts, downward_pts, boot_pts


def _probe_wire_corridor(part, name, R, t,
                          lateral_well, downward_well, boot_well):
    """Sweep the LATERAL and DOWNWARD wire-bundle corridors AND the
    +X wire-exit boot footprint through one cradle and report PASS iff:

      * the boot footprint is FULLY clear of part material (the body
        cannot seat unless the boot has a pocket to live in), AND
      * at least ONE of the lateral / downward corridors is fully
        clear so the harness can exit the cradle.
    """

    def _to_cradle(pts_well):
        if R is None:
            return pts_well + t
        return pts_well @ R[:3, :3].T + t

    lat_cradle  = _to_cradle(lateral_well)
    down_cradle = _to_cradle(downward_well)
    boot_cradle = _to_cradle(boot_well)

    lat_inside  = points_inside(part, lat_cradle)
    down_inside = points_inside(part, down_cradle)
    boot_inside = points_inside(part, boot_cradle)
    n_lat_blocked,  n_lat_total  = int(lat_inside.sum()),  len(lat_cradle)
    n_down_blocked, n_down_total = int(down_inside.sum()), len(down_cradle)
    n_boot_blocked, n_boot_total = int(boot_inside.sum()), len(boot_cradle)

    lat_ok  = n_lat_blocked  == 0
    down_ok = n_down_blocked == 0
    boot_ok = n_boot_blocked == 0
    # The boot MUST fit (no choice).  The wire needs ONE escape route.
    ok = boot_ok and (lat_ok or down_ok)

    detail = (
        f"boot {n_boot_total - n_boot_blocked}/{n_boot_total} clear "
        f"({'OK' if boot_ok else 'BLOCKED'}); "
        f"lateral {n_lat_total - n_lat_blocked}/{n_lat_total} clear "
        f"({'OK' if lat_ok else 'BLOCKED'}), "
        f"downward {n_down_total - n_down_blocked}/{n_down_total} clear "
        f"({'OK' if down_ok else 'BLOCKED'})"
    )
    return _label(name, ok, detail)


def check_wire_slot():
    """FULLY RETIRED (Aug 16 2026) -- no cradle carries a wire-exit
    L-corridor any more, so there is nothing left to probe.

    Retirement history (all the same stale-DS3225 story: the DS3225
    exited a 3-wire harness from a molded +X boot at the body's
    bottom-outboard corner; the STS3215 has NO boot -- its half-duplex
    bus leaves via BACK-face 5264 ports through each sandwich's open
    clamp face):

      * yaw / chassis_bottom (Jun 2026 front-face mount): the yaw
        harness routes through an inboard wire window verified
        end-to-end by ``check_leg_harness_drop`` ([3c]).
      * femur_link knee cradle (Aug 2026 flatten pass, user: "this top
        can just be a flat wall with no weird cutouts"):
        ``_sandwich_fixed_side(wire_exit=False)``.
      * coxa_link hip cradle -- the LAST holdout -- (Aug 16 2026, user:
        "a weird cutout channel on the opposite side ... pointless
        now"): the hip cradle now also builds with ``wire_exit=False``,
        so the corridor cut no longer exists anywhere.

    Kept as a stub (rather than deleted) so the CHECKS table, docs and
    historical logs keep a stable name; unconditionally passes."""
    print("\n[3b] Wire-exit L-corridor: RETIRED (Aug 16 2026 -- no cradle "
          "cuts a corridor; STS3215 harnesses leave via back-face ports)")
    return True


def check_leg_harness_drop():
    """Verify the per-leg cable drop slot through ``chassis_bottom``
    is unobstructed at every leg position.

    Part B (May 2026 wire-management pass) cut a small radial
    ``LEG_HARNESS_DROP_X_EXTENT`` x ``LEG_HARNESS_DROP_Y_EXTENT`` mm
    slot through ``chassis_bottom`` at each of the 6 leg positions,
    just inboard of each ``coxa_bracket``'s body cutout, so each
    leg's 3-cable harness can drop from the cradle wire-exit side
    of the plate straight into the inter-plate volume.  See the
    ``LEG_HARNESS_DROP_*`` constants block in ``hexapod_prototype.py``
    for the geometry rationale.

    This check probes a 3D corridor through the slot (the slot's XY
    span, plus the plate's full Z extent + 0.5 mm overshoot above
    and below) at each leg's bracket-local position, transforms it
    into chassis frame via the same ``_leg_chassis_frames()`` iterator
    that the chassis_bottom builder uses, and asserts EVERY probe
    point is OUTSIDE the chassis_bottom mesh (no plate material
    intrudes into the cable corridor).  Sibling to ``check_wire_slot``;
    listed in the standard ``CHECKS`` table.
    """
    print("\n[3c] Per-leg chassis_bottom harness drop slot:")
    cb = _load_mesh("chassis_bottom", copy=False)

    # Sample the slot's interior on a tight 3D grid.  X / Y stay 0.3 mm
    # inside the slot's nominal walls so a probe that lands ON the
    # slot edge isn't a false fail.  Z stays inside the chassis_bottom
    # plate's nominal Z extent ([-CHASSIS_PLATE_T/2, +CHASSIS_PLATE_T/2])
    # by a small XY-mode margin -- the check is "is the slot a clean
    # hole THROUGH the plate?", not "is everything below the plate
    # clear?".  (Historical note: an earlier revision printed a
    # vertical anchor tab hanging DOWN from the plate's -Z face just
    # outside the slot's Y span -- see the CABLE_ANCHOR_TAB_* constants
    # block in hexapod_prototype.py.  The tab was retired in May 2026
    # for printability; the harness now anchors through the drop slot
    # itself.  The Z margin is kept conservative to mirror the original
    # check's intent.)
    margin = 0.3
    half_z = hp.CHASSIS_PLATE_T / 2.0 - margin
    bz_local = np.linspace(-half_z, +half_z, 4)

    # One probe grid per slot in the shared single-source-of-truth list
    # (primary drop slot + tangential flanking ports); each grid stays 0.3 mm
    # inside its own nominal walls so an on-edge probe is not a false fail.
    slots = hp.leg_harness_drop_slots()
    slot_grids = []
    for (sx, sy, sxe, sye) in slots:
        half_x = sxe / 2.0 - margin
        half_y = sye / 2.0 - margin
        bx = np.linspace(-half_x, +half_x, 5) + sx
        by = np.linspace(-half_y, +half_y, 3) + sy
        BX, BY, BZ = np.meshgrid(bx, by, bz_local, indexing="ij")
        slot_grids.append(np.stack([BX.ravel(), BY.ravel(), BZ.ravel()], axis=1))

    all_ok = True
    for i, edge_mid, R, R3 in hp._leg_chassis_frames():
        for (sx, sy, sxe, sye), pts_bracket in zip(slots, slot_grids):
            # Transform bracket-frame probe points into chassis frame for
            # this leg: chassis = edge_mid + R3 @ bracket.
            pts_chassis = pts_bracket @ R3.T + edge_mid

            # Standoff SEAT-PAD exemption (Aug 16 2026): each of the 4
            # brass-standoff sites sits 15 deg off a leg axis, and the
            # Aug 2026 inboard port shift clipped its seat annulus -- the
            # builder now unions a Phi CHASSIS_STANDOFF_SEAT_PAD_OD pad
            # (full stack height) at every site, which deliberately bites
            # one corner of the adjacent port.  Probe points inside a pad
            # footprint (+0.3 mm skin margin) are INTENDED plate material,
            # not an obstruction, so drop them from the corridor test.
            pad_r = hp.CHASSIS_STANDOFF_SEAT_PAD_OD / 2.0 + 0.3
            in_pad = np.zeros(len(pts_chassis), dtype=bool)
            for (px, py) in hp.CHASSIS_STANDOFF_HOLES_XY:
                in_pad |= (np.hypot(pts_chassis[:, 0] - px,
                                    pts_chassis[:, 1] - py) <= pad_r)
            pts_chassis = pts_chassis[~in_pad]

            inside = points_inside(cb, pts_chassis)
            n_blocked = int(inside.sum())
            n_total = len(pts_chassis)
            ok = n_blocked == 0
            all_ok &= _label(
                f"leg_harness_drop_L{i} slot(x{sx:+.0f},y{sy:+.0f},"
                f"{sxe:.0f}x{sye:.0f})",
                ok,
                f"{n_total - n_blocked}/{n_total} probe points clear "
                f"({'OK' if ok else f'{n_blocked} BLOCKED'})",
            )
    return all_ok


# ---------------------------------------------------------------------------
# 4.  Self-collision of the standing-pose assembly
# ---------------------------------------------------------------------------

def _build_standing_leg():
    """Return (parts dict, name list) of the leg's printed parts placed
    in their standing-pose locations in the body's world frame, on the
    edge between hexagon vertex 0 and vertex 1 (apothem direction
    a = pi/6)."""
    apothem = hp.CHASSIS_FLAT_TO_FLAT / 2.0
    a = 0.5 * np.pi / 3
    edge_mid = np.array([apothem * np.cos(a), apothem * np.sin(a), 0.0])
    z_hat = np.array([0.0, 0.0, 1.0])

    # Design B (May 2026): yaw output stack collapsed from
    #   PLASTIC_HORN_H + HORN_ADAPTER_T = 9 mm
    # down to
    #   HORN_STACK_H = PLASTIC_HORN_H = 5 mm
    # now that the printed servo_horn_adapter has been retired.
    yaw_output_z = hp.CHASSIS_YAW_OUTPUT_Z
    hip_drop = hp.COXA_HIP_DROP
    hip_joint_local = np.array(hp.COXA_HIP_ANCHOR)
    # Jun 2026 bearing-sandwich refit: the moving link's local origin is
    # now the disc-horn-TOP (mating face) sitting ON the joint axis (the
    # yoke top arm bolts to the horn there), so the link origin coincides
    # with the joint-axis point -- no axial pad offset.  See
    # hexapod_prototype.make_femur_link / _leg_in_body_frame.
    PAD_AXIS_OFFSET = np.array([0.0, 0.0, 0.0])

    p = np.deg2rad(hp.STANCE_FEMUR_DEG)
    pt = np.deg2rad(hp.STANCE_FEMUR_DEG + hp.STANCE_TIBIA_DEG)
    Ry_p = rotation_matrix(p, [0, 1, 0])[:3, :3]
    knee_joint_local = hip_joint_local + Ry_p @ np.array([hp.FEMUR_LENGTH, 0, 0])

    parts = {}

    cl = _load_mesh("coxa_link")
    cl.apply_transform(rotation_matrix(a, [0, 0, 1]))
    cl.apply_translation(edge_mid + yaw_output_z * z_hat)
    parts["coxa_link"] = cl

    fl = _load_mesh("femur_link")
    fl.apply_transform(rotation_matrix(p, [0, 1, 0]))
    fl.apply_translation(hip_joint_local + PAD_AXIS_OFFSET)
    fl.apply_transform(rotation_matrix(a, [0, 0, 1]))
    fl.apply_translation(edge_mid + yaw_output_z * z_hat)
    parts["femur_link"] = fl

    tl = _load_mesh("tibia_link")
    tl.apply_transform(rotation_matrix(pt, [0, 1, 0]))
    tl.apply_translation(knee_joint_local + PAD_AXIS_OFFSET)
    tl.apply_transform(rotation_matrix(a, [0, 0, 1]))
    tl.apply_translation(edge_mid + yaw_output_z * z_hat)
    parts["tibia_link"] = tl

    # Sandwich-joint clamp caps clamp the hip + knee servos into their
    # cradles (closing the OPEN +Y cradle face).  Placed in the SAME
    # world frame via _place_servo_clamp_caps.
    caps = _place_servo_clamp_caps()
    parts["hip_clamp_cap"] = caps["hip_clamp_cap"]
    parts["knee_clamp_cap"] = caps["knee_clamp_cap"]

    return parts


def _pair_overlap_volume(a_mesh, b_mesh, pitch=1.5):
    """Estimate the overlap volume between mesh A and mesh B by voxel
    sampling A inside its AABB intersection with B, then counting how
    many of those voxel centres fall inside both meshes.

    The sample grid is INSET slightly from the AABB-intersection faces:
    ``linspace`` endpoints otherwise land EXACTLY on a designed flush-
    contact plane (e.g. the hip servo bottom resting on the coxa foot
    plate), where ``points_inside`` reads the shared boundary as inside
    BOTH bodies and inflates a zero-penetration rest plane into a full
    voxel slab of phantom "overlap" (knife-edge behaviour: the Aug 2026
    6805 bearing swap moved that plane 4 mm and flipped a stable PASS
    into a 2136 mm^3 FAIL with a true boolean intersection of 0 mm^3).
    Real interpenetrations are >= a few tenths of a mm deep, far beyond
    the 0.05 mm inset, so detection is unaffected."""
    a_min, a_max = a_mesh.bounds
    b_min, b_max = b_mesh.bounds
    eps = 0.05  # mm -- keep samples off exact coplanar contact faces
    lo = np.maximum(a_min, b_min) + eps
    hi = np.minimum(a_max, b_max) - eps
    if np.any(hi <= lo):
        return 0.0
    n = np.maximum(2, np.ceil((hi - lo) / pitch).astype(int))
    gx = np.linspace(lo[0], hi[0], int(n[0]))
    gy = np.linspace(lo[1], hi[1], int(n[1]))
    gz = np.linspace(lo[2], hi[2], int(n[2]))
    XX, YY, ZZ = np.meshgrid(gx, gy, gz, indexing="ij")
    pts = np.stack([XX.ravel(), YY.ravel(), ZZ.ravel()], axis=1)
    in_a = points_inside(a_mesh, pts)
    if in_a.sum() == 0:
        return 0.0
    pts_a = pts[in_a]
    in_b = points_inside(b_mesh, pts_a)
    n_overlap = int(in_b.sum())
    voxel_vol = pitch ** 3
    return n_overlap * voxel_vol


def check_self_collision():
    print("\n[4] Self-collision in standing pose (one leg):")
    parts = _build_standing_leg()
    names = list(parts.keys())

    # Connected pairs across rotational joints share a tiny shaft / horn
    # interface that legitimately overlaps geometrically.  Allow a
    # generous tolerance there; for non-adjacent parts require zero.
    JOINT_PAIRS = {
        ("coxa_link",    "femur_link"),
        ("femur_link",   "tibia_link"),
    }
    # Sandwich-joint clamp caps (Jun 2026) clamshell the hip/knee servo
    # against its cradle, so each cap legitimately interpenetrates the
    # cradle's printed walls (the clamp halves share boundary material
    # by design) AND brushes the moving link that drives off that joint.
    # These mating overlaps are intrinsic to the clamp, so they get the
    # generous CLAMP_TOLERANCE rather than the zero-overlap NONADJ rule.
    CLAMP_PAIRS = {
        ("coxa_link",  "hip_clamp_cap"),
        ("femur_link", "knee_clamp_cap"),
        ("tibia_link", "knee_clamp_cap"),
    }
    CLAMP_TOLERANCE = 1800.0
    # Adjacent printed parts at a rotary joint share NO printed
    # material -- the actual physical interface (disc horn + servo
    # gear stack) lives in dedicated horn-stack volume
    # which is checked separately by check_horn_stack_clearance.  So
    # we expect ZERO printed-vs-printed overlap here, modulo the
    # voxel-stair-step artefact along sharp mesh boundaries.  This
    # used to be 1500 mm^3 ("swallow the gear stack") which masked a
    # real ~ 800 mm^3 femur-spar-vs-coxa-link-arm clash that the user
    # reported as 'femur link cant rotate'.
    JOINT_TOLERANCE = 100.0
    NONADJ_TOLERANCE = 100.0

    all_ok = True
    for i, na in enumerate(names):
        for j, nb in enumerate(names):
            if j <= i:
                continue
            vol = _pair_overlap_volume(parts[na], parts[nb])
            adj = (na, nb) in JOINT_PAIRS or (nb, na) in JOINT_PAIRS
            clamp = (na, nb) in CLAMP_PAIRS or (nb, na) in CLAMP_PAIRS
            if clamp:
                tol, kind = CLAMP_TOLERANCE, "clamp"
            elif adj:
                tol, kind = JOINT_TOLERANCE, "joint"
            else:
                tol, kind = NONADJ_TOLERANCE, "non-adj"
            ok = vol <= tol
            all_ok &= _label(f"{na} vs {nb} ({kind})",
                               ok,
                               f"overlap = {vol:7.1f} mm^3 (tol {tol:.0f})")
    return all_ok


# ---------------------------------------------------------------------------
# 4a.  Printed-part pairwise INTERPENETRATION (exact boolean intersection)
# ---------------------------------------------------------------------------
#
# ``check_self_collision`` (above) is a VOXEL-sampled overlap test whose
# clamp-cap <-> link pairs carry a deliberately GENEROUS tolerance
# (CLAMP_TOLERANCE = 1800 mm^3) to absorb the voxel stair-step along the
# many flush faces where the clamp cap mates its cradle.  That tolerance
# is large enough to MASK a real printed-part interference: the clamp
# cap's top retaining lip used to overhang -Y to ``body_face_y - 4`` mm
# and bury ~560 mm^3 INSIDE the cradle's own top retaining plate (two
# solid printed parts occupying the same space -- impossible to assemble).
#
# This guard is the authoritative, voxel-free interference test for the
# printed parts that are MEANT to mate flush (share only a 0-volume
# contact face), computed with the EXACT manifold boolean intersection so
# the tolerance can be tight.  It covers the sandwich-joint clamp cap vs
# its bracket/cradle for BOTH driven joints (hip + knee), in the exact
# relative pose the assembly uses (the cap shares the bracket's
# ``_joint_place`` transform -- see ``_place_servo_clamp_caps``).

# A correctly-mating clamp cap touches its cradle only on flush faces
# (0 volume).  Allow a small budget for boolean facet noise on those
# coincident faces; the real defect this guards against is ~560 mm^3.
CLAMP_CAP_INTERFERENCE_TOL_MM3 = 20.0


def _boolean_overlap_volume(a, b):
    """Exact overlap volume via the manifold boolean intersection.

    Returns ``(volume_mm3, ok_bool)``.  Falls back to the robust voxel
    estimator (``_pair_overlap_volume``) if the boolean kernel errors out
    so a kernel hiccup can't silently pass a real clash."""
    try:
        inter = trimesh.boolean.intersection([a, b])
    except Exception:
        return _pair_overlap_volume(a, b, pitch=1.0), True
    if inter is None or len(getattr(inter, "faces", [])) == 0:
        return 0.0, True
    return abs(float(inter.volume)), True


def check_clamp_cap_interference():
    """The sandwich-joint clamp cap must mate its bracket/cradle FLUSH --
    no printed-vs-printed interpenetration.  Built from hexapod_prototype
    directly (like ``check_clamp_cap_alignment``) and posed exactly as the
    assembly does, then intersected with the EXACT boolean kernel."""
    print("\n[4a] Clamp-cap <-> bracket printed-part interpenetration:")

    cases = []
    # HIP: the hip cradle is part of the ONE-PIECE coxa_link (Aug 2026
    # merge); the builder already applies the hip _joint_place to its fixed
    # side, so the cap must get the SAME transform.
    hip_bracket = hp.make_coxa_link_part()
    hip_cap = hp.make_servo_clamp_cap()
    hip_cap.apply_transform(
        hp._joint_place(hp.COXA_HIP_ANCHOR, (1, 0, 0), hp.LEG_PITCH_AXIS))
    cases.append(("hip  coxa_link hip cradle vs hip_clamp_cap",
                  hip_bracket, hip_cap))

    # KNEE: the knee cradle is the femur_link's knee fixed side
    # (_femur_knee_fixed_solid, joint-local); the knee cap shares the
    # identical knee _joint_place, so their RELATIVE pose is identity.
    knee_bracket = hp._femur_knee_fixed_solid()
    knee_cap = hp.make_servo_clamp_cap()
    cases.append(("knee femur_link knee cradle vs knee_clamp_cap",
                  knee_bracket, knee_cap))

    all_ok = True
    tol = CLAMP_CAP_INTERFERENCE_TOL_MM3
    for name, bracket, cap in cases:
        vol, _ = _boolean_overlap_volume(bracket, cap)
        ok = vol <= tol
        all_ok &= _label(name, ok,
                         f"interpenetration = {vol:7.1f} mm^3 (tol {tol:.0f})")
    return all_ok


# ---------------------------------------------------------------------------
# 4b.  COMPREHENSIVE all-pairs printed-part interference over the FULL robot
# ---------------------------------------------------------------------------
#
# This is the AUTHORITATIVE, comprehensive replacement for the leg-only
# allow-list-of-pairs collision tests (``check_self_collision`` covers only
# {coxa,femur,tibia,clamp caps} on ONE leg; ``check_clamp_cap_interference``
# covers only 2 hard-coded clamp pairs).  Whole classes of printed-vs-printed
# interpenetration -- cap<->chassis, hub<->chassis, tray/dome<->chassis, the
# chassis split halves, the femur hip-yoke<->knee-bracket tube sockets, the
# foot tang<->pad fork -- were structurally UNCHECKED by those, and each was
# papered over until it bit during assembly.
#
# This gate assembles the ENTIRE static robot from EVERY printed part, in its
# nominal assembled pose, DECOMPOSED into the real printed parts (the
# ONE-PIECE coxa_link and femur_link, tibia_knee_yoke +
# TPU foot_boot, the two chassis halves, both clamp caps, both
# decks, the dome) -- not merged link proxies -- using the SAME
# authoritative scene placement that ``tools/full_robot_viz_build.py`` lays
# the buildviz scene out with (so poses are never re-invented and stay locked
# to the disc-horn / bearing world frame the rest of the verifier uses).  It
# then computes the EXACT boolean overlap (voxel fallback on kernel error) for
# every AABB-overlapping pair and requires it to be <= a tiny facet-noise
# budget, EXCEPT for an explicit, NAMED allow-list of DESIGNED flush / slip-fit
# mates (parts that share a coincident 0-volume contact face), each with a
# tight justified budget.
#
# NEW-PART CONTRACT: this check is gated on ALL_PRINTED_PARTS, so any printed
# part added in future is automatically pulled into the matrix.  A new part
# that genuinely interpenetrates another printed part with NO allow-list entry
# will FAIL the build.  Do NOT widen a budget or add an allow-list entry to
# silence a REAL volumetric clash -- the allow-list is ONLY for true flush /
# slip-fit mates whose real solid overlap is ~0 (facet noise).  Fix the
# geometry instead.

# Facet/voxel noise floor permitted for ANY printed-part pair (two manifold
# meshes that merely TOUCH still emit a few stray boolean facets).
ASSEMBLY_INTERFERENCE_NOISE_MM3 = 5.0

# Printed parts assembled by the gate (COTS -- bearings, CF tubes, servos,
# disc horns, lipo, PCBs -- are excluded; they are not printed).
_ASSEMBLY_PRINTED_PARTS = frozenset({
    "coxa_link", "yaw_bearing_cap",
    "femur_link",
    "tibia_knee_yoke", "foot_boot",
    "hip_clamp_cap", "knee_clamp_cap",
    "chassis_bottom", "chassis_top",
    
})

# NAMED allow-list of DESIGNED flush / slip-fit mates.  Each entry is a pair of
# printed parts that SHARE a coincident contact face (real solid overlap ~0);
# the budget is a tight facet-noise allowance, never a cover for a real clash.
ASSEMBLY_INTERFERENCE_ALLOW = {
    # Yaw bearing tower split: cap mates the chassis bottom tower at a flush
    # split face (YAW_SPLIT_Z); the 3 join bolts/ear bosses are coaxial.
    frozenset({"yaw_bearing_cap", "chassis_bottom"}):
        (25.0, "yaw tower split: flush split face (coaxial bolted join)"),
    # Yaw turntable hub (now the hub end of the ONE-PIECE coxa_link, Aug 2026
    # merge) seats in the chassis tower bore on the 6706 bearing stack -- a
    # running slip fit (coaxial), only facet noise at the seat.
    frozenset({"coxa_link", "chassis_bottom"}):
        (15.0, "yaw bearing seat: hub boss is a running slip fit in the tower"),
    # Hub rides the cap-captured upper 6706 inner race; the rotating hub has
    # running clearance to the stationary cap (flush at the race face only).
    frozenset({"coxa_link", "yaw_bearing_cap"}):
        (15.0, "yaw joint: hub runs against the cap-captured race, flush face"),
    # Sandwich-joint clamp caps clamshell their cradle bracket on flush faces
    # (the 0.2 mm tongue interference is against the COTS servo body, not the
    # printed bracket); guarded tightly by check_clamp_cap_interference too.
    frozenset({"coxa_link", "hip_clamp_cap"}):
        (25.0, "hip clamp cap clamshells the coxa_link hip cradle on flush faces"),
    # Jul 2026 merge #2: the knee cradle is part of the ONE-PIECE femur_link,
    # so the knee clamp cap clamshells femur_link directly (flush faces, same
    # mate the separate femur_knee_bracket had).
    frozenset({"femur_link", "knee_clamp_cap"}):
        (25.0, "knee clamp cap clamshells the femur_link knee cradle on flush faces"),
}


def _aabb_overlap(a, b, margin: float = 0.0) -> bool:
    a_lo, a_hi = a.bounds
    b_lo, b_hi = b.bounds
    return not (bool(np.any(a_hi < b_lo - margin))
                or bool(np.any(b_hi < a_lo - margin)))


def _assembly_interference_parts():
    """Return ``(core, neighbour)`` lists of ``(label, basename, mesh)`` for
    every PRINTED part of the full static assembly, built LIVE from
    hexapod_prototype and placed with full_robot_viz_build's authoritative
    scene transforms.

    ``core``      = leg-0 printed parts + the entire chassis / yaw / deck /
                    dome body (placed once).
    ``neighbour`` = leg-0 printed parts rotated to the adjacent +60 deg hex
                    edge, so leg<->leg adjacency is covered.  The chassis is
                    6-fold symmetric, so leg-0 + ONE neighbour is fully
                    representative of all six leg-chassis interfaces and all
                    six adjacent leg-leg pairs.
    """
    import sys as _sys
    import pathlib as _pathlib
    _tools = str(_pathlib.Path(__file__).resolve().parent / "tools")
    if _tools not in _sys.path:
        _sys.path.insert(0, _tools)
    import full_robot_viz_build as FRB  # noqa: WPS433

    core: list[tuple[str, str, object]] = []
    leg0: list[tuple[str, object]] = []
    for name, mesh in FRB._leg0_parts():
        if name in _ASSEMBLY_PRINTED_PARTS:
            core.append((name, name, mesh))
            leg0.append((name, mesh))
    for name, mesh in FRB._body_parts(0.0):
        if name in _ASSEMBLY_PRINTED_PARTS:
            core.append((name, name, mesh))

    R = rotation_matrix(np.pi / 3.0, [0, 0, 1])
    neighbour: list[tuple[str, str, object]] = []
    for name, mesh in leg0:
        m = mesh.copy()
        m.apply_transform(R)
        neighbour.append((f"{name}@leg+1", name, m))
    return core, neighbour


def check_assembly_interference():
    """COMPREHENSIVE all-pairs printed-part interference gate over the full
    static assembly (see the design note above).  Assembles EVERY printed part
    in its nominal pose (decomposed into the real printed parts, not the merged
    link proxies), then for every AABB-overlapping pair computes the EXACT
    boolean overlap and requires it <= a tiny facet-noise budget, except for a
    small NAMED allow-list of designed flush / slip-fit mates.

    This REPLACES the leg-only collision allow-list: new printed parts are
    pulled in automatically (gated on ALL_PRINTED_PARTS).  A new part that
    interpenetrates another with no allow-list entry FAILS the build -- fix the
    geometry, do not allow-list a real clash."""
    print("\n[4b] Assembly interference (all printed parts, full robot):")

    from itertools import combinations, product  # noqa: WPS433

    core, neighbour = _assembly_interference_parts()
    print(f"       assembled {len(core)} core printed parts "
          f"(leg 0 + chassis/yaw/deck/dome) + {len(neighbour)} neighbour-leg "
          f"parts")

    stats = {"ok": True, "checked": 0, "reported": 0}

    def _judge(la, ba, ma, lb, bb, mb):
        if not _aabb_overlap(ma, mb):
            return
        stats["checked"] += 1
        key = frozenset({ba, bb})
        allowed = key in ASSEMBLY_INTERFERENCE_ALLOW
        vol, _ = _boolean_overlap_volume(ma, mb)
        # Sub-noise & not a named mate -> a legitimately-just-touching pair;
        # clear it silently so the log isn't flooded with dozens of neighbours.
        if vol <= ASSEMBLY_INTERFERENCE_NOISE_MM3 and not allowed:
            return
        if allowed:
            budget, why = ASSEMBLY_INTERFERENCE_ALLOW[key]
            tag = f"flush mate, tol {budget:.0f}: {why}"
        else:
            budget = ASSEMBLY_INTERFERENCE_NOISE_MM3
            tag = (f"REAL interpenetration (tol {budget:.0f}) -- fix geometry, "
                   f"do NOT allow-list")
        stats["reported"] += 1
        ok = vol <= budget
        stats["ok"] &= _label(f"{la} vs {lb}", ok,
                              f"overlap = {vol:7.1f} mm^3 ({tag})")

    # Core all-pairs: leg 0 printed parts + the whole chassis/yaw/deck/dome.
    for a, b in combinations(core, 2):
        _judge(*a, *b)
    # Leg-leg adjacency: leg-0 LEG parts vs the +60 deg neighbour leg's parts
    # (chassis is shared, so skip body parts here -- already in core).
    leg0_legparts = [p for p in core if p[1] not in _CHASSIS_PARTS]
    for a, b in product(leg0_legparts, neighbour):
        _judge(*a, *b)

    print(f"       {stats['checked']} AABB-overlapping pairs examined; "
          f"{stats['reported']} above the "
          f"{ASSEMBLY_INTERFERENCE_NOISE_MM3:.0f} mm^3 noise floor")
    if stats["reported"] == 0:
        _label("no printed-part interpenetration above the noise floor",
               True, "")
    return stats["ok"]


# ---------------------------------------------------------------------------
# 5.  Servo-body clearance in standing pose
# ---------------------------------------------------------------------------

def _place_servo_bodies():
    """Return a dict of the three servo envelopes for one leg in the same
    world frame used by ``_build_standing_leg`` (apothem direction a=pi/6).

    Mirrors the placement math from ``build_prototype_assembly._build_leg``
    so the meshes land in their physically-correct cradle positions for the
    standing-pose check.
    """
    apothem = hp.CHASSIS_FLAT_TO_FLAT / 2.0
    a = 0.5 * np.pi / 3
    cos_a, sin_a = np.cos(a), np.sin(a)
    edge_mid = np.array([apothem * cos_a, apothem * sin_a, 0.0])
    z_hat = np.array([0.0, 0.0, 1.0])

    # Design B (May 2026): yaw output stack collapsed from
    #   PLASTIC_HORN_H + HORN_ADAPTER_T = 9 mm
    # down to
    #   HORN_STACK_H = PLASTIC_HORN_H = 5 mm
    # now that the printed servo_horn_adapter has been retired.
    yaw_output_z = hp.CHASSIS_YAW_OUTPUT_Z
    yaw_output_world = edge_mid + yaw_output_z * z_hat

    hip_drop = hp.COXA_HIP_DROP
    hip_joint_local = np.array(hp.COXA_HIP_ANCHOR)

    p = np.deg2rad(hp.STANCE_FEMUR_DEG)
    Ry_p = rotation_matrix(p, [0, 1, 0])[:3, :3]
    R_a = rotation_matrix(a, [0, 0, 1])

    # ----- Yaw servo: body hangs in the coxa-bracket well. -----
    # In bracket-local: body-bottom-centre at (-SERVO_OUTPUT_X, 0,
    # -WELL_RIM_Z), mesh +X aligned with bracket +X (radial outward).
    yaw = _load_mesh("servo_body")
    # Land the servo's OUTPUT (front) face at the disc-horn underside,
    # i.e. CHASSIS_YAW_OUTPUT_Z - HORN_STACK_H, so its output hub top
    # reaches CHASSIS_YAW_OUTPUT_Z where the coxa_link pad bolts on.
    # (The servo_body mesh has its front face at local z = WELL_RIM_Z.)
    # The legacy '-WELL_RIM_Z' shift predated the STS3215 refit where
    # WELL_RIM_Z == SERVO_BODY_H; it sank the hub to z~5 and left the
    # coxa hovering ~24 mm above the servo in the assembly view.
    yaw.apply_translation(
        [-hp.SERVO_OUTPUT_X, 0.0,
         hp.CHASSIS_YAW_OUTPUT_Z - hp.HORN_STACK_H - hp.WELL_RIM_Z])
    yaw.apply_transform(R_a)
    yaw.apply_translation(edge_mid)

    # ----- Hip-pitch servo: front-face mounted in the coxa's hip FIXED
    # side (bearing-sandwich refit, Jun 2026).  The fixed side is placed
    # by make_coxa_link at hp._joint_place((COXA_LENGTH, 0, COXA_HIP_DROP),
    # x=+X, z=+Y); the servo body shares that bracket-local frame, so we
    # apply the IDENTICAL transform to the servo envelope, then the coxa's
    # world placement (R_a + yaw-output translate).  Output axis -> +Y
    # (the hip-pitch axis), not the legacy downward well. -----
    M_hip = hp._joint_place(hp.COXA_HIP_ANCHOR, (1, 0, 0),
                            hp.LEG_PITCH_AXIS)
    hip = _load_mesh("servo_body")
    hip.apply_transform(M_hip)
    hip.apply_transform(R_a)
    hip.apply_translation(yaw_output_world)

    # ----- Knee servo: front-face mounted in the femur's knee FIXED side
    # (the femur_link's knee cradle).  That cradle is placed in femur-local by
    # hp._joint_place((FEMUR_LENGTH, -HORN_STACK_H, 0), x=+X, z=+Y); the
    # femur itself is then carried into the world by the same chain the
    # femur_link uses (pitch about Y, translate to hip axis + pad offset,
    # yaw about Z, yaw-output translate). -----
    M_knee = hp._joint_place((hp.FEMUR_LENGTH, 0.0, 0.0),
                             (1, 0, 0), hp.LEG_PITCH_AXIS)
    knee = _load_mesh("servo_body")
    knee.apply_transform(M_knee)
    knee.apply_transform(rotation_matrix(p, [0, 1, 0]))
    knee.apply_translation(hip_joint_local)
    knee.apply_transform(R_a)
    knee.apply_translation(yaw_output_world)

    return {"yaw_servo": yaw, "hip_servo": hip, "knee_servo": knee}


def _place_servo_clamp_caps():
    """Return the hip + knee sandwich-joint clamp caps for one leg in the
    SAME world frame as ``_place_servo_bodies``.

    The clamshell cap (``hp.make_servo_clamp_cap``) is modelled in the servo
    well-local frame (origin = body back face, +X long, +Y depth, +Z
    output), which is identical to the ``servo_body`` envelope frame -- so
    each cap uses the IDENTICAL transform chain as its servo body."""
    apothem = hp.CHASSIS_FLAT_TO_FLAT / 2.0
    a = 0.5 * np.pi / 3
    cos_a, sin_a = np.cos(a), np.sin(a)
    edge_mid = np.array([apothem * cos_a, apothem * sin_a, 0.0])
    z_hat = np.array([0.0, 0.0, 1.0])
    yaw_output_world = edge_mid + hp.CHASSIS_YAW_OUTPUT_Z * z_hat
    hip_drop = hp.COXA_HIP_DROP
    hip_joint_local = np.array(hp.COXA_HIP_ANCHOR)
    p = np.deg2rad(hp.STANCE_FEMUR_DEG)
    R_a = rotation_matrix(a, [0, 0, 1])

    M_hip = hp._joint_place(hp.COXA_HIP_ANCHOR, (1, 0, 0),
                            hp.LEG_PITCH_AXIS)
    hip_cap = hp.make_servo_clamp_cap()
    hip_cap.apply_transform(M_hip)
    hip_cap.apply_transform(R_a)
    hip_cap.apply_translation(yaw_output_world)

    M_knee = hp._joint_place((hp.FEMUR_LENGTH, 0.0, 0.0), (1, 0, 0),
                             hp.LEG_PITCH_AXIS)
    knee_cap = hp.make_servo_clamp_cap()
    knee_cap.apply_transform(M_knee)
    knee_cap.apply_transform(rotation_matrix(p, [0, 1, 0]))
    knee_cap.apply_translation(hip_joint_local)
    knee_cap.apply_transform(R_a)
    knee_cap.apply_translation(yaw_output_world)
    return {"hip_clamp_cap": hip_cap, "knee_clamp_cap": knee_cap}


def _place_yaw_retainers():
    """Return the yaw-servo capture stirrup for one leg in the leg-0 world
    frame (apothem dir a=pi/6), positioned coaxially under the yaw servo --
    the SAME Ra + edge_mid placement ``_place_servo_bodies`` uses for the yaw
    servo.  The strap is modelled in cradle-local XY + world Z, so only the
    in-plane yaw rotation + edge-midpoint translate are applied (no Z shift)."""
    apothem = hp.CHASSIS_FLAT_TO_FLAT / 2.0
    a = 0.5 * np.pi / 3
    edge_mid = np.array([apothem * np.cos(a), apothem * np.sin(a), 0.0])
    strap = hp.make_yaw_servo_retainer()
    strap.apply_transform(rotation_matrix(a, [0, 0, 1]))
    strap.apply_translation(edge_mid)
    return {"yaw_servo_retainer": strap}


def check_servo_clearance():
    """Each servo body should sit inside its cradle's air space, with at most
    a tiny overlap from the gear stack / spline / horn pocket that punches
    through the cradle face.  Non-adjacent printed parts (further along the
    leg) should not be touched by the servo body at all."""
    print("\n[5] Servo-body clearance in standing pose:")

    parts = _build_standing_leg()
    servos = _place_servo_bodies()

    # A servo lives in exactly one cradle; the adjacent printed part on the
    # output side hosts the gear stack passage (a couple cm^3 of overlap is
    # expected through the spline bore).  Everything else should be ~zero.
    CRADLE_PARENT = {
        "yaw_servo":  "chassis_bottom",
        "hip_servo":  "coxa_link",
        "knee_servo": "femur_link",
    }
    OUTPUT_NEIGHBOUR = {
        "yaw_servo":  "coxa_link",
        "hip_servo":  "femur_link",
        "knee_servo": "tibia_link",
    }
    # The clamp cap that CLAMPS each servo into its sandwich cradle (hip/knee;
    # yaw uses the saddle, no cap).  Its centre tongue is INTENTIONALLY a
    # press fit -- it reaches CLAMP_TONGUE_INTERF = 0.5 mm PAST the seated body
    # +Y face so the 2 cap bolts trap the body with zero slop (user request,
    # Jun 2026; 1.0 -> 0.5 Aug 26 2026 -- the cap top bowed around the screws).
    # This is a designed interference, not a collision, so the
    # servo-vs-its-own-cap pair gets a dedicated press-fit budget.
    CLAMP_CAP = {
        "hip_servo":  "hip_clamp_cap",
        "knee_servo": "knee_clamp_cap",
    }
    CRADLE_TOLERANCE = 600.0    # mm^3 -- tab plane resting on the rim
    OUTPUT_TOLERANCE = 1500.0   # mm^3 -- horn passage / gear stack
    # Intended 0.5 mm tongue press onto the body +Y face: true boolean overlap
    # is ~770 mm^3 (45 x 34 x 0.5 contact), but the pitch-1.5 voxel sampler
    # over-reads sub-pitch overlaps by up to a few thousand mm^3 depending on
    # grid alignment with the joint's pose (at the old 1 mm press it read up to
    # ~4250 vs ~1530 true).  Budget 6000 covers the voxel reading with margin
    # while still failing loudly on a gross bury (a tongue/flange sinking
    # several mm into the body is >> 10000).
    CLAMP_PRESS_TOLERANCE = 6000.0
    # Servo body next to a thin printed flange registers ~100-250 mm^3 of
    # voxel-sampling noise even when the surfaces are physically apart.
    # The cradle-openness check (using analytic probing) is the source of
    # truth for "the servo body is not blocked"; this tolerance catches a
    # real mechanical conflict (>= ~500 mm^3) without flaring on noise.
    OTHER_TOLERANCE = 300.0

    all_ok = True
    for servo_name, servo in servos.items():
        for part_name, part in parts.items():
            vol = _pair_overlap_volume(servo, part, pitch=1.5)
            if part_name == CRADLE_PARENT[servo_name]:
                tol = CRADLE_TOLERANCE
                kind = "cradle"
            elif part_name == OUTPUT_NEIGHBOUR[servo_name]:
                tol = OUTPUT_TOLERANCE
                kind = "output"
            elif part_name == CLAMP_CAP.get(servo_name):
                tol = CLAMP_PRESS_TOLERANCE
                kind = "clamp press-fit"
            else:
                tol = OTHER_TOLERANCE
                kind = "non-adj"
            ok = vol <= tol
            all_ok &= _label(
                f"{servo_name} vs {part_name} ({kind})",
                ok,
                f"overlap = {vol:7.1f} mm^3 (tol {tol:.0f})",
            )
    return all_ok


# ---------------------------------------------------------------------------
# 5b.  Horn-stack clearance inside output-side mating cylinders
# ---------------------------------------------------------------------------
#
# Why this check exists
# ---------------------
# Every rotary joint (yaw, hip-pitch, knee-pitch) connects the servo's
# spline to the next printed link via this physical stack, laid out
# along the joint axis (+Y in each driven part's local frame):
#
#     servo body  |  output gear  |  disc horn (link bolts here)
#     y < 0       |  y in [-6, 0] |  y in [0, +5]  -> y = HORN_STACK_H
#                                  ^               ^
#                                spline tip       link mating face
#                                = joint axis
#
# Design B (May 2026) + June 2026 disc-horn switch: the printed
# servo_horn_adapter and the plastic X-horn are both retired.
# The link's pad now bolts DIRECTLY onto the disc horn (the 20 mm
# aluminum 25T disc that screws onto the spline), so the horn stack is
# the disc horn alone -- HORN_STACK_H = PLASTIC_HORN_H = 5 mm (was 9 mm
# when the printed adapter sat on top of the plastic horn).
#
# The driven printed part (coxa_link for yaw, femur_link for hip-pitch,
# tibia_link for knee-pitch) sits ABOVE the disc horn at femur/tibia
# y >= HORN_STACK_H = +5, with a 4-bolt clamp pad on DISC_HORN_BOLT_PCD =
# 14 mm.  The part's "neck" / flange ring -- the material between the
# pad's mating face (y = HORN_STACK_H) and the spar's +Y face
# (y = LINK_THICKNESS/2 = +3) -- MUST be free of plastic anywhere
# inside the conservative horn-sweep envelope (still sized to the
# now-retired plastic X-horn) plus a small clearance margin.
#
# May 2026 "shorten-neck" refactor: the link's flange-ring inner
# radius switched from ``HORN_ADAPTER_OD/2 + 0.5`` = 16.5 mm (sized
# for the now-retired printed servo_horn_adapter) to
# ``HORN_STACK_VOID_R`` = ``PLASTIC_HORN_X_TIP_R + 0.5`` = 18.5 mm
# (sized for the now-retired plastic X-horn's Phi 36 mm sweep -- the user
# found that the previous Phi 33 mm cup physically blocked the
# Phi 36 mm horn from fitting; the smaller disc horn keeps that envelope
# as headroom).  This probe radius tracks the same constant so the
# verifier follows the link geometry automatically.
#
# This is exactly the failure mode the user reported as "the femur link
# doesn't let the end of the servo stick out high enough to connect to
# the tibia link" -- the tibia knee-pad's neck cylinder was a solid
# Phi HIP_PAD_R*2 = 34 mm column that punched straight through the
# Phi 32 mm horn-adapter footprint (the retired printed adapter).
#
# Test geometry
# -------------
# We build a single horn-stack cylinder of radius
# HORN_STACK_VOID_R (= PLASTIC_HORN_X_TIP_R + HORN_STACK_CLEARANCE =
# 18.5 mm) and height HORN_STACK_H, centred on the joint axis at
# y in [0, HORN_STACK_H], and probe each driven printed part for
# material inside that volume.  The check is done in each part's
# LOCAL frame -- both the femur and tibia have their joint axis at
# the origin with +Y along the horn-stack direction, so a single
# cylinder template works for both.
#
# Tolerance: the budget catches the well-defined "solid column"
# failure (~ 500-2000 mm^3 of interpenetration) without flaring on
# the < 50 mm^3 of voxel-stair-step artefact along the pad's bottom
# rim where the neck-clearance void's CYLINDRICAL boundary meets the
# pad's CIRCULAR-DISC boundary on slightly mismatched voxel grids.

HORN_STACK_CLEARANCE = 0.5   # mm -- radial clearance around the (retired) X-horn envelope tips
HORN_STACK_OVERLAP_TOL = 50.0  # mm^3 -- voxel-grid artefact budget
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
