lukas/hexapod-cad/fastener_registry.py

"""Explicit, world-space registry of every fastener in the hexapod prototype.

This module is the SINGLE SOURCE OF TRUTH for fastener placement.  Both
the build inspector (``inspect_build.py``) and the verifier
(``_verify_prototype.check_screwdriver_access``) read the same
``build_all_fastener_instances()`` list so a fastener never silently
drifts between the two tools.

Every entry mirrors one bolt-hole / nut-pocket cut that
``hexapod_prototype.py`` makes into a printed part.  The transforms
follow the SAME chain that ``build_prototype_assembly._build_leg`` /
``inspect_build._build_assembly_instances`` use to place each part in
the chassis frame, so adding ``chassis_lift`` to every fastener gives
the world pose used by the build inspector.

Frame
-----

The returned positions and axes live in the **pre-chassis-lift chassis
frame** (z = 0 is the chassis_bottom plate top face).  Callers that
need the lifted / Y-up render frame should apply the same lift /
rotation they apply to every other part.

Convention
----------

* ``head_world_xyz``: the centre of the fastener's HEAD outboard face --
  for an M3 SHCS this is the under-side of the cap (the face that
  bears on the part); for an M3 nyloc nut this is the FACE THAT FACES
  OUTWARD from the part (i.e. the visible outer face of the captive
  nut sitting in its hex pocket).
* ``axis_world``: a unit 3-vector pointing FROM the head INTO the
  material -- the direction you'd push the screw to drive it in.
  For a nut sat outboard of a wall, ``axis_world`` points from the
  outer (visible) nut face INTO the wall.

Enumerated categories (Design B + Design C, May 2026 revert)
------------------------------------------------------------

1. (RETIRED -- STS3215 reconciliation, Jun 2026) The model used to
   emit ``72 x M2.5 case screws`` on the servo OUTPUT face -- an
   invented "front-face 4-bolt case-screw mount" (4 per cradle x 3
   cradles (yaw / hip / knee) per leg x 6 legs = 72).  These were
   PHANTOM: the authoritative Waveshare ST3215 mount-bracket geometry
   shows the output face has NO usable body-mounting screws -- the
   dia-20 disc horn sits on the dia-14 disc-horn bolt cross and covers
   them.  All 72 have been removed.  Servo BODY retention is by printed
   parts only: the yaw servo by ``make_yaw_servo_retainer`` (a strap
   with its own anchor bolts), the hip/knee servos by the clamshell
   ``make_servo_clamp_cap`` (2 x M3 self-tap per joint -- see 14.).
   The output face now carries ONLY the flush disc horn + its 4 x M3
   leg bolts on DISC_HORN_BOLT_PCD = 14 mm (see 2.).

2. ``72 x M3 x 6 SHCS`` -- link-to-disc-horn bolts.  4 per joint
   (DISC_HORN_BOLT_PCD = 14 mm circle) x (yaw + hip + knee) = 3 joints
   per leg x 6 legs.  Threads downward from the printed link's pad
   face into the 20 mm aluminum 25T DISC horn (Amazon B07D56FVK5)
   that the servo joints drive.  PN_M3X6_SHCS / 91290A111 -- a plain
   M3 SHCS that threads into the disc's M3 TAPPED hole; the aluminium
   IS the thread-engagement medium (no heat-set insert, no self-tap
   into plastic).  June 2026 disc-horn switch: replaced the now-retired
   plastic 4-arm X-horn (PCD 20.8 mm, M2 self-tap) -- see the
   ``DISC_HORN_BOLT_*`` docstrings in ``hexapod_prototype.py``.  The
   M3 x 6 screws ship with the disc kit.

3. ``18 x M2.5 x 8 spline center screw`` -- ships with the servo; sits
   captive between the servo spline and the disc horn.  18 servos
   x 1 screw each = 18.  Special-cased in ``check_screwdriver_access``
   with a SKIP because the screw is hidden under the disc horn during
   normal assembly -- install before fitting the horn.  A Phi
   HORN_CENTRE_OD = 3.4 mm (M3 clearance) hole sits coaxial with the
   joint axis through EVERY driven link's pad:
     * yaw    -- ``centre_hole`` through the coxa_link pedestal cap
     * hip    -- ``hip_centre_hole`` through the femur hip pad (May 2026)
     * knee   -- ``knee_centre_hole`` through the tibia knee pad (May 2026)
   so the spline screw head + a hex driver have line-of-sight from
   the pad's outer face, which is what the user requested for
   serviceability ("the tibia link and femur link round joints need a
   hole in the center to attach the screw into servo behind it", May
   2026).  The skip flag is preserved because the install order is
   still "spline screw FIRST, disc horn SECOND, link THIRD" -- the new
   pad holes are an access-from-above improvement, not a sequence
   change.

4. (retired Aug 2026) -- the 6 M3 x 16 pan-head foot-hinge pins are gone
   with the hinged foot: the TPU ``foot_boot`` presses straight onto the
   tibia CF tube (see ``make_foot_boot``).  No fastener.

5. (retired Aug 2026) -- the 6 M3 nyloc nuts went with the hinge pins
   (4.).  With them gone the build needs NO nut driver and NO Phillips:
   every remaining screw is hex-socket except the M2.5 rear-case
   self-taps and the 4 M2 screen self-taps (off-registry, screen stand).
   Late-Aug 2026 review round 2 adds three more off-registry M3 x 8
   uses on the electronics deck (same 91290A113 stock): 3 screen-stand
   feet (driven UP through the round plate into blind Phi 2.5 self-tap
   pilots -- this closed the old spec gap where the stand's 6 clearance
   holes implied 6 unlisted nuts) and 3 Uno Q mount bolts (down into M3
   thumb nuts, finger-tight; thumb nuts are hand hardware, not a new
   driver).

(May 2026 Design F: the previous categories 4 + 5 -- ``24 x M3 x 32 SHCS``
coxa-bracket-to-chassis bolts and 24 matching M3 nyloc nuts -- have been
RETIRED.  The standalone ``coxa_bracket`` part has been folded into
``chassis_bottom`` as a printed-in cradle, so there is no bracket flange
to clamp through the chassis plates.)

6. ``8 x M3 deck board-mount bolts`` -- Deck redesign (Jun 2026): the
   clip-in battery_holder is RETIRED (the LiPo is now velcro-strapped
   to the top of chassis_bottom through cut strap slots -- no bolts),
   and the stacked electronics deck carries the brain.  4 x M3 x 8 SHCS
   bolt the Arduino Uno Q DOWN onto the lower ``uno_q_tray`` and 4 x M3
   x 8 SHCS bolt the XINGYHENG buck converter DOWN onto the upper
   ``buck_tray``, each threading into an M3 brass heat-set insert in a
   printed tray boss on the board's hole pattern (UNO_Q_HOLES /
   BUCK_HOLES).  Emitted by ``_emit_deck_fasteners``.

7. ``8 x M3 heat-set inserts`` -- one per deck board-mount bolt (see
   6.).  Brass heat-set inserts pressed into the tray bosses.

10. ``8 x M3 x 10 deck standoff-column bolts`` -- Deck redesign
    (Jun 2026).  The two trays stack on 4 M3 brass standoff columns
    rising ABOVE chassis_top on the ``DECK_COLUMN_XY`` (+/-41, +/-33)
    pattern.  4 x M3 x 10 SHCS bolt the ``uno_q_tray`` DOWN onto the
    level-1 columns and 4 x M3 x 10 SHCS bolt the ``buck_tray`` DOWN
    onto the level-2 columns, each threading into the brass standoff's
    female top thread (modeled as a VIRTUAL heat-set-insert engagement
    target, like the chassis standoffs in 18.).  Emitted by
    ``_emit_deck_fasteners``.

11. ``4 x M3 x 8 SHCS`` -- UP from below chassis_top into the lowest
    (level-1) F-F deck standoff columns' female bottom threads at the
    4 ``DECK_COLUMN_XY`` positions (see 10.).  Jul 2026 F/F switch:
    replaces the old male-stud + nyloc retention.

12. (retired Aug 16 2026) -- the 2 switch_holster mount bolts are gone:
    the holster velcros to the flat deck (bosses, inserts, ear, and
    clearance holes all deleted from the CAD).

13. (retired Aug 16 2026) -- the 2 switch_holster heat-set inserts went
    with 12.

14. ``24 x M3 x 8 SHCS`` -- sandwich-joint clamp-cap bolts.  Deck
    redesign (Jun 2026): 2 self-tapping M3 x 8 SHCS per ``servo_clamp_cap``
    drive DOWN through the cap into the cradle ±X wall-end pilots that
    already exist in ``_servo_well_solid``.  12 clamp caps robot-wide
    (1 per hip + knee sandwich joint, 2 per leg x 6 legs) = 24 bolts.
    Emitted by ``_emit_clamp_cap_fasteners`` inside the per-leg loop.

15. (retired) -- the M2.5 Pi board-mount inserts are gone with the
    Raspberry Pi (see 6./10.).

16. (retired) -- the electronics_tray chassis-mount bolts are gone
    with the in-gap electronics_tray (see 6./10.).

17. (retired) -- the chassis_bottom tray-mount heat-set inserts are
    gone with the electronics_tray.

18. ``4 x M3 x 10 SHCS`` -- chassis_top -> brass-standoff bolts.
    Threads DOWN from above chassis_top into the F-F brass
    standoff's female top threads.  4 sites at
    ``HP.CHASSIS_STANDOFF_HOLES_XY`` = (+/-31.1, +/-31.1) mm -- the
    44-mm-radius diagonal pattern (Jul 2026 battery-fit rework:
    moved off (+/-35, 0)/(0, +/-35) so the real 138 x 46 mm LiPo
    has a clear lane through the inter-plate bay).  Modeled
    engagement target is a VIRTUAL SPEC_M3_HEATSET_INSERT entry at
    the top of the standoff (= chassis_top bottom face) so the
    verifier's engagement check pairs the bolt correctly -- the
    actual brass standoff hardware is unmodeled.

19. ``4 x M3 x 14 SHCS`` -- UP from below chassis_bottom (head on the
    -6 mm floor face, through the 8 mm plate + floor stack) into the
    F-F brass standoff's female BOTTOM threads at the same 4 standoff
    XY positions (see 18.).  Jul 2026 F/F switch: replaces the old
    M-F male stud + nyloc, which could not span the 8 mm-thick
    merged chassis_bottom.  Accessible from below the robot.

LATE-AUG 2026 SKU AUDIT (design-review "fastener diet")
--------------------------------------------------------
Live census from ``build_all_fastener_instances()`` after the TPU-boot,
integrated-tray, and Aug 16 2026 coxa changes (hip end-face screws
retired, yaw hub bolts M3x20 -> M3x30, switch-holster bolt-down mount
retired for velcro) -- 248 fasteners, 8 purchased SKUs:

  ===  =================================  ==========  =====================
  qty  spec                               McMaster    why this length
  ===  =================================  ==========  =====================
   96  M3x10 disc-horn SHCS               91290A114   driven-horn stack
   24  M3x30 disc-horn SHCS               91290A123   yaw hub stack (user's
                                                      M3x30 stock, Aug 16
                                                      2026; was M3x20 --
                                                      heads now 10 mm
                                                      higher for driver
                                                      access)
   42  M3x8 SHCS self-tap                 91290A113   clamp caps + bearing
                                                      caps (wall pilots)
    4  M3x8 SHCS                          91290A113   chassis_top ->
                                                      standoff top thread
    4  M3x14 SHCS                         91290A115   spans the 8 mm merged
                                                      chassis_bottom into
                                                      the standoff bottom
   24  M3x6 SHCS self-tap                 91290A111   retainer anchors: an
                                                      x8 tip would stand
                                                      1 mm proud of the
                                                      plate (pilot bottoms
                                                      at -3); ships free
                                                      with the disc kits
   30  M2.5x8 SHCS (spline + board)       91290A104   servo spline screws
                                                      (the 24 hip end-face
                                                      CASE screws retired
                                                      Aug 16 2026 with
                                                      their holes)
   24  M2.5x6 self-tap (rear case)        96877A150   4 mm rear-shell bite
  ===  =================================  ==========  =====================

(The M3 heat-set insert SKU 94459A130 left the build entirely with the
Aug 16 2026 velcro swap -- the 2 switch-holster inserts were the LAST
real inserts; the standoff "insert" entries are virtual engagement
targets, not hardware.)

Verdict: no further merges are free.  Every remaining length is pinned
by an engagement geometry the verifier checks (M3x6 tip clearance,
M3x14 plate span, M3x30 hub stack).  The foot hinge's pan-head
+ nyloc (the last non-hex-key hardware) left with the Aug 2026 boot;
the 2 lone M3x10 holster bolts (the last 91290A114 oddballs outside the
disc-horn stock) left with the Aug 16 2026 velcro swap.

Off-registry (deck, not emitted by this module): 4 x M2 screen
self-taps, and -- review round 2 -- 6 x M3x8 (3 screen-stand feet into
blind pilots + 3 Uno Q bolts into M3 thumb nuts); all draw on stock
already in the BOM, zero new SKUs.
"""

from __future__ import annotations

from dataclasses import dataclass, field
from typing import Tuple

import numpy as np


import hexapod_prototype as HP


# ---------------------------------------------------------------------------
# McMaster-Carr part numbers (verify with fasteners/README.md)
# ---------------------------------------------------------------------------
# Centralised so the BOM, the inspector legend, and the fasteners/
# README stay in sync.  If McMaster renumbers a SKU, edit here only.

PN_M3X8_SHCS     = "91290A113"   # M3 x 8  socket-head cap screw, black-oxide steel
PN_M25X8_BOARD_SHCS = "91290A102"  # M2.5 x 8 SHCS used as a board-mount bolt
                                   # threaded into a Phi 3.0 mm M2.5 brass
                                   # heat-set insert in the electronics_tray.
                                   # Same stock as PN_M25X8_SHCS (the servo
                                   # spline screw); the distinct PN here
                                   # surfaces the role in the BOM so the
                                   # user buys both sets together.
PN_M25_HEATSET_INSERT = "94459A106"  # M2.5 brass heat-set insert, knurled
                                      # (McMaster).  Pilot Phi 3.0 mm,
                                      # length 4.0 mm, recommended pilot
                                      # depth 4.5 mm.  4 of these mount the
                                      # Raspberry Pi 4 / Pi 5 onto the
                                      # electronics_tray (May 2026).
PN_M3X10_SHCS    = "91290A114"   # M3 x 10 socket-head cap screw, black-oxide
                                  # steel (chassis_top -> standoff-top bolts,
                                  # deck-tray column bolts, driven disc-horn
                                  # bolts; the battery_holder foot bolts that
                                  # used this stock are retired)
PN_M3X30_SHCS    = "91290A123"   # M3 x 30 socket-head cap screw (yaw hub
                                  # stack; Aug 16 2026, user's own M3x30
                                  # stock -- replaced the M3x20/91290A120,
                                  # lifting the head seat 10 mm for driver
                                  # access.  Same stock the legacy
                                  # PN_M3X32_SHCS label points at.)
PN_M3_HEATSET_INSERT = "94459A130"   # M3 brass heat-set insert, knurled (McMaster)
PN_M3X14_SHCS    = "91290A115"   # M3 x 14 socket-head cap screw (Jul 2026 F/F
                                  # standoff switch: enters chassis_bottom's -6
                                  # bottom face, spans the 8 mm plate + floor
                                  # stack and threads ~6 mm into the brass F-F
                                  # standoff's bottom female thread)
PN_M3X32_SHCS    = "91290A123"   # M3 x 30 socket-head cap screw (closest stock to 32 mm)
PN_M3_NYLOC      = "90576A102"   # M3 nylon-insert lock nut, A2 stainless
PN_M3X16_PAN     = "92010A130"   # M3 x 16 pan-head Phillips, A2 stainless (foot hinge)
PN_M25X8_SHCS    = "91290A104"   # M2.5 x 8 socket-head cap screw (servo spline)
PN_M25X6_SELFTAP = "96877A150"   # M2.5 x 6 self-tapping screw (yaw rear CASE-mount;
                                 # threads the STS3215 FIXED rear-face case holes
                                 # at cradle (-8.3/-32.8, +-10.2), ~2.5 mm bite --
                                 # user opted for a self-tapper for the shallow holes)
# Link-to-disc-horn bolts (June 2026 disc-horn switch; see the
# DISC_HORN_BOLT_* docstrings in hexapod_prototype.py).  The
# servo joints now drive a 20 mm aluminum 25T DISC horn (Amazon
# B07D56FVK5) with 4 x M3 TAPPED holes on a 14 mm bolt circle.  The
# link's pad has a Phi 3.4 mm M3 clearance hole; the M3 SHCS threads
# DIRECTLY into the disc's tapped hole -- the aluminium IS the thread-
# engagement medium (no heat-set, no self-tap into plastic).  M3 x 6
# screws ship with the disc kit; we use that length (3-5 mm of
# engagement into the 5 mm disc depending on pad thickness).
PN_M3X6_SHCS     = "91290A111"   # M3 x 6 socket-head cap screw (ships with disc)
# May 2026 revert: the brief Design C horizontal-nyloc cradle bolt
# (PN_M3X14_SHCS = 91290A115) was retired in favour of vertical M3 x 8
# self-tap SHCS into Phi 2.5 mm printed pilots, reusing the existing
# M3 x 8 stock used as servo cradle mount bolts.
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
