lukas/hexapod-cad/(commit log)

2026-09-15 Import the STS3215 hexapod CAD pipeline from lukas/hexapod
    Snapshot of hexapod_walker/prototype_sts3215 CAD, print, BOM, strength,
    BuildViz and concept-variant code at lukas/hexapod commit c3113d88b, plus
    prototype_ak40 and vehicles from that repo's root. History up to the split
    stays browsable in lukas/hexapod. Standalone pyproject (CAD toolchain),
    Makefile with the former CAD targets at repo-relative paths, and an optional
    `sim` extra that path-depends on ../hexapod for the bridges that import the
    robot repo's joint contract or sim env. build_mesh_model.py carries its own
    copy of the terrain heightfield constants instead of importing the robot
    repo's MuJoCo primitive model.
    Co-Authored-By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
2026-09-22 Add rounded sensor foot with bottom glue sockets and pinned cylinder
    Adds the requested isolated sensor-foot concept, reproducible generator, printable parts and BuildViz scene. Retires the initial half-circle approach, retained as a labeled draft. The final v5 pair puts sockets in the bottom and pins on the 20 mm cylinder for easier printing; no production robot geometry changes.
2026-09-22 Replace bonded sensor foot with guided ground-contact prototype
    Retire the fixed glue joint and oversized sleeve. Add a 16 mm rod socket with closed pressure web, TPU pad, 0.6 mm travel stop and snap-on TPU return collar. Preserve a wire exit and print-oriented exports. Rigid geometry checks pass; TPU availability is assumed and physical threshold, return, retention and printing remain unvalidated.
2026-09-22 Keep wire exit clear of contact pad backing
    Retire the over-wide wire cut under the central actuator; add a full-area backing assertion while retaining sensor and travel clearance checks.
